Aitoubella/Freezer_FW/Firmware/Cold Storage/TouchGFX/assets/images/bat.png

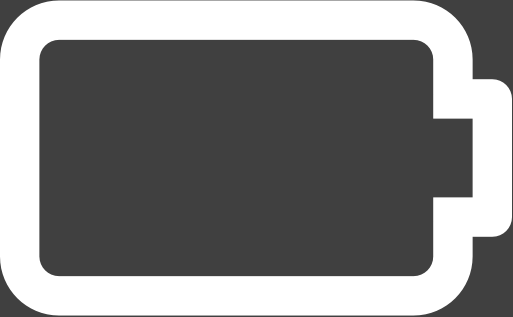
Firmware/Cold Storage/TouchGFX/assets/images/bat.png
