Aitoubella/Freezer_FW/Firmware/Cold Storage/TouchGFX/assets/images/charging.png

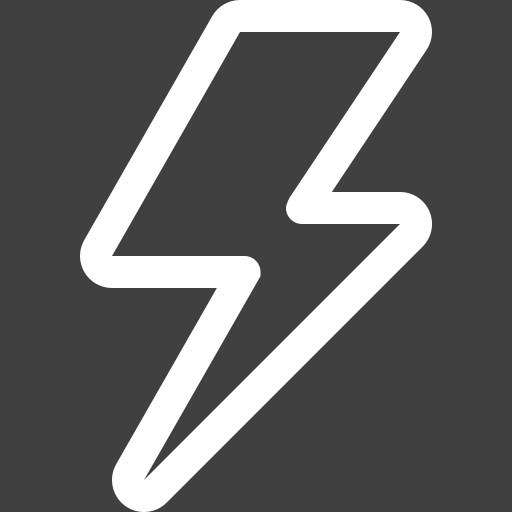
Firmware/Cold Storage/TouchGFX/assets/images/charging.png
