Aitoubella/Freezer_FW/Firmware/Cold Storage/TouchGFX/assets/images/main_speaker_on.png

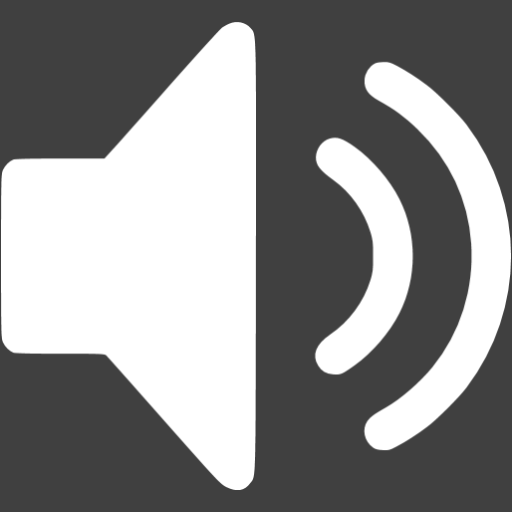
Firmware/Cold Storage/TouchGFX/assets/images/main_speaker_on.png
