Aitoubella/Freezer_FW/Hardware/Freezer_Controller/Fabrication files/Freezer_Controller_BOM.xlsx

LibRef | Designator | Quantity | Supplier 1 | Supplier Part Number 1
NS00832 | C1, C2, C11, C14, C15, C16, C26, C27, C35_1, C35_2, C35_3, C35_4, C35_5, C35_6, C38, C39, C40, C41, C43, C44, C45, C46, C47, C48, C54, C59, C60, C61, C62, C63, C64, C65, C76, C77, C80, C86 | 36 | Digi-Key | 1276-6767-1-ND
NS00871 | C3, C13, C52, C53 | 4 | Digi-Key | 1276-6470-1-ND
NS00848 | C4, C5, C6, C34_1, C34_2, C34_3, C34_4, C34_5, C34_6, C55, C56, C57, C58, C78, C79, C81, C82, C83, C84, C85, C88, C94 | 22 | Digi-Key | 445-172665-1-ND
NS00840 | C7, C8, C9, C10 | 4 | Digi-Key | 478-1175-1-ND
NS00353 | C12, C17, C22, C23, C24, C25, C36_1, C36_2, C36_3, C36_4, C36_5, C36_6, C37_1, C37_2, C37_3, C37_4, C37_5, C37_6, C71, C87 | 20 | Digi-Key | 478-1395-1-ND
NS00847 | C18, C19, C20, C21 | 4 | Digi-Key | 732-12187-1-ND
CMP-0001-00074-2 | C28, C30, C32, C70, C73, C74, C75 | 7 | Digi-Key | 399-C0402C104K4RAC7867TR-ND
Cap Semi | C29, C31, C33 | 3 | Digi-Key | 399-C1206C105K4RAC7800TR-ND
NS00911 | C42, C49 | 2 | Digi-Key | PCE5051CT-ND
NS00779 | C50, C51, C72 | 3 | Digi-Key | 1276-CL32Y106KCVZNWECT-ND
NS00824 | C66, C67, C68, C69 | 4 | Digi-Key | 1276-3137-1-ND
NS00857 | D1, D2, D5, D6, D7, D10 | 6 | Digi-Key | 112-V3PM10-M3/HCT-ND
NS00945 | D3, D8, D9 | 3 | Digi-Key | 3147-B1911USD-20D000114U1930CT-ND
NS00890 | D4 | 1 | Digi-Key | SMBJ28CAQ-13-FDICT-ND
NS00949 | F1 | 1 | Digi-Key | 283-3153-1-ND
NS00881 | FB1, FB2, FB3, FB4, FB5, FB6, FB7, FB11, FB12 | 9 | Digi-Key | 732-782853162CT-ND
NS00883 | FB10, FB16 | 2 | Digi-Key | 490-16523-1-ND
DS1307Z+ | IC1 | 1 | Digi-Key | DS1307Z+-ND
PCA9306DQER | IC2 | 1 | Digi-Key | 296-27957-2-ND
NS00813 | J1 | 1 | Digi-Key | FH34SRJ-50S-0.5SH(50)
Header 4X2 | J2 | 1 | Digi-Key | 900-2068320823-ND
NS00894 | J3 | 1 | Digi-Key | WM11767-ND
NS00337 | J4 | 1 | Digi-Key | WM2702-ND
NS00892 | J5 | 1 | Digi-Key | SAM8941-ND
NS00898 | J6 | 1 | Digi-Key | SAM10577-ND
NS00896 | J7 | 1 | Digi-Key | SAM8824-ND
CMP-11597-000004-1 | J8 | 1 | Digi-Key | HR1942TR-ND
NS00831 | L1, L4, L5 | 3 | Digi-Key | 553-3631-ND
NS00257 | L2, L3 | 2 | Digi-Key | 445-8644-1-ND
NS00042 | L6, L7, L8 | 3 | Digi-Key | SRF2012-900YATR-ND
NS00953 | L9 | 1 | Digi-Key | 553-PE-1210CCMC601STSCT-ND
Inductor | L10 | 1 | Digi-Key | 490-5622-2-ND
150060GS73220 | LED1 | 1 | Digi-Key | 732-11995-2-ND
CMP-231724-000001-1 | LS1 | 1 | Digi-Key | 668-1019-ND
Header 4 | P1 | 1 | Digi-Key | SAM1112-04-ND
NS00873 | Q1, Q3, Q4, Q6, Q7, Q8, Q9, Q11 | 8 | Digi-Key | DMN67D8L-7DICT-ND
NS00910 | Q2, Q5 | 2 | Digi-Key | DMP3056L-7DICT-ND
CMP-1048-01467-1 | Q10 | 1 | Digi-Key | BC547BFS-ND
NS00258 | R1, R6, R64, R65, R66, R113, R114 | 7 | Digi-Key | 36-5106CT-ND
NS00835 | R2, R5, R25, R50, R53, R62, R93, R96, R98, R99, R102, R118, R120, R122, R124 | 15 | Digi-Key | RMCF0603FT100KCT-ND
NS00882 | R3, R4, R70 | 3 | Digi-Key | RMCF0603FT1K00CT-ND
NS00820 | R7, R8, R21, R32_1, R32_2, R32_3, R32_4, R32_5, R32_6, R37, R38, R42, R45, R46, R48, R52, R55, R58, R60, R63, R71, R72, R73, R83, R84, R85, R86, R87, R88, R94, R100, R117 | 32 | Digi-Key | RMCF0603FT10K0CT-ND
NS00814 | R9, R10, R11, R13 | 4 | Digi-Key | 1292-WR06X68R0FTLCT-ND
NS00876 | R12, R14, R15, R16, R17, R18, R19, R20, R24, R44, R74, R75, R76, R77, R78, R79, R82, R89, R90, R91, R105, R108, R110, R126, R127 | 25 | Digi-Key | RMCF0603ZT0R00CT-ND
 | R29, R128, R129 | 3 | Digi-Key | TNPW040210K0BEED
Res3 | R22, R23, R26, R130, R131 | 9 | Digi-Key | 311-10KDTR-ND
RES | R132 | 1 | Digi-Key | A119933TR-ND
CMP-02407-007689-1 | R27 | 1 | Digi-Key | MCT0603-150-MBTR-ND
CMP-2000-04568-2 | R28 | 1 | Digi-Key | 311-20KDTR-ND
NS00884 | R30_1, R30_2, R30_3, R30_4, R30_5, R30_6 | 6 | Digi-Key | YAG2308CT-ND
NS00796 | R31_1, R31_2, R31_3, R31_4, R31_5, R31_6, R41, R54, R92 | 9 | Digi-Key | 1292-WR06X10R0FTLCT-ND
NS00885 | R33_1, R33_2, R33_3, R33_4, R33_5, R33_6, R35_1, R35_2, R35_3, R35_4, R35_5, R35_6 | 12 | Digi-Key | YAG1236CT-ND
NS00886 | R34_1, R34_2, R34_3, R34_4, R34_5, R34_6, R36_1, R36_2, R36_3, R36_4, R36_5, R36_6 | 12 | Digi-Key | YAG1555CT-ND
NS00834 | R39, R40, R51, R57, R95, R119, R121, R123 | 8 | Digi-Key | 1292-WR06X1502FTLCT-ND
NS00837 | R43, R56, R97, R101 | 4 | Digi-Key | RMCF0603FT300KCT-ND
NS00875 | R47, R49, R59, R61 | 4 | Digi-Key | 311-2.00MHRCT-ND
NS00870 | R67, R68, R80, R81, R103, R104, R115, R116 | 8 | Digi-Key | RMCF0603FT100RCT-ND
NS00946 | R69, R106, R107 | 3 | Digi-Key | 738-RMCF1206FT2R00CT-ND
NS00821 | R109 | 1 | Digi-Key | RMCF0603FT191KCT-ND
NS00822 | R111 | 1 | Digi-Key | RMCF0603FT42K2
NS00823 | R112, R125 | 2 | Digi-Key | RMCF0603FT26K7
CMP-17879-000003-1 | S1 | 1 | Digi-Key | EG4344TR-ND
NS00879 | U1 | 1 | Digi-Key | PAM8304AYRDICT-ND
NS00922 | U2 | 1 | Digi-Key | MT25QL512ABB8E12-0AUT-ND
CMP-1655-00015-2 | U3 | 1 | Digi-Key | 497-15873-ND
3034 | U4 | 1 | Digi-Key | 36-3034-ND
NS00864 | U6_1, U6_2, U6_3, U6_4, U6_5, U6_6, U7, U8, U16 | 9 | Digi-Key | LM2904QS-13DICT-ND
NS00913 | U9, U12, U13, U14, U15, U19 | 6 | Digi-Key | 283-STSP84050U800CT-ND
NS00912 | U10 | 1 | Digi-Key | 296-35520-1-ND
NS00919 | U11 | 1 | Digi-Key | MCP1501T-10E/CHYCT-ND
NS00880 | U18 | 1 | Digi-Key | 497-1222-1-ND
CMP-05722-000278-1 | U20 | 1 | Digi-Key | MAXM17503ALJ+-ND
ABS07W-32.768KHZ-J-1-T | Y1 | 1 | Digi-Key | XC2745TR-ND
ABS07-32.768KHZ-T | Y2 | 1 | Digi-Key | 535-9542-2-ND
