Aitoubella/Freezer_FW/X-cool connection guide/20231208_X-COOL CONNECTION GUIDE .pdf

# X-COOL CONNECTION GUIDE

## (Controller and Power Board)

1.Power board and Controller board Connection

- 12 Pin Connector

The power board and controller board are connected to each other with a cable through a 12 pin header.

The newly designed Version 2 ensures consistency of all nets of the 12 pin header.

The connection method is as follows.

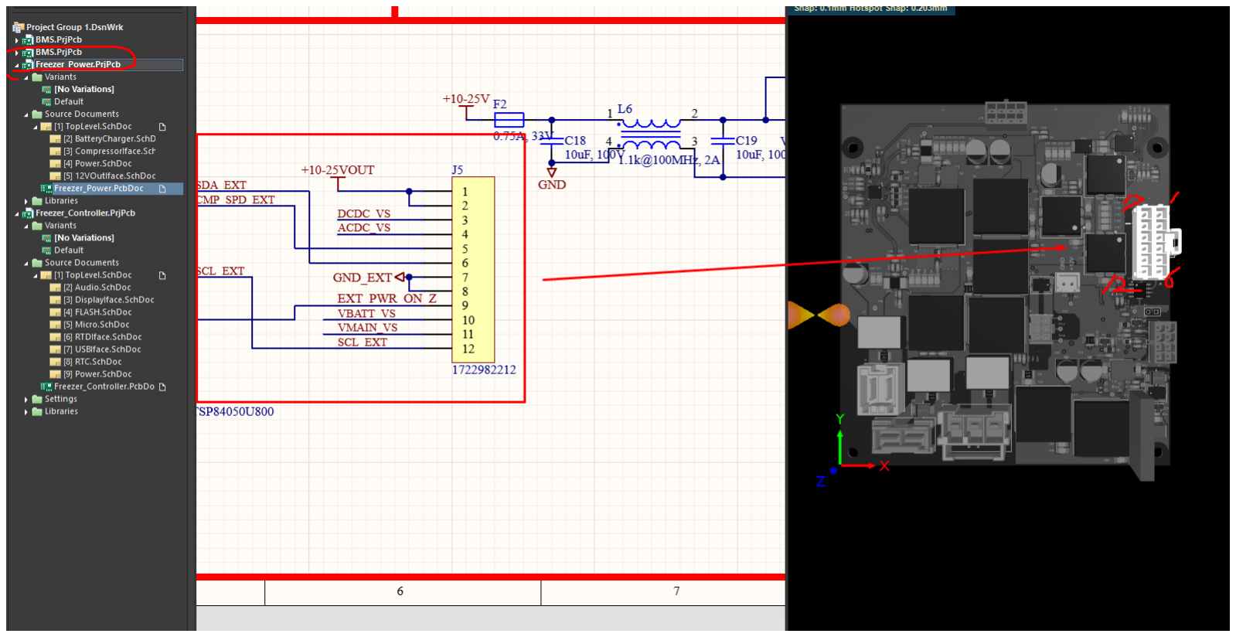
[picture p9: figure]

Figure 1. Power Board J5 Connector

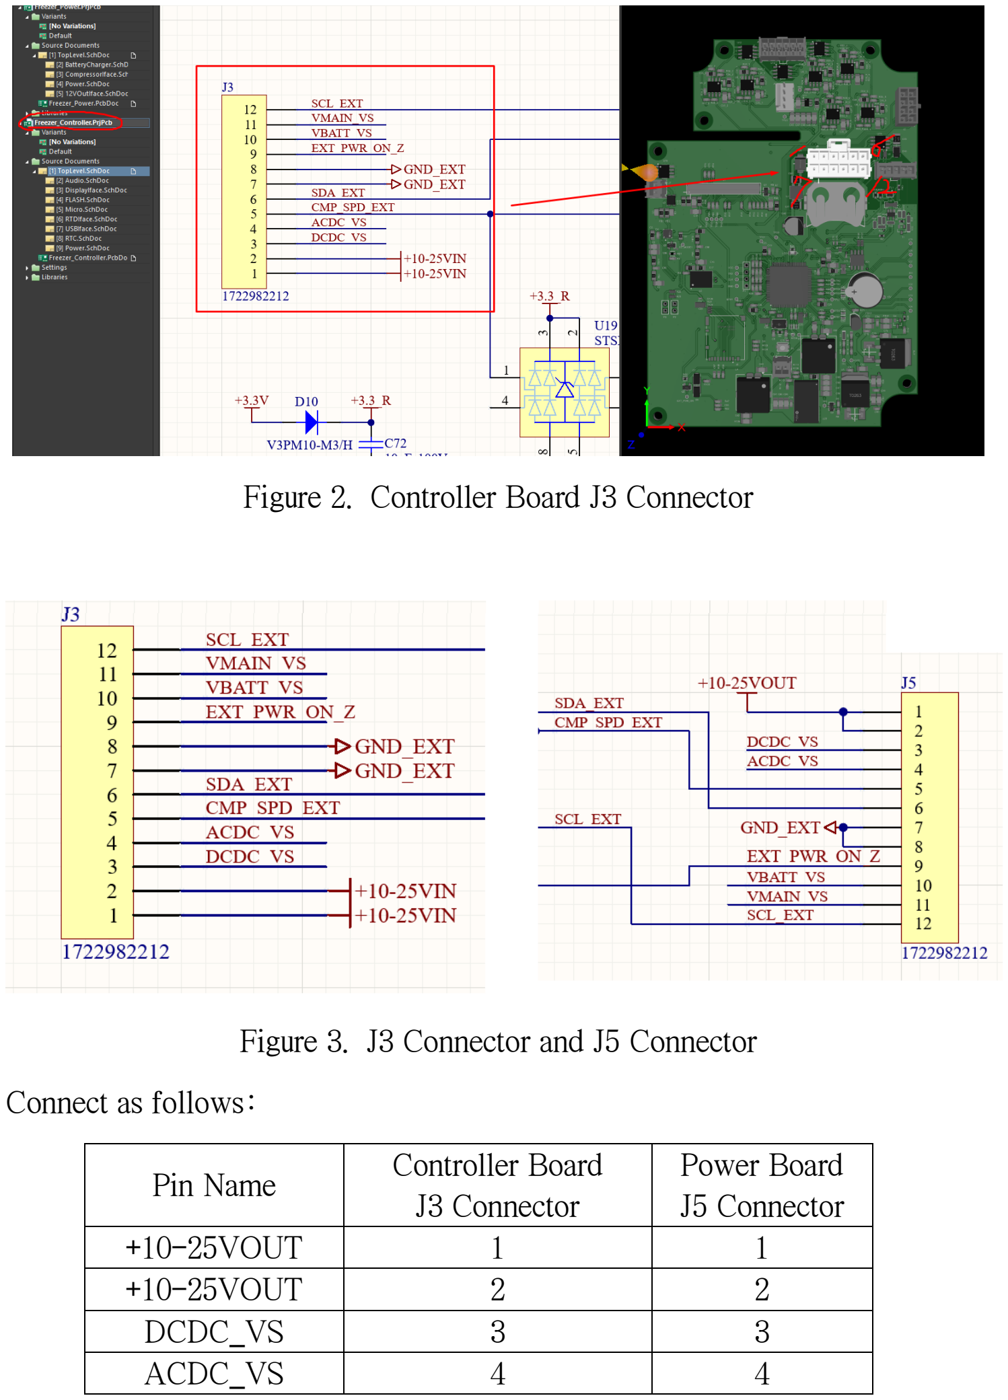
[picture p10: page 3]

Figure 2. Controller Board J3 Connector

Figure 3. J3 Connector and J5 Connector

Connect as follows:

Pin Name | Controller Board J3 Connector | Power Board J5 Connector
+10-25VOUT | 1 | 1
+10-25VOUT | 2 | 2
DCDC_VS | 3 | 3
ACDC_VS | 4 | 4

CMP_SPD_EXT | 5 | 5
SDA_EXT | 6 | 6
GND_EXT | 7 | 7
GND_EXT | 8 | 8
EXT_PWR_ON_Z | 9 | 9
VBATT_VS | 10 | 10
VMAIN_VS | 11 | 11
SCL_EXT | 12 | 12
Table 1. 12 Pin connector
- 8 Pin Connector

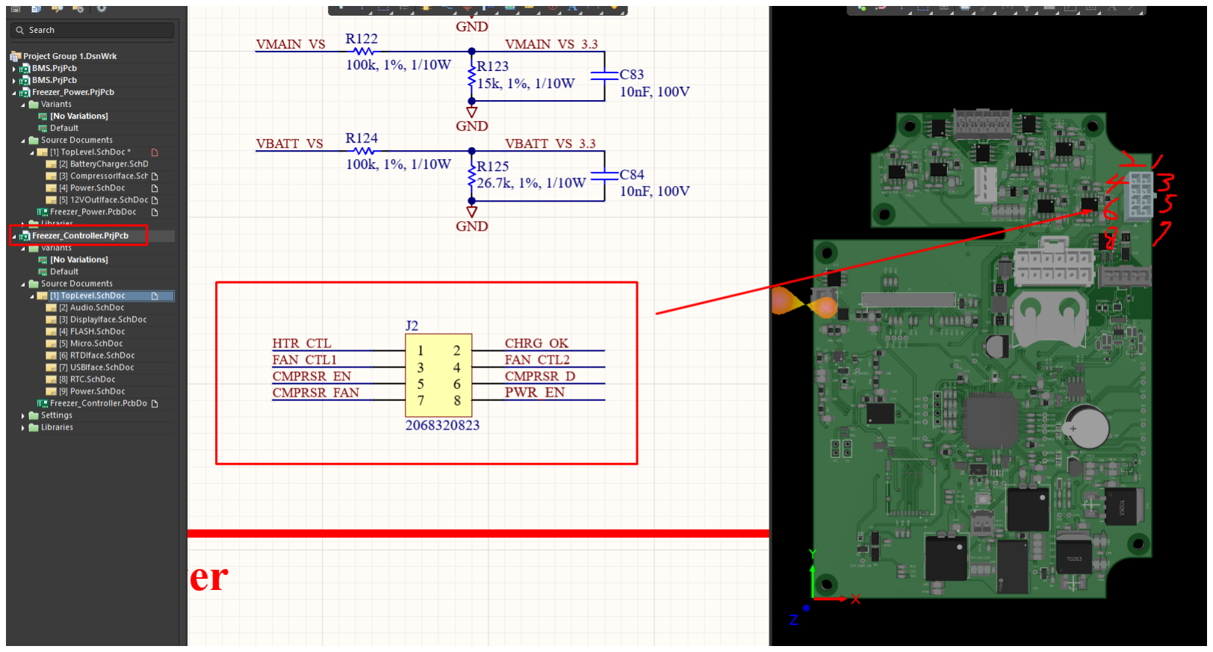
[picture p11: figure]

Figure 4. Controller Board J2 Connector

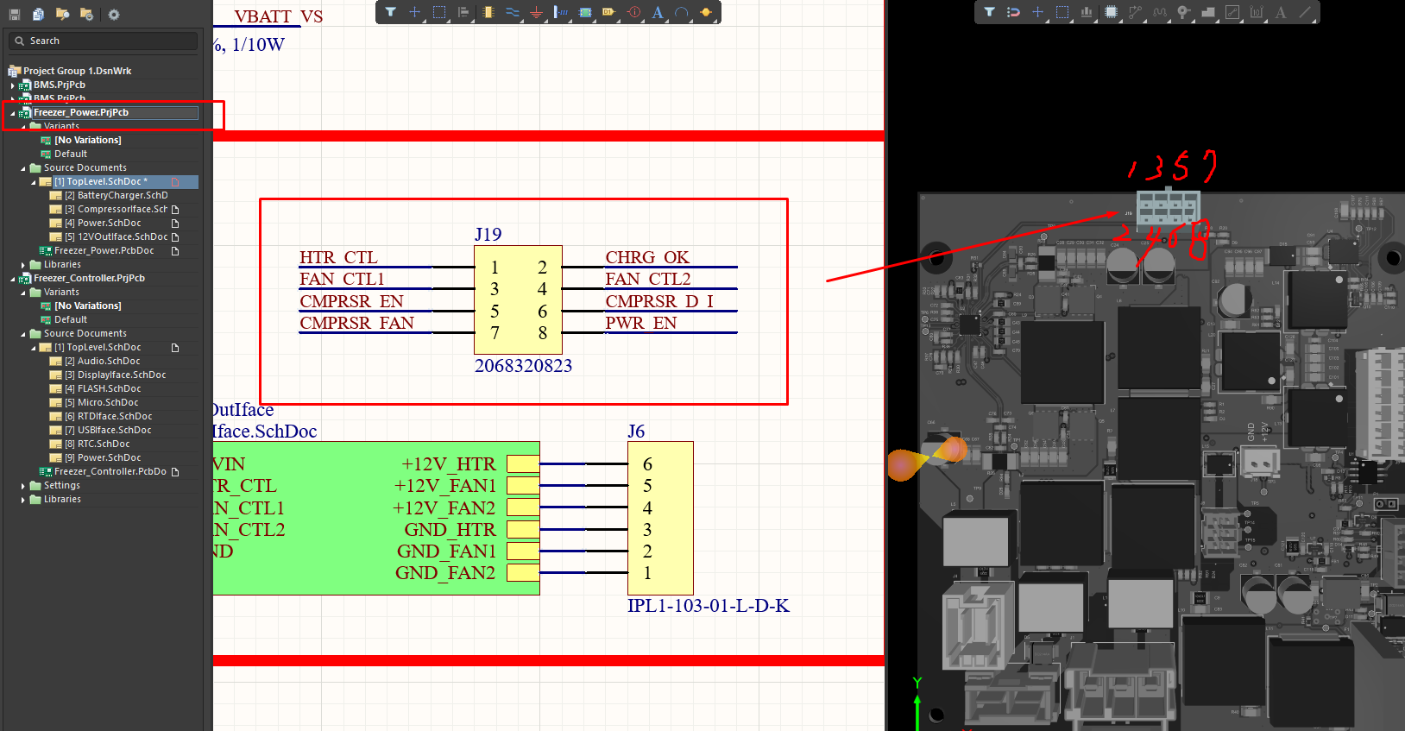
[picture p12: figure]

Figure 5. Power Board J19 Connector

Connect as follows:

Pin Name | Controller Board J2 Connector | Power Board J19 Connector
HTR_CTL | 1 | 1
CHRG_OK | 2 | 2
FAN_CTL1 | 3 | 3
FAN_CTL2 | 4 | 4
CMPRSR_EN | 5 | 5
CMPRSR_D | 6 | 6
CMPRSR_FAN | 7 | 7
PWR_EN | 8 | 8
Table 2. 8 Pin Connector

### 2.Controller Board

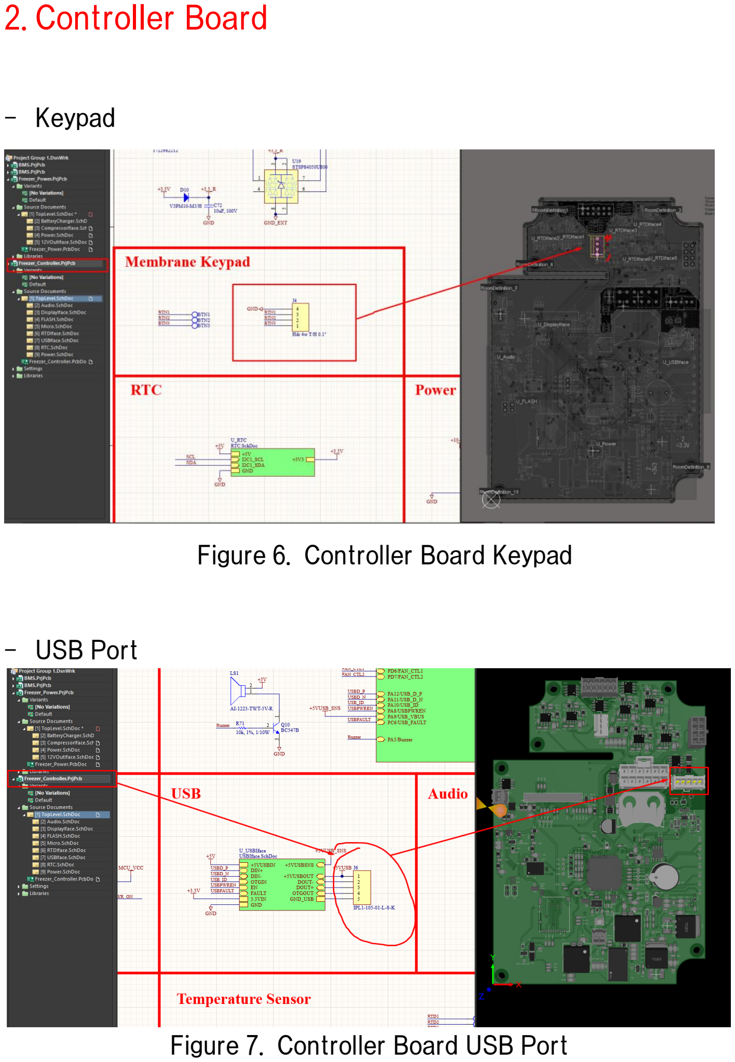
[picture p13: page 6]

- Keypad

Figure 6. Controller Board Keypad

- USB Port

Figure 7. Controller Board USB Port

- RTD Connector

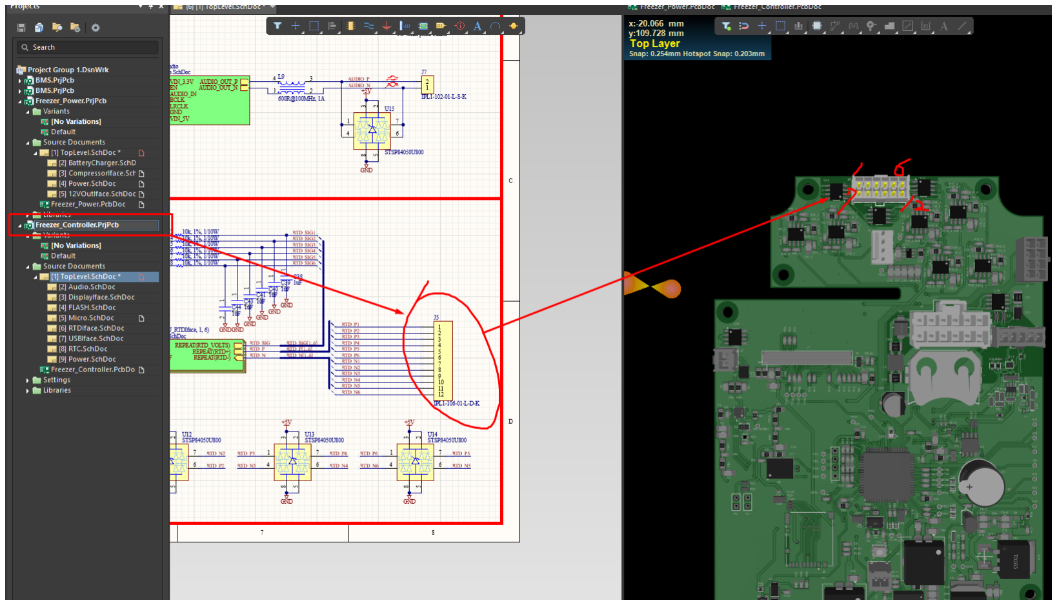
[picture p14: figure]

Figure 8. Controller Board RTD Connector

Currently, RTD6 is used for the temperature sensor and RTD4 is used for the Lid Switch.

Which channel to use can be modified in Firmware.

For example, if you want to use the temperature sensor RTD6 as RTD2, change line 41 of the main_app.c file to RTD2.

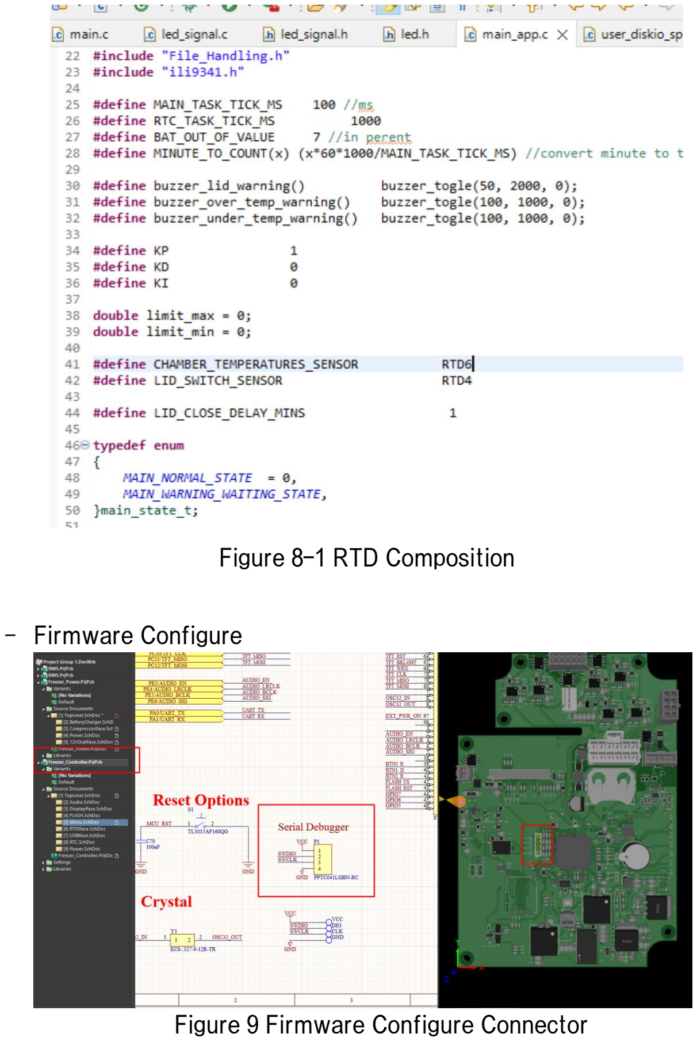
[picture p15: page 8]

Figure 8-1 RTD Composition

- Firmware Configure

Figure 9 Firmware Configure Connector

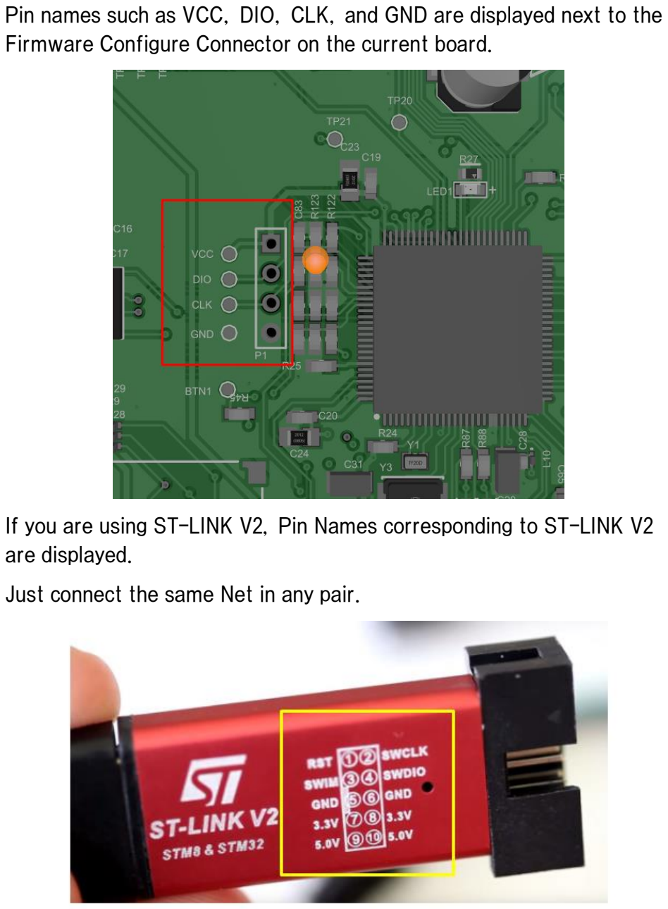
[picture p16: page 9]

Pin names such as VCC, DIO, CLK, and GND are displayed next to the Firmware Configure Connector on the current board.

If you are using ST-LINK V2, Pin Names corresponding to ST-LINK V2 are displayed.

Just connect the same Net in any pair.

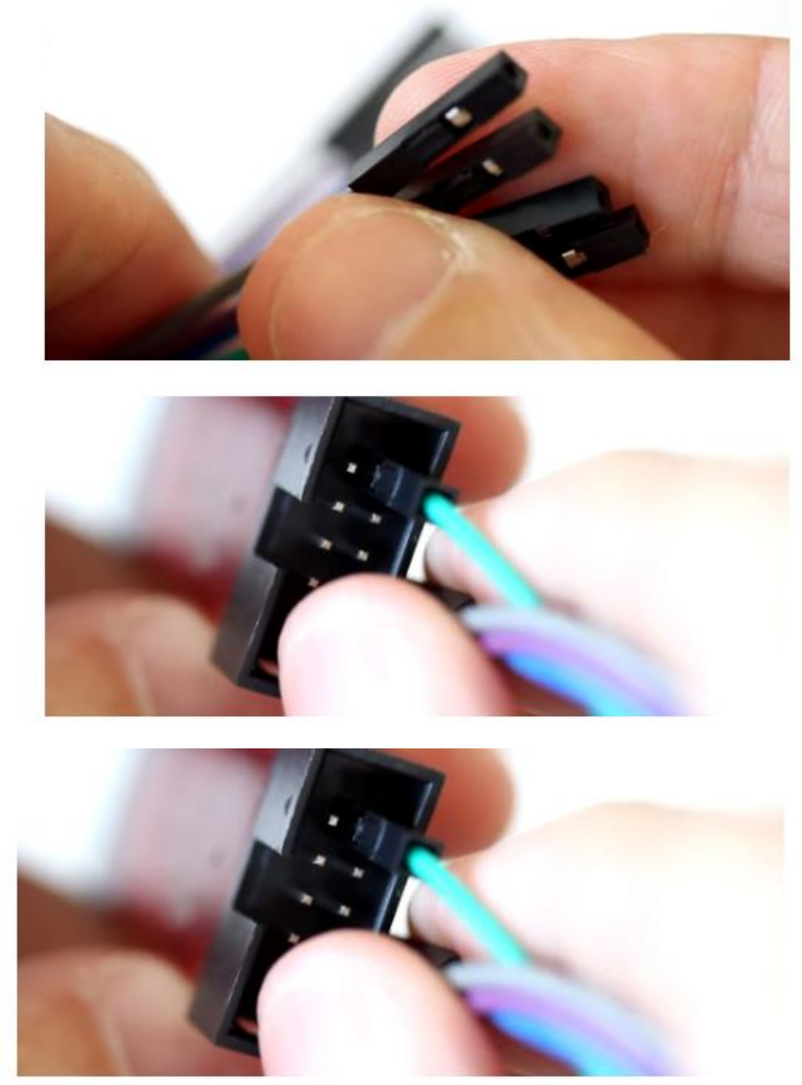
[picture p17: page 10]
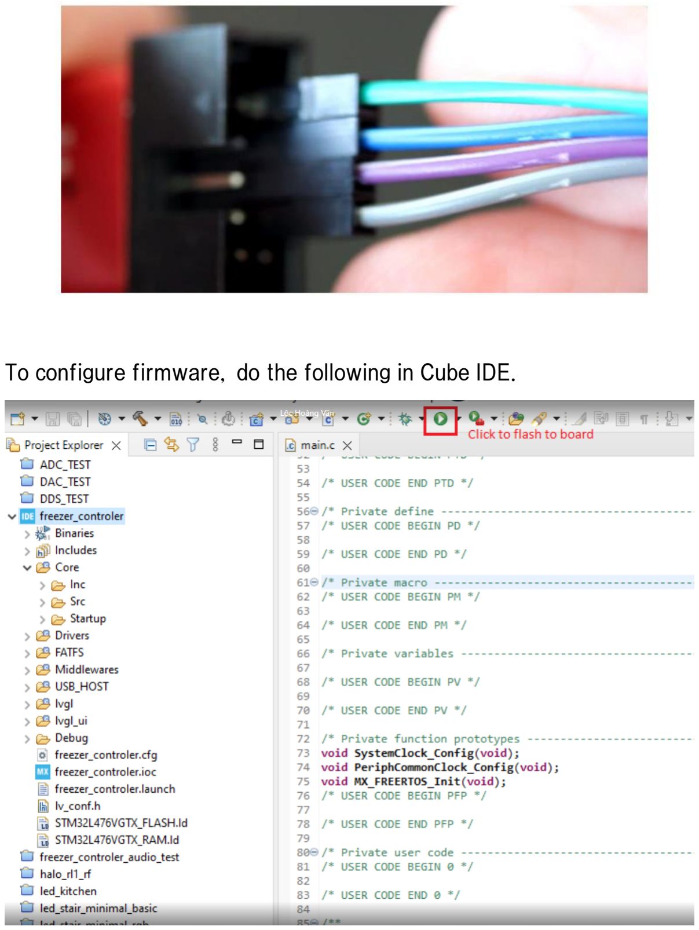
[picture p18: page 11]

To configure firmware, do the following in Cube IDE.

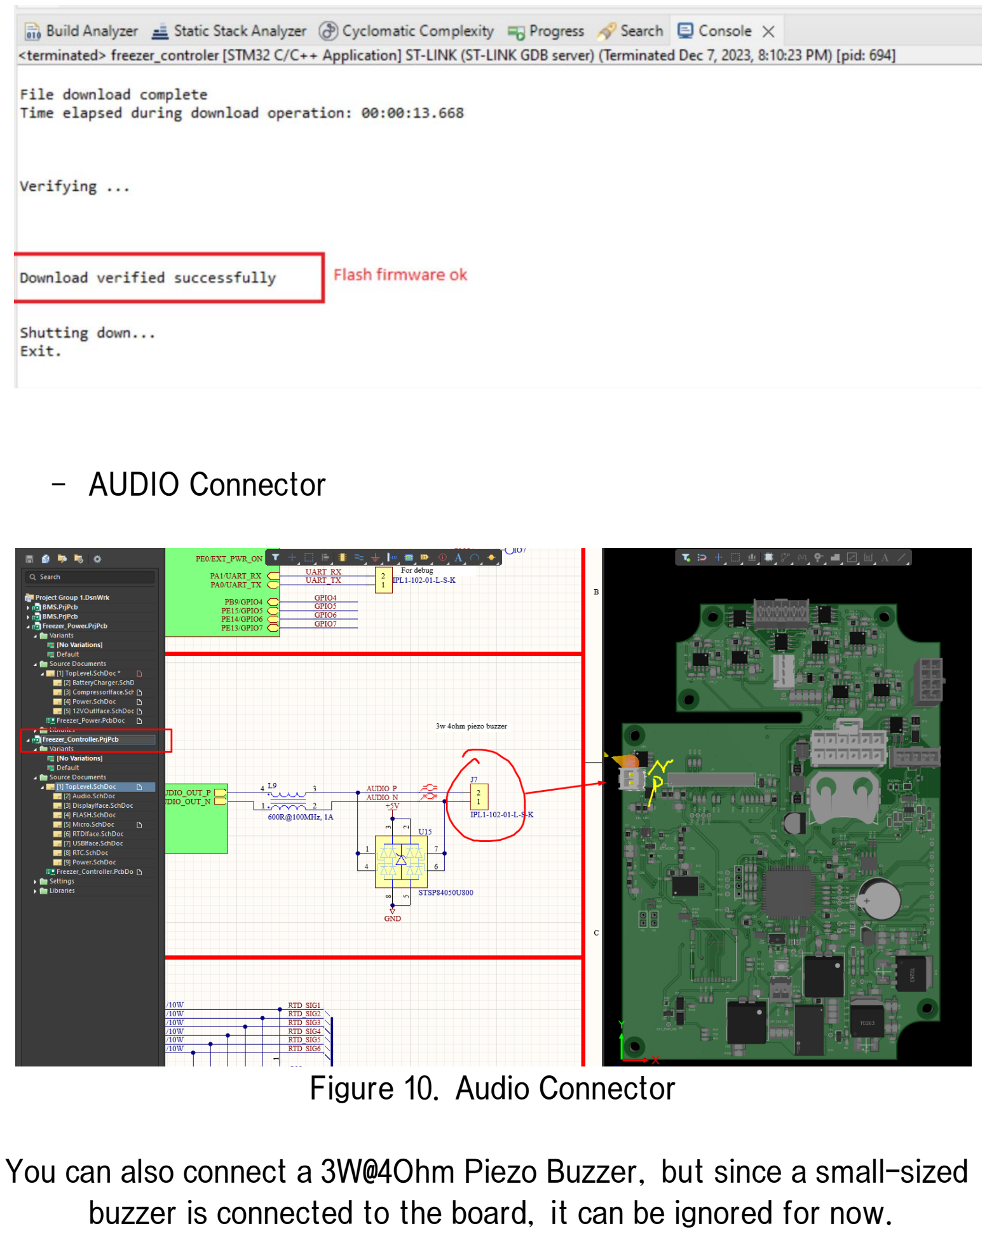
[picture p19: page 12]

- AUDIO Connector

Figure 10. Audio Connector

You can also connect a 3W@4Ohm Piezo Buzzer, but since a small-sized buzzer is connected to the board, it can be ignored for now.

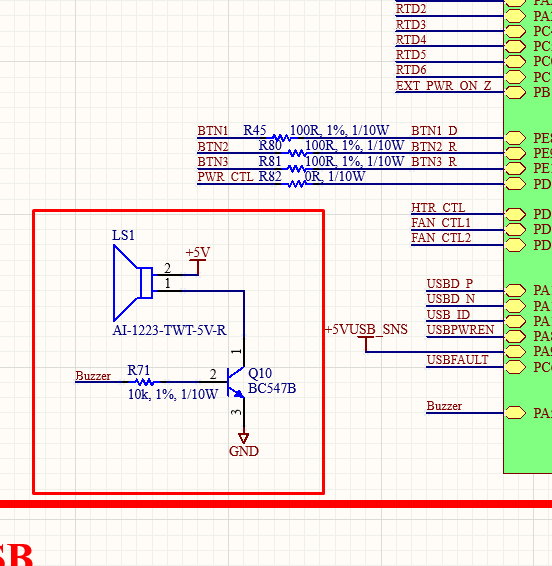
[picture p20: figure]

### 3.Power Board

- Compressor Connector

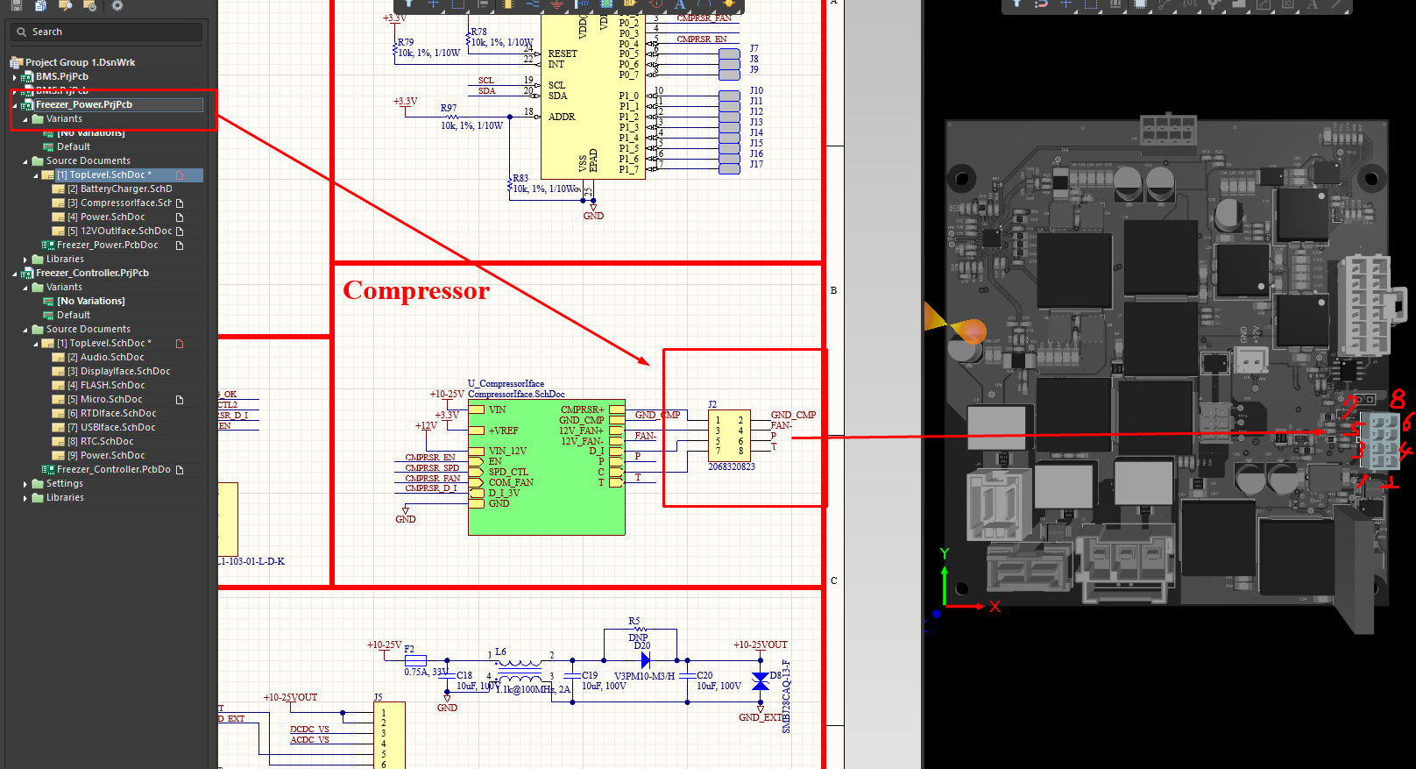
[picture p21: figure]

Figure 11. Compressor Connector

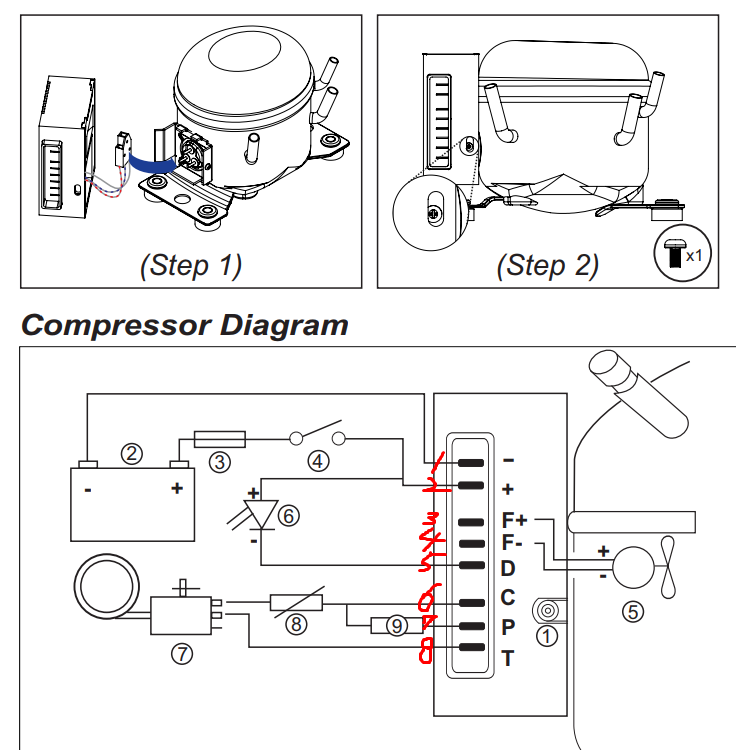
[picture p22: figure]

Figure 11-1 NL25-C3 Compressor Driver Number

Connect as follows:

Pin Name | Power Board J2 Connector | NL25-C3 Compressor Driver
CMPRSR+ | 1 | 2
GND_CMP | 2 | 1
12V_FAN+ | 3 | 3
FAN- | 4 | 4
D_I | 5 | 4
P | 6 | 7
C | 7 | 6

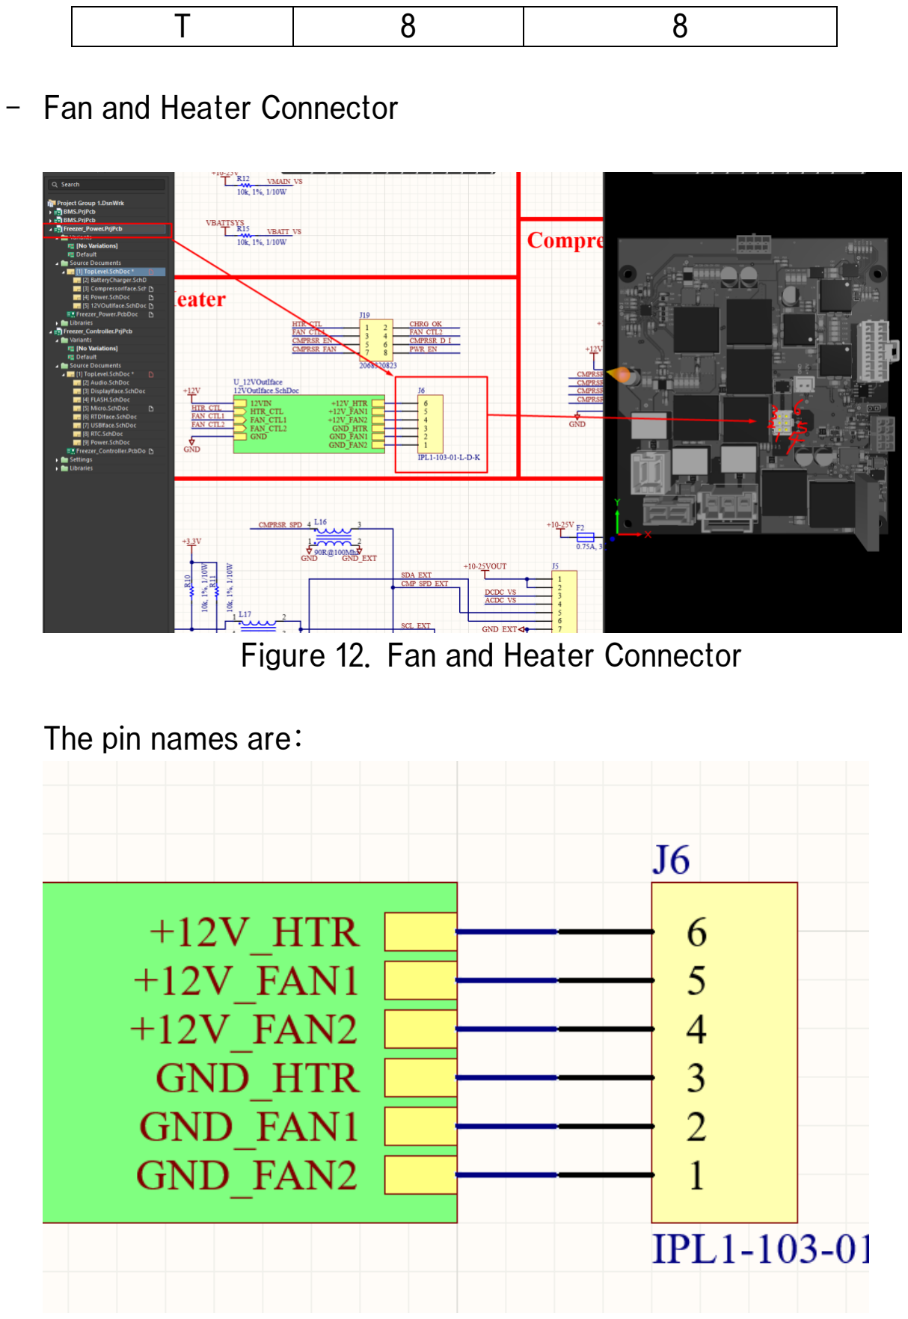
[picture p23: page 16]

T | 8 | 8
- Fan and Heater Connector

Figure 12. Fan and Heater Connector

The pin names are:

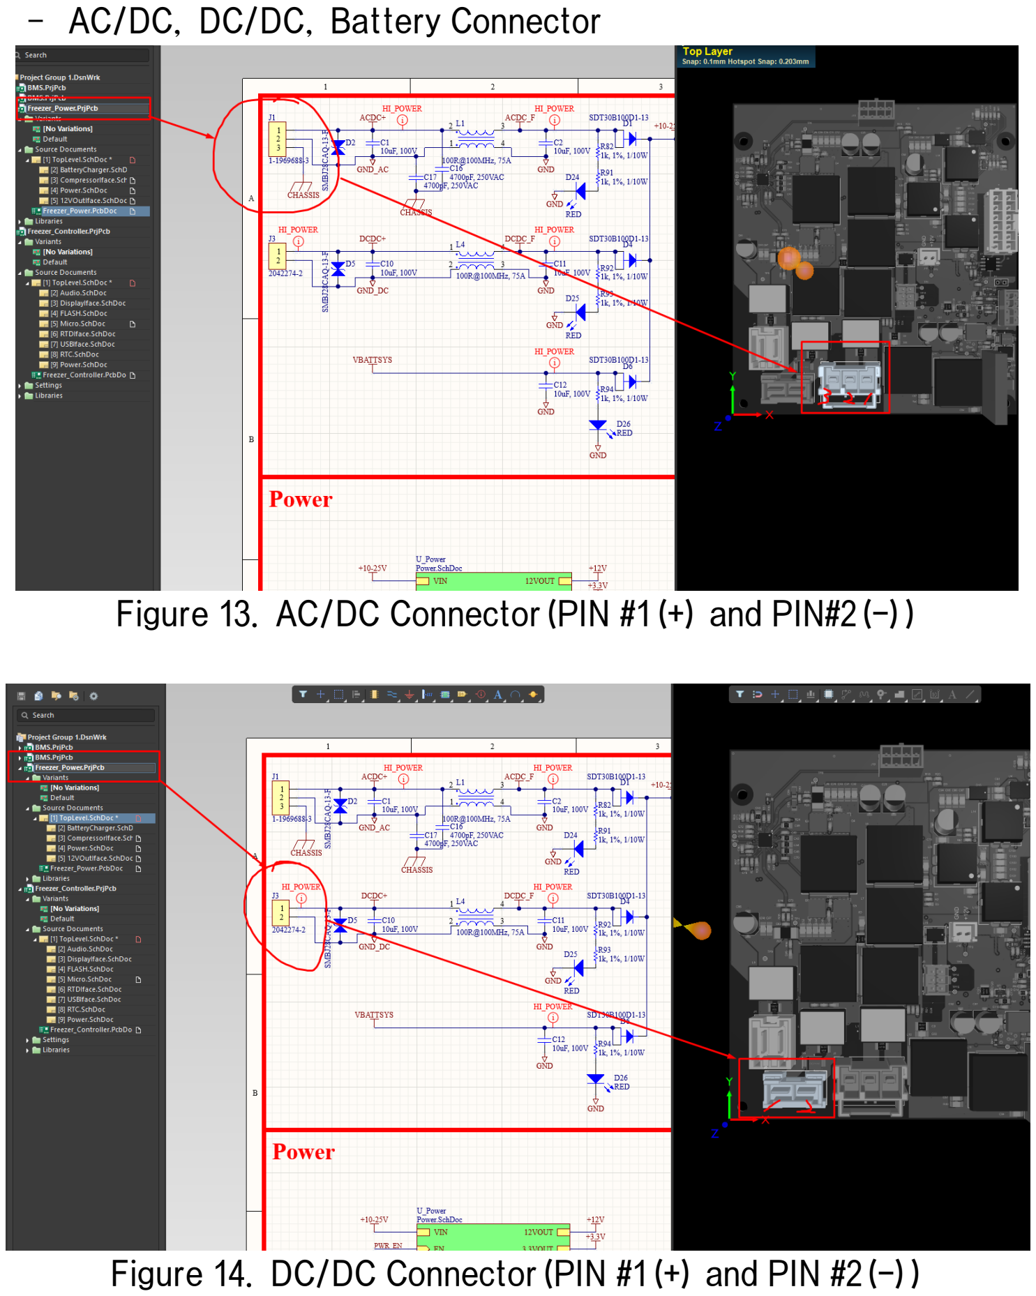
[picture p24: page 17]

- AC/DC, DC/DC, Battery Connector

Figure 13. AC/DC Connector(PIN #1(+) and PIN#2(-))

Figure 14. DC/DC Connector(PIN #1(+) and PIN #2(-))

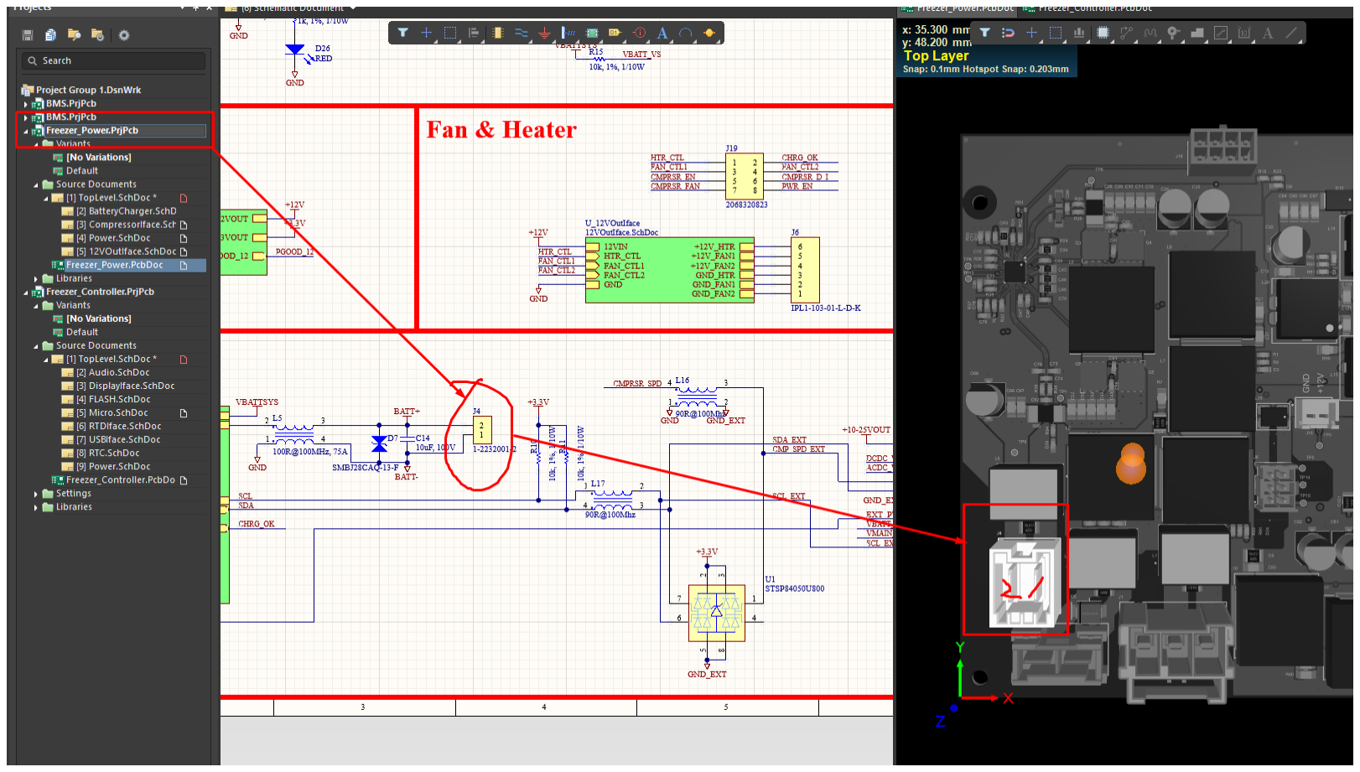
[picture p25: figure]

Figure 15. Battery Connector(PIN #2(+) and PIN#1(-))
