Aitoubella/Freezer_FW/Firmware/LCD test-F103/lvgl/tests/ref_imgs/dropdown_1.png

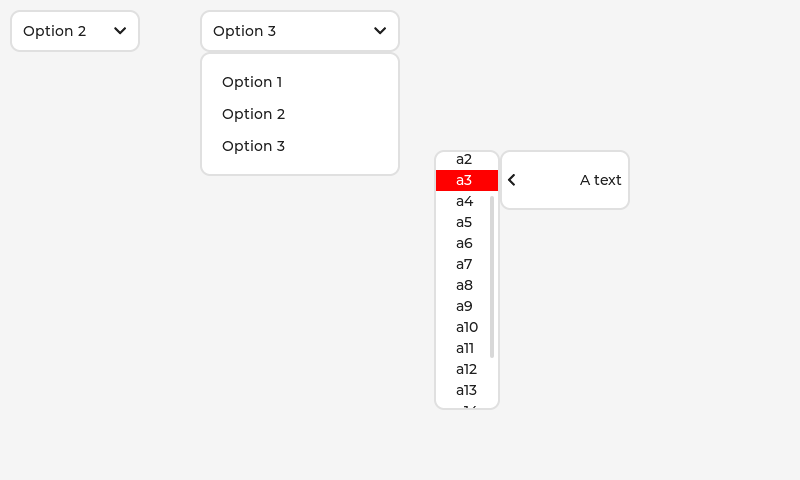
Firmware/LCD test-F103/lvgl/tests/ref_imgs/dropdown_1.png
