Aitoubella/Freezer_FW/Hardware/Harness cable drawing/BATTERY TO POWER BOARD(BLG-365_R04).pdf

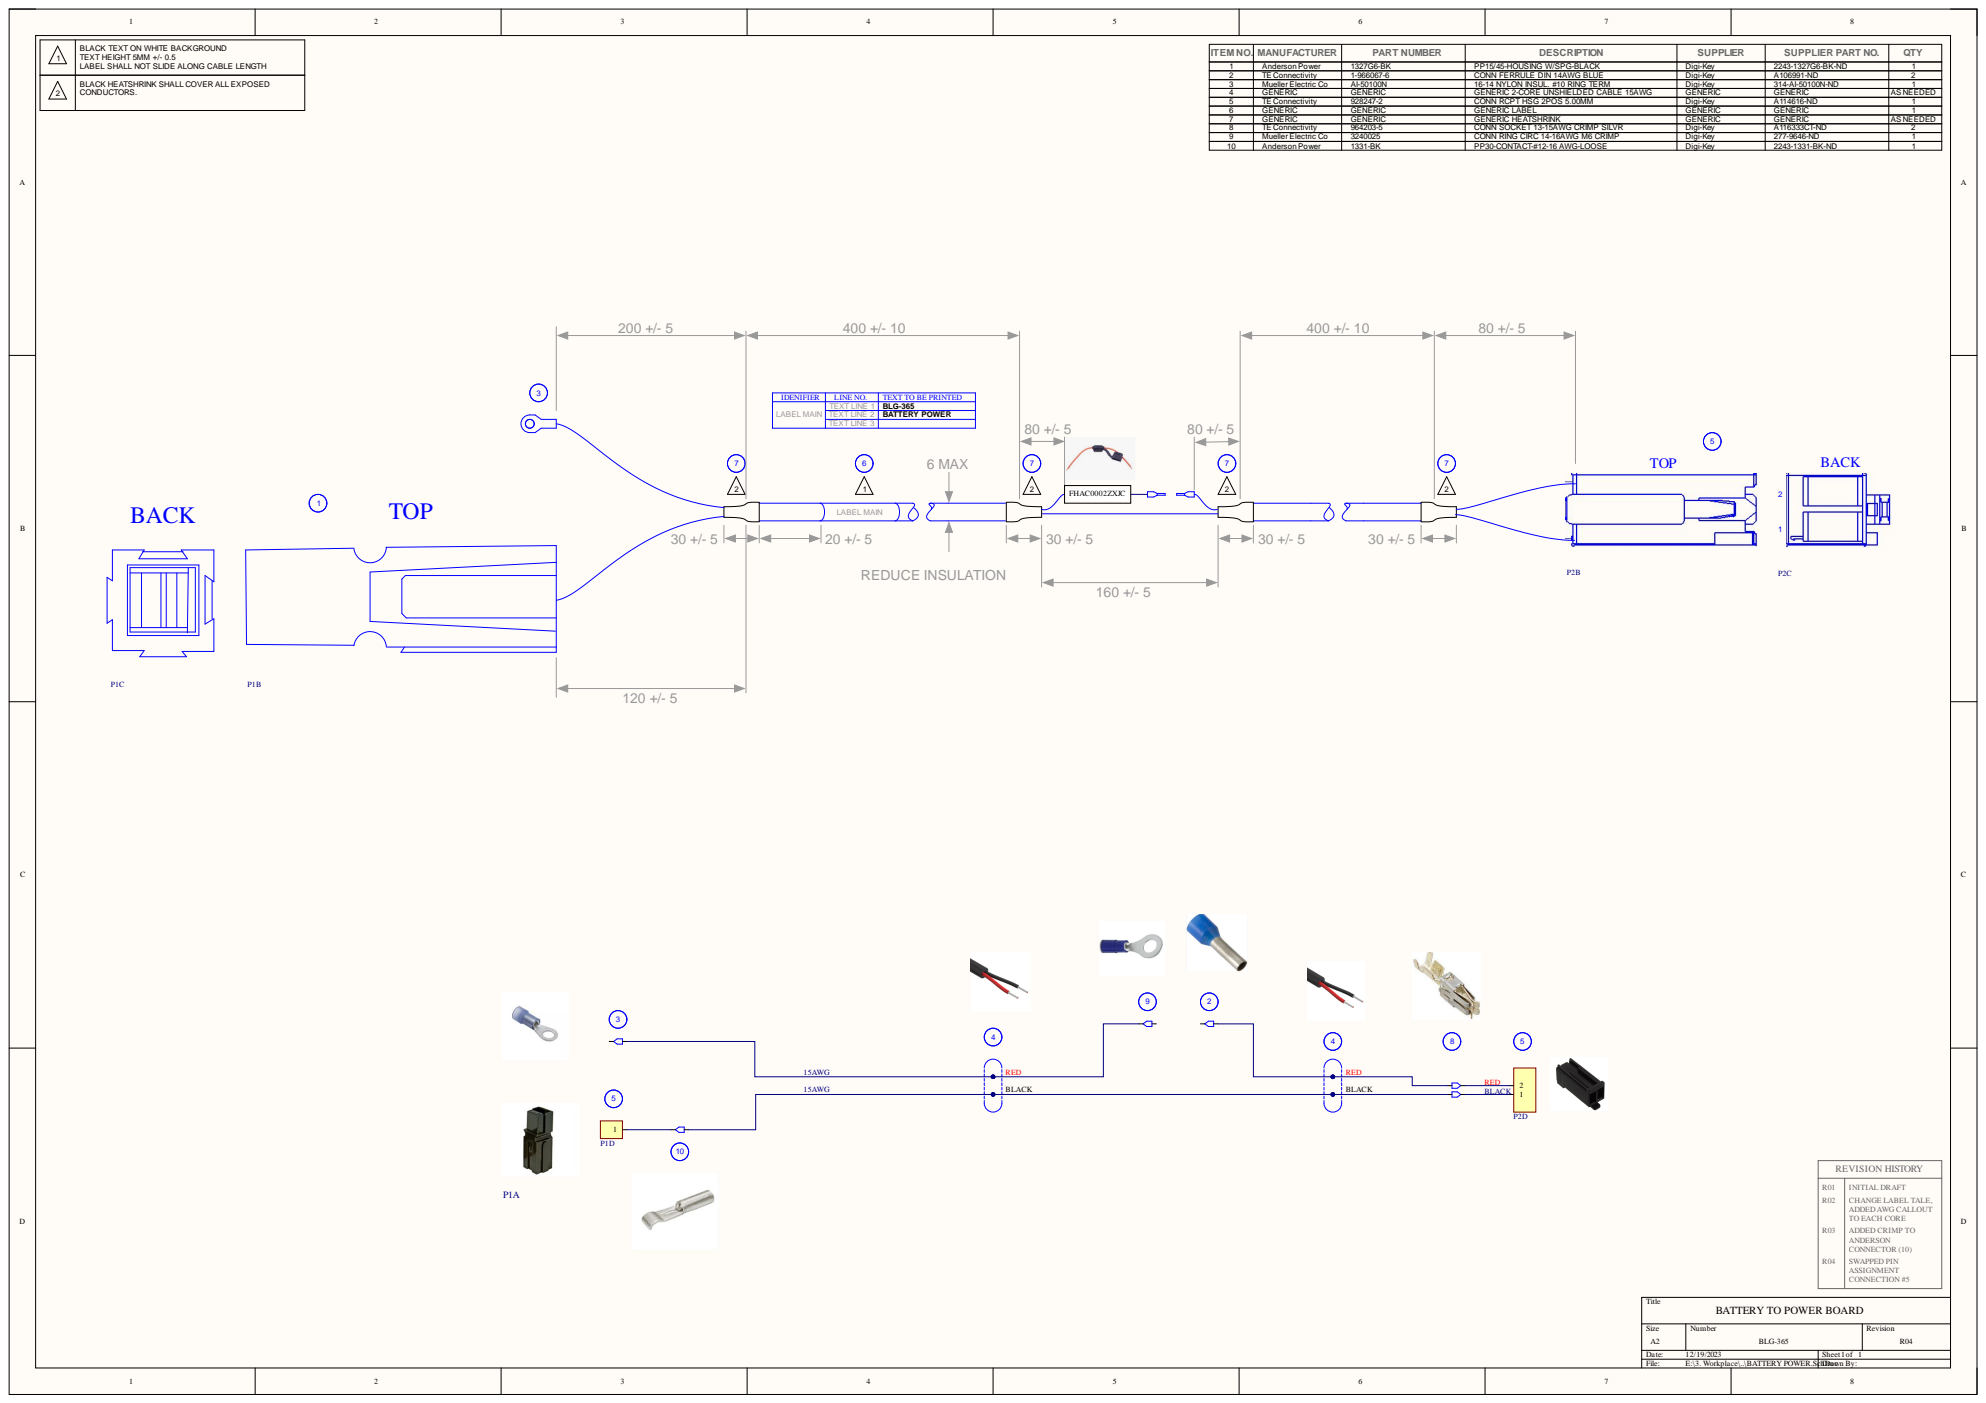
[picture p54: page 1]

BLACK TEXT ON WHITE BACKGROUND
TEXT HEIGHT 5MM +/- 0.5
LABEL SHALL NOT SLIDE ALONG CABLE LENGTH

BLACK HEATSHRINK SHALL COVER ALL EXPOSED
CONDUCTORS.

LABEL MAIN | TEXT LINE 1 | BLG-365

TEXT LINE 2 | BATTERY POWER
TEXT LINE 3

BATTERY TO POWER BOARD
