Aitoubella/Freezer_FW/Hardware/Harness cable drawing/DC-DC TO POWER BOARD (BLG-364_R03).pdf

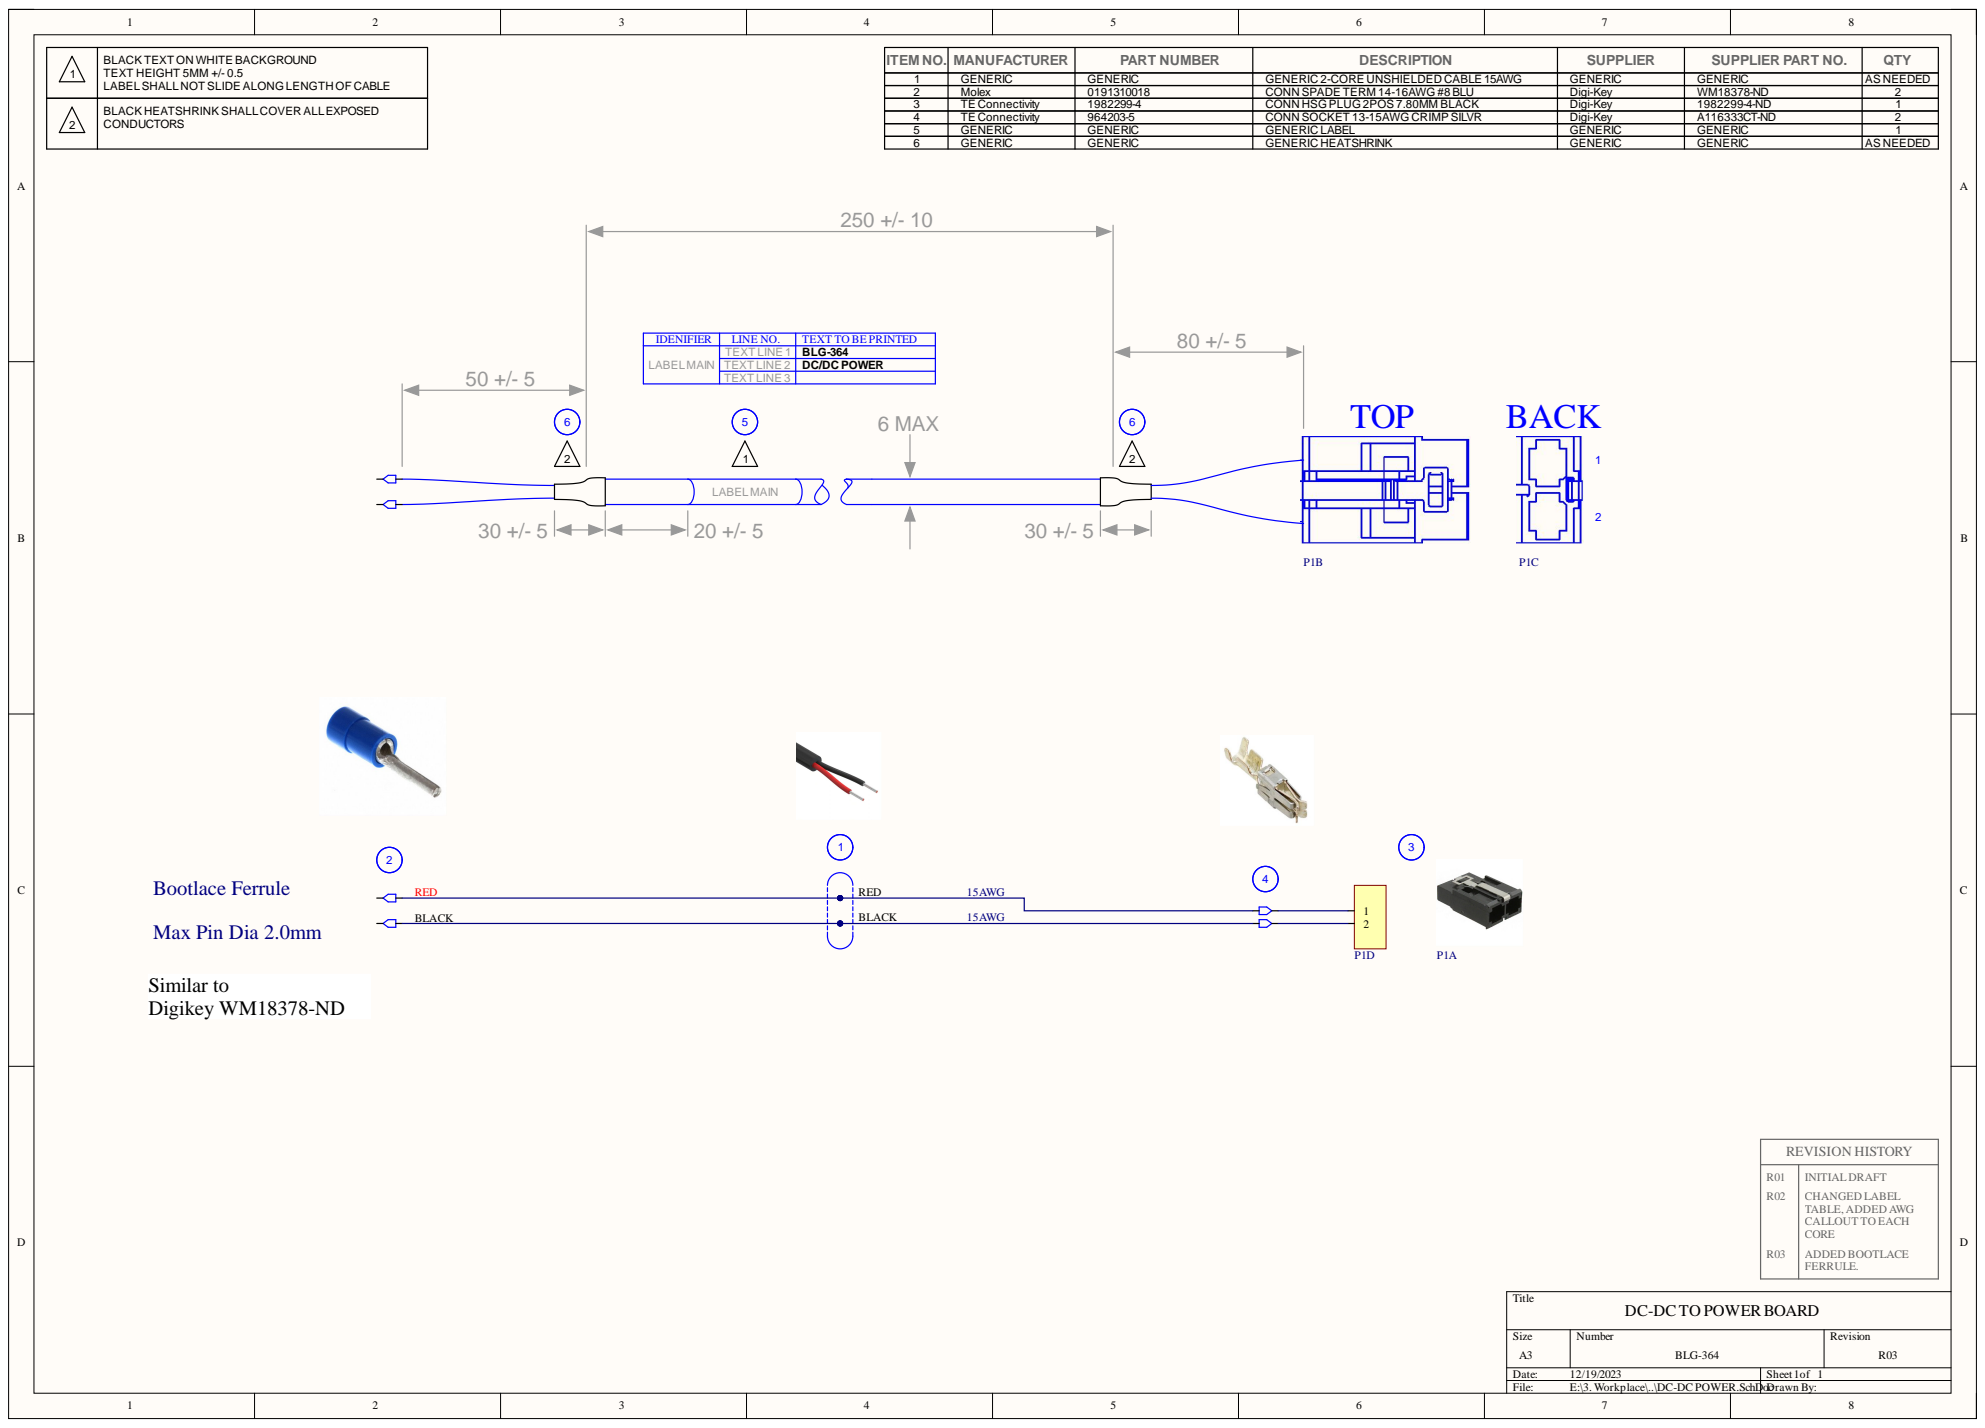
[picture p55: page 1]

BLACK TEXT ON WHITE BACKGROUND
TEXT HEIGHT 5MM +/- 0.5
LABELSHALLNOT SLIDE ALONG LENGTH OF CABLE

1 | GENERIC | GENERIC | GENERIC 2-CORE UNSHIELDED CABLE 15AWG | GENERIC | GENERIC | AS NEEDED
2 | Molex | 0191310018 | CONN SPADE TERM 14-16AWG #8 BLU | Digi-Key | WM18378-ND | 2

BLACK HEATSHRINK SHALLCOVER ALLEXPOSED
CONDUCTORS

4 | TE Connectivity | 964203-5 | CONN SOCKET 13-15AWG CRIMP SILVR | Digi-Key | A116333CT-ND | 2
5 | GENERIC | GENERIC | GENERIC LABEL | GENERIC | GENERIC | 1
6 | GENERIC | GENERIC | GENERIC HEATSHRINK | GENERIC | GENERIC | AS NEEDED

IDENIFIER | LINE NO. | TEXT TO BE PRINTED
LABELMAIN | TEXT LINE 1 | BLG-364

TEXT LINE 2 | DC/DC POWER
TEXT LINE 3

DC-DC TO POWER BOARD
