Aitoubella/Freezer_FW/Hardware/Harness cable drawing/PANEL TO DC-DC (BLG-363_R04).pdf

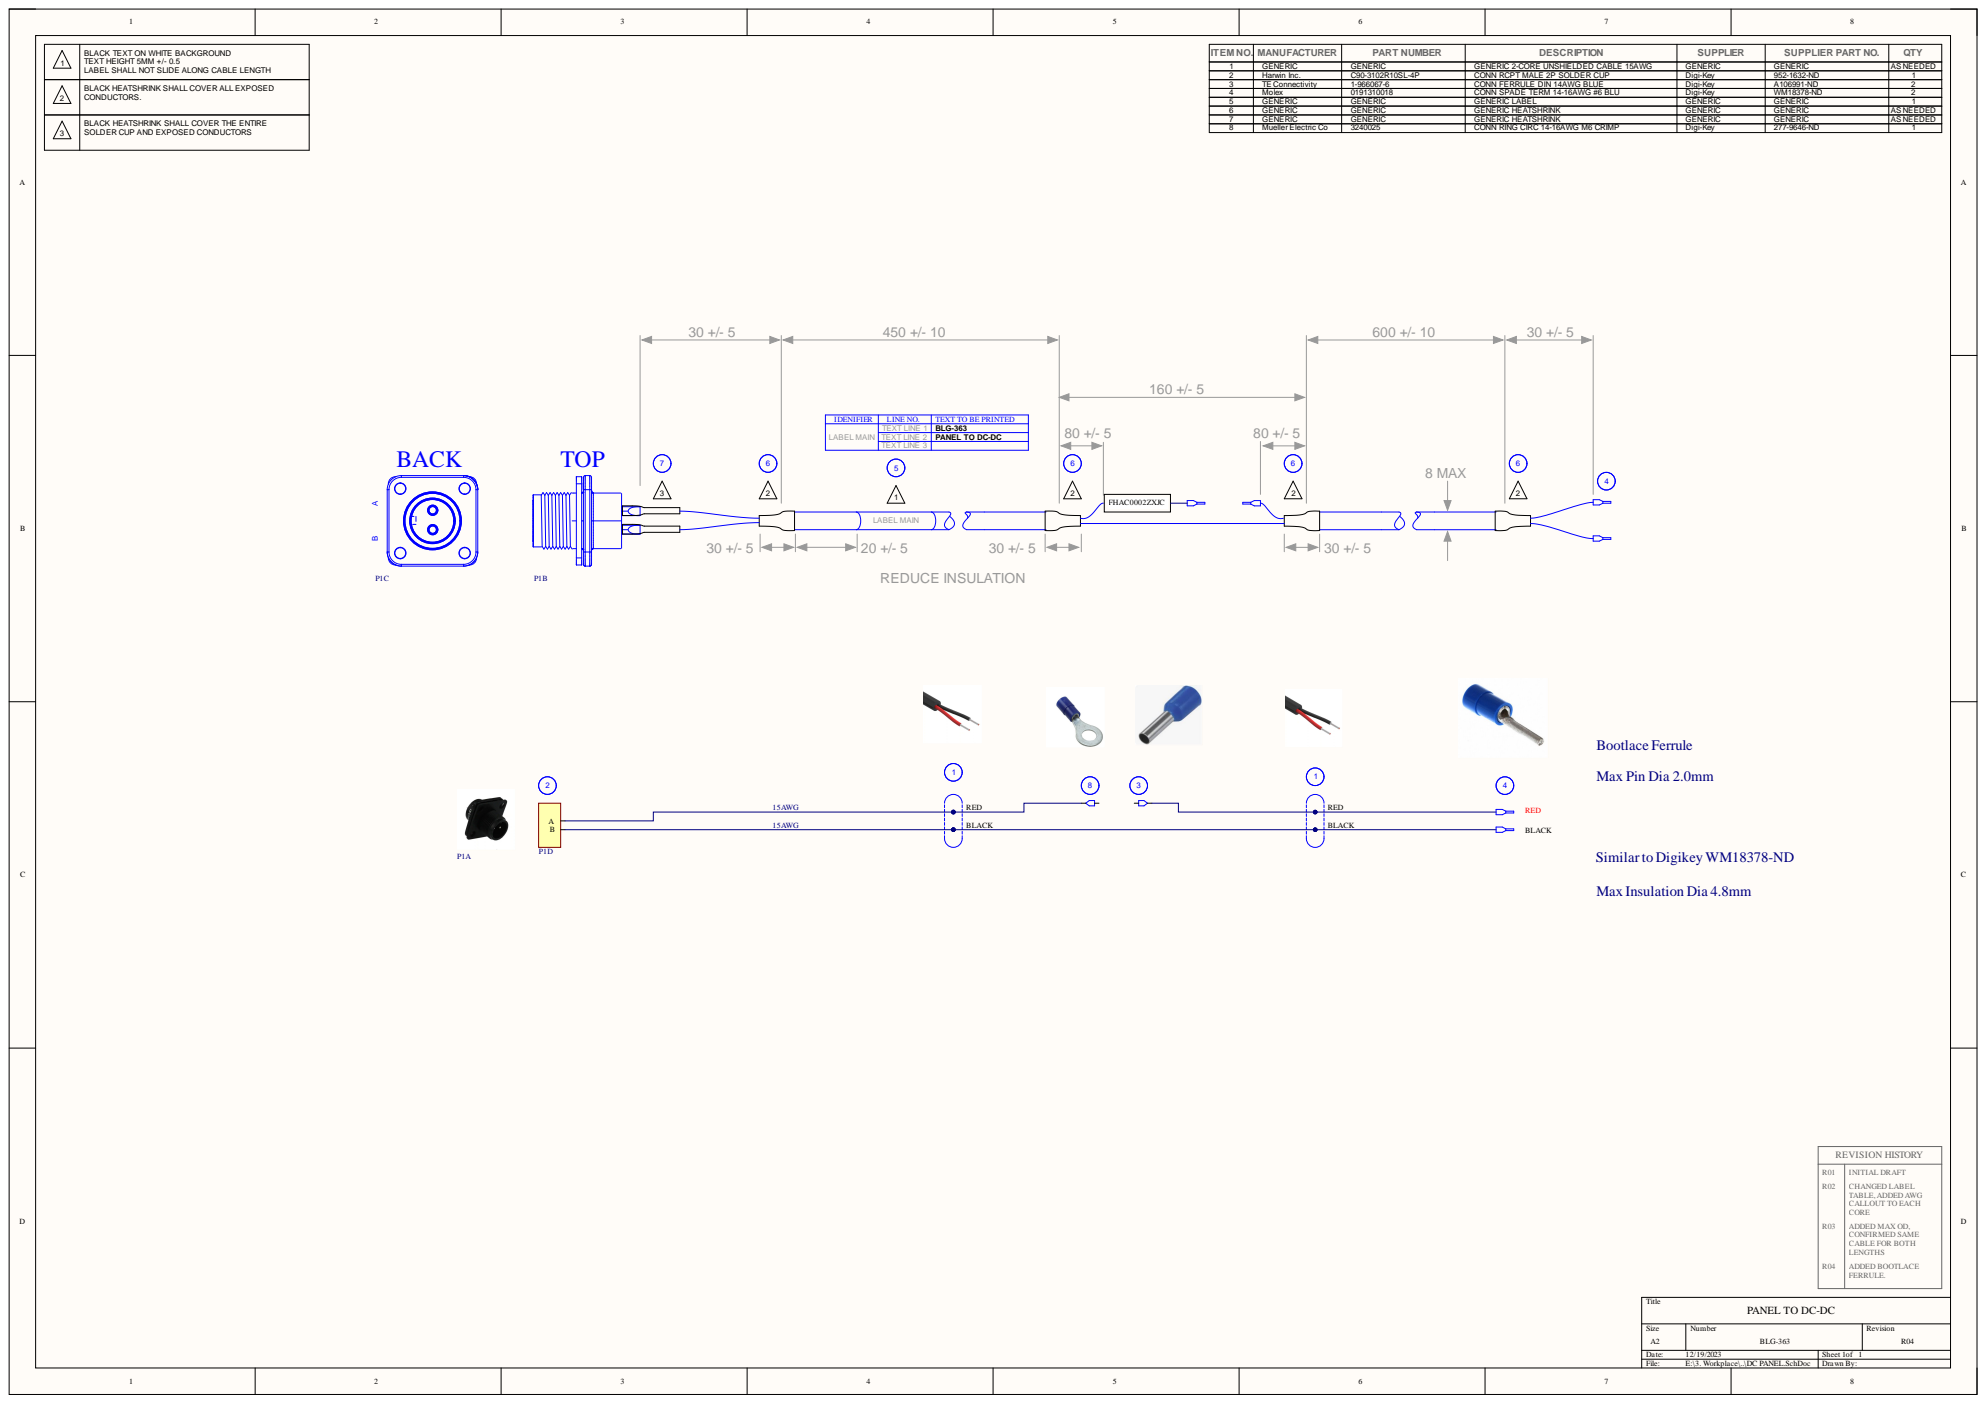
[picture p56: page 1]
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

2 | BLACK HEATSHRINK SHALL COVER ALL EXPOSED CONDUCTORS.

3 | BLACK HEATSHRINK SHALL COVER THE ENTIRE SOLDER CUP AND EXPOSED CONDUCTORS

LABEL MAIN | TEXT LINE 1 | BLG-363

TEXT LINE 2 | PANEL TO DC-DC

Similar to Digikey WM18378-ND

PANEL TO DC-DC
