Aitoubella/Freezer_FW/Hardware/Harness cable drawing/COMPRESSOR (BLG-324).pdf

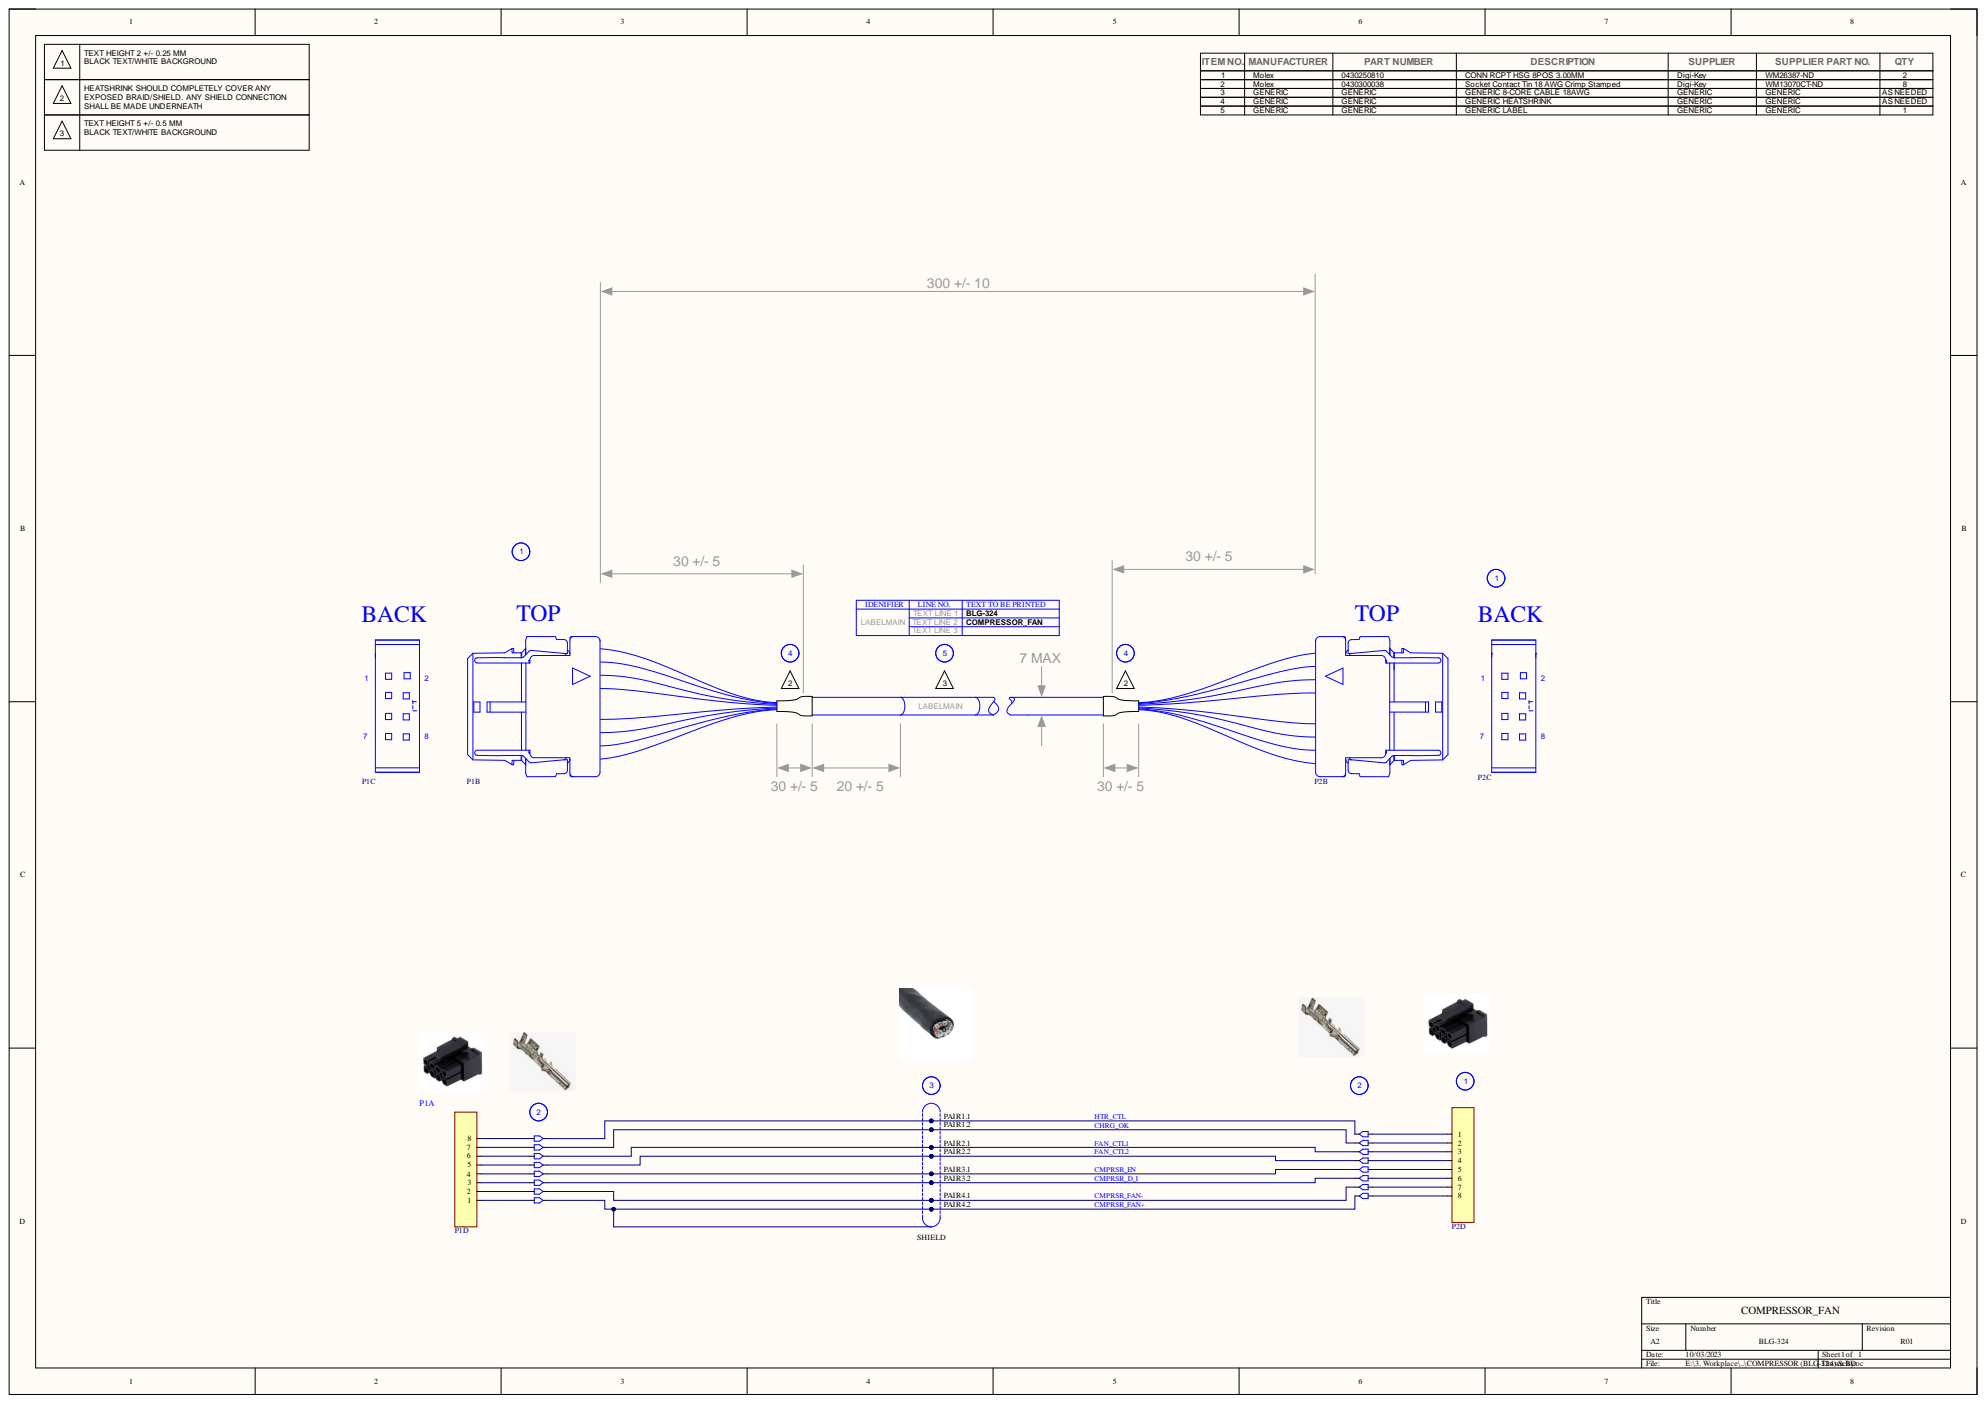
[picture p57: page 1]

1 | TEXT HEIGHT 2 +/- 0.25 MM BLACK TEXT/WHITE BACKGROUND

ITEM NO. | MANUFACTURER | PART NUMBER | DESCRIPTION | SUPPLIER | SUPPLIER PART NO. | QTY

2 | HEATSHRINK SHOULD COMPLETELY COVER ANY EXPOSED BRAID/SHIELD. ANY SHIELD CONNECTION SHALL BE MADE UNDERNEATH

3 | TEXT HEIGHT 5 +/- 0.5 MM BLACK TEXT/WHITE BACKGROUND

LABELMAIN | TEXT LINE 1 | BLG-324

TEXT LINE 2 | COMPRESSOR_FAN
TEXT LINE 3
