Aitoubella/Freezer_FW/Hardware/EMC test/Conducted A.pdf

## Current Graph

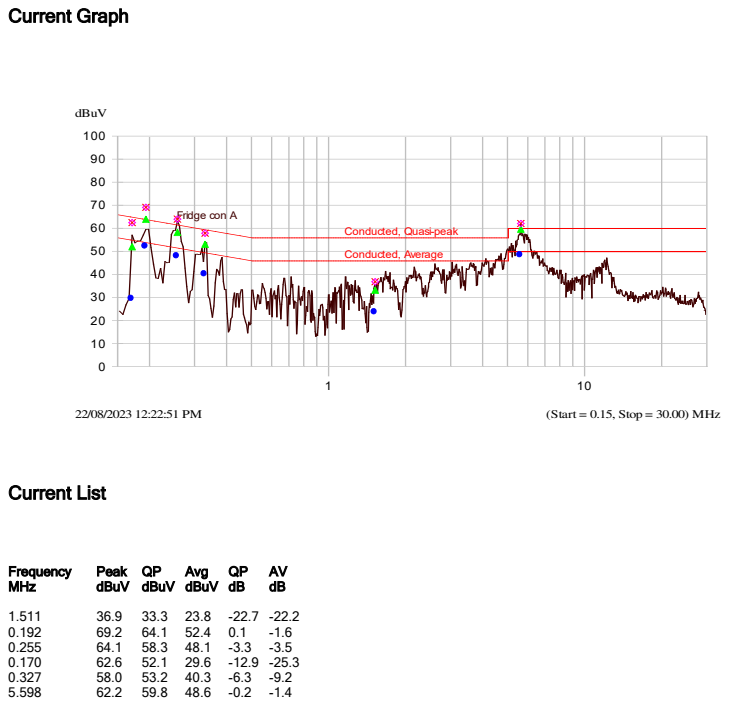
[picture p58: page 1]
Conducted, Average; Fridge con; dBuV; (Start = 0.15, Stop = 30.00) MHz; Current List; Frequency; Peak QP; Avg; MHz; dBuV dBuV dBuV dB

Conducted, Quasi-peak
