Aitoubella/Freezer_FW/Hardware/EMC test/Fridge rad H, batt power, no metal cover.pdf

# Radiated (3m)

# Current Graph

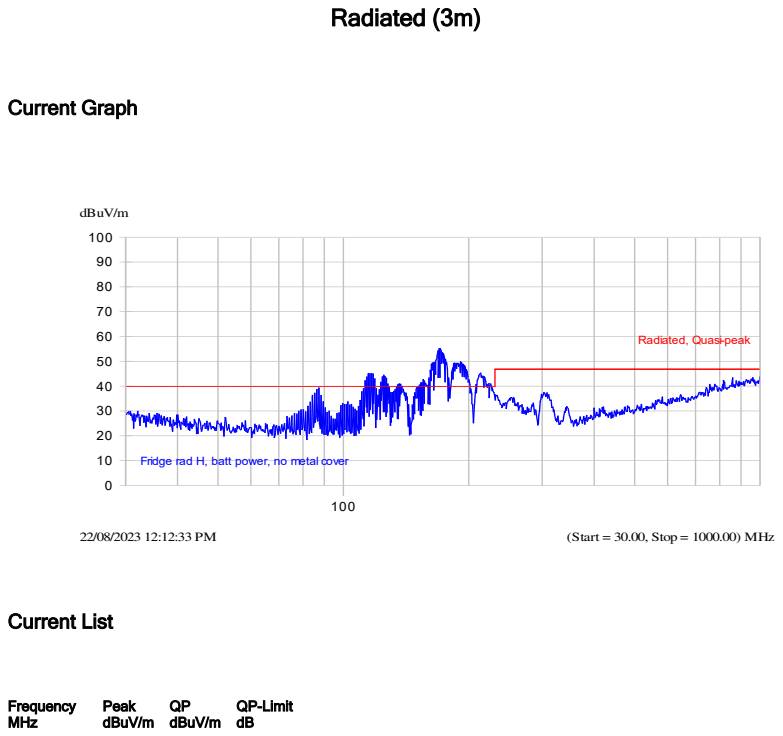
[picture p59: page 1]
Fridge; rad H, batt power, no metal cover; dBuV/m; (Start = 30.00, Stop = 1000.00) MHz; Current List; Frequency; Peak; QP-Limit; MHz; dBuV/m dBuV/m dB

Radiated, Quasi-peak
