Aitoubella/Freezer_FW/Hardware/EMC test/Fridge rad H, batt power.pdf

## Radiated (3m)

## Current Graph

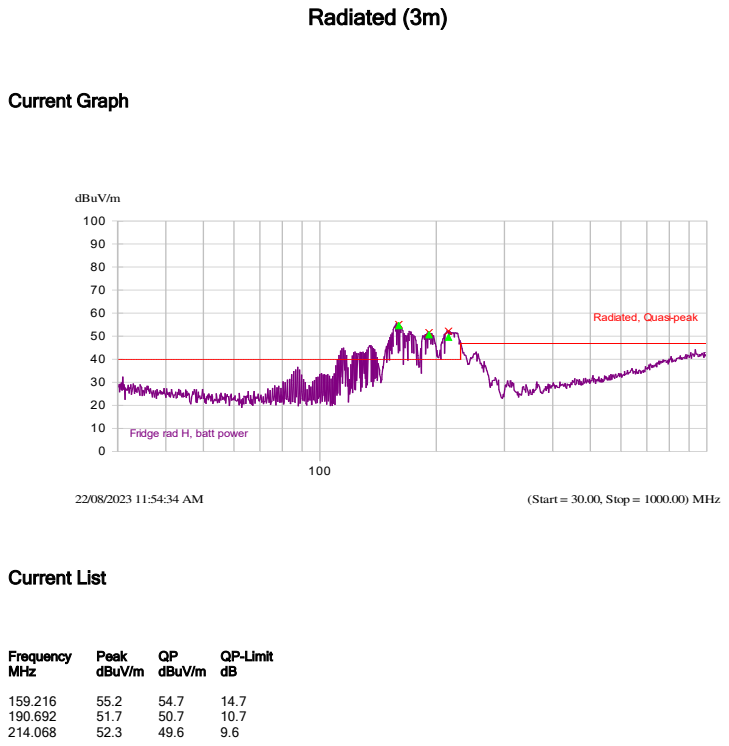
[picture p60: page 1]
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

Radiated, Quasi-peak

Fridge rad H, batt power
