Aitoubella/Freezer_FW/Hardware/EMC test/Fridge rad V, batt power.pdf

## Radiated (3m)

## Current Graph

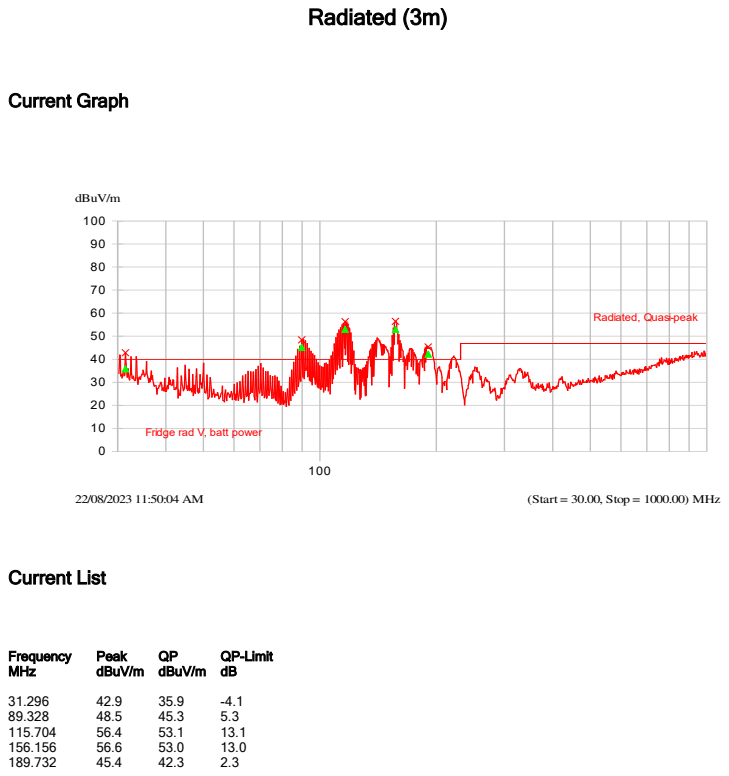
[picture p61: page 1]
Fridge rad V, batt; power; dBuV/m; (Start = 30.00, Stop = 1000.00) MHz; Current List; Frequency; Peak; QP-Limit; MHz; dBuV/m dBuV/m dB

Radiated, Quasi-peak
