Aitoubella/Freezer_FW/Hardware/Harness cable drawing/AC IN (BLG-321_R04).PDF

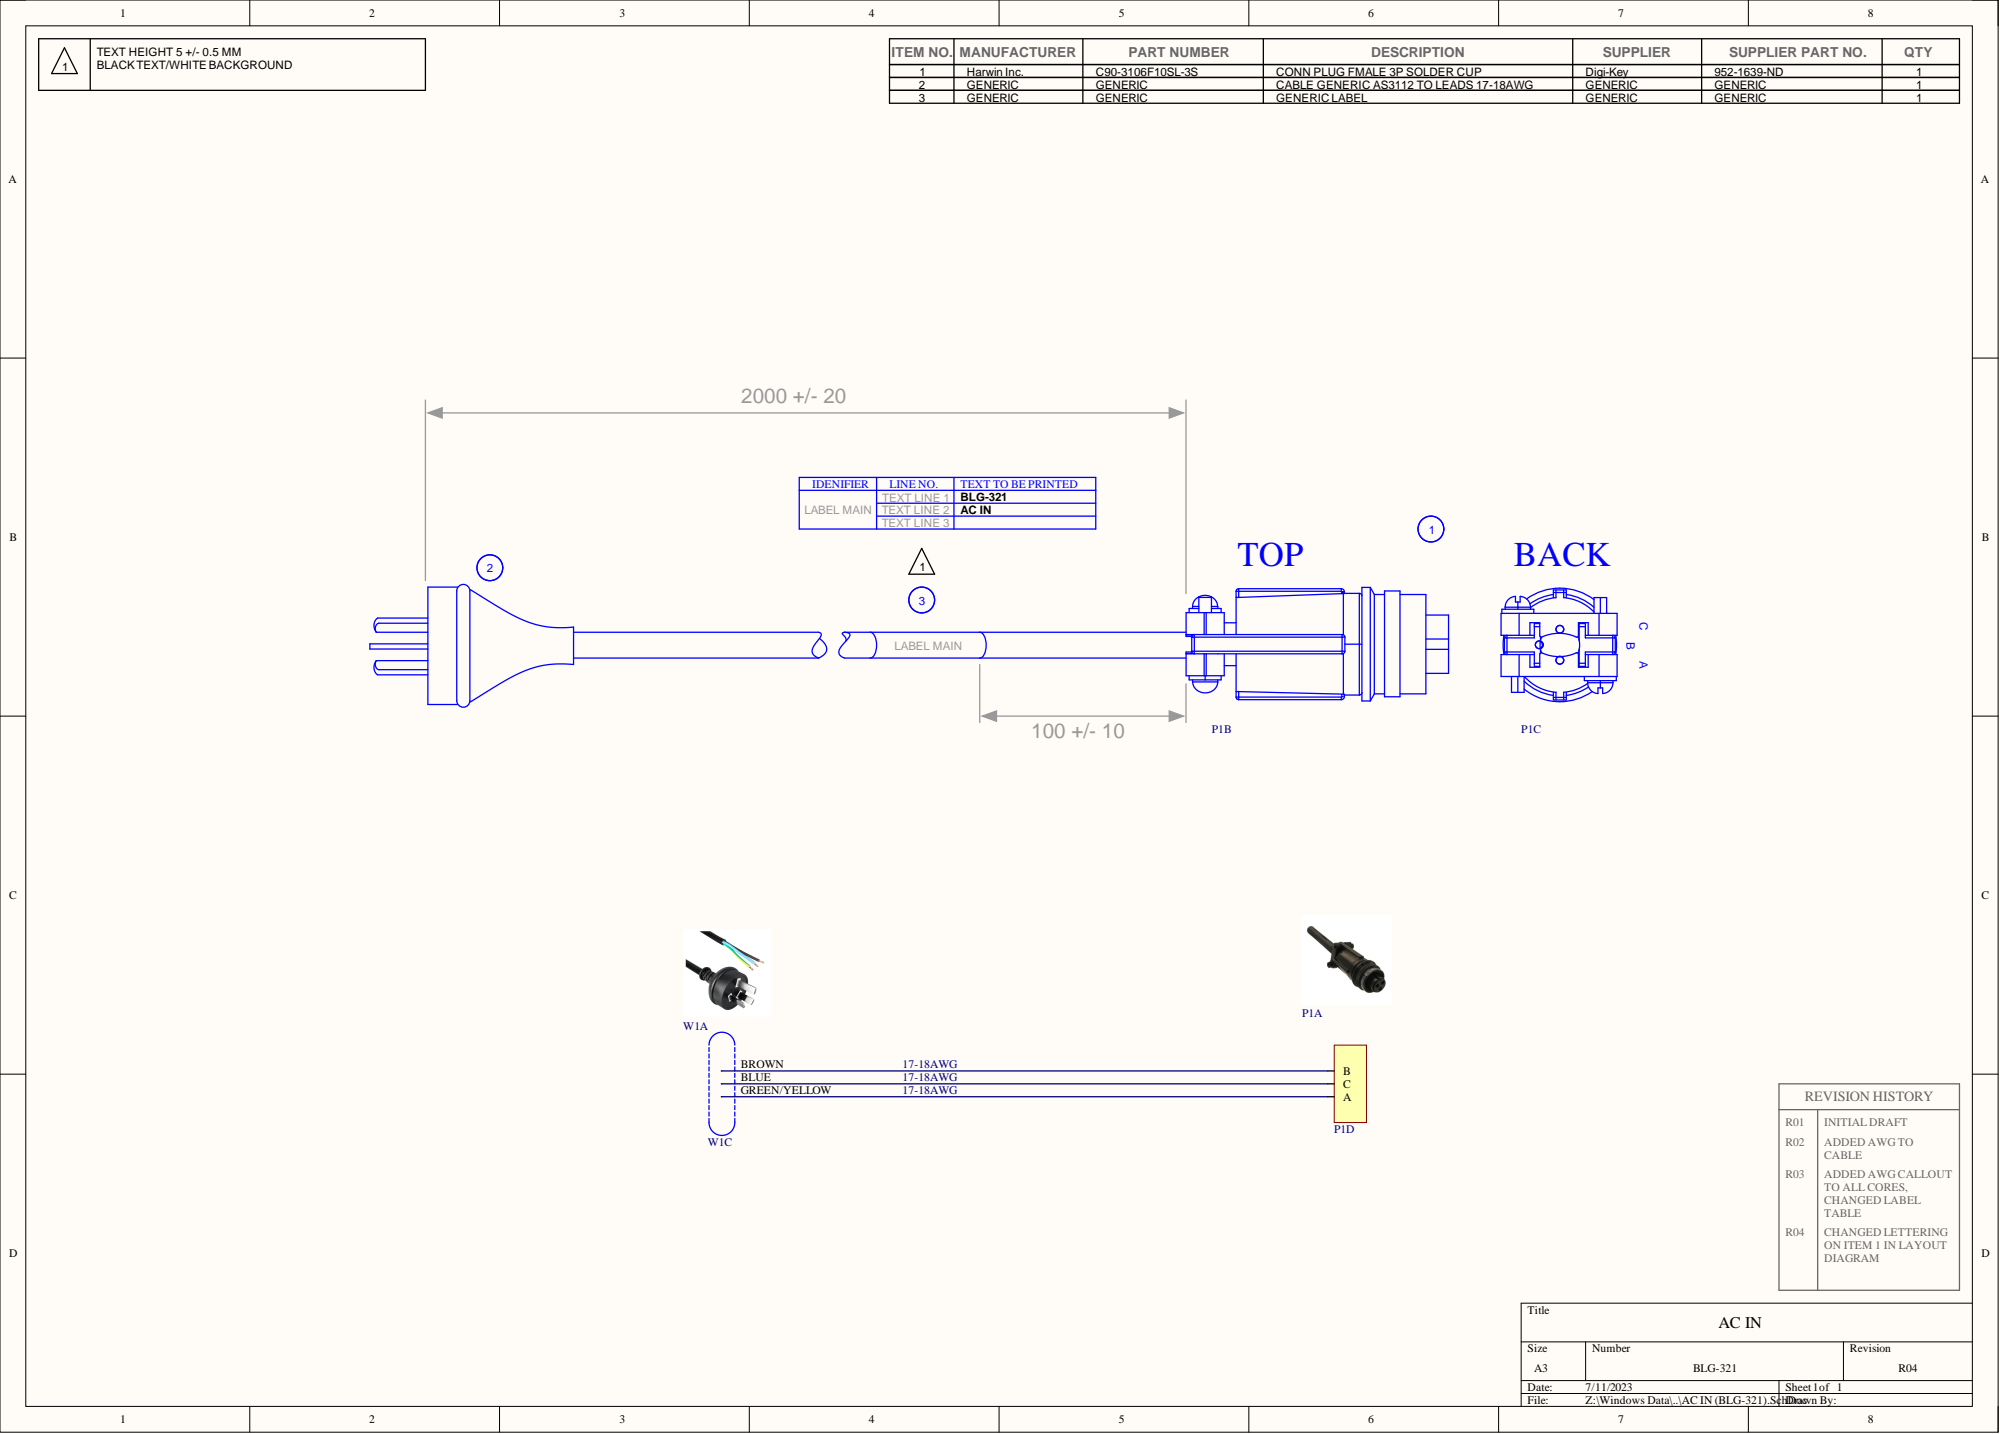
[picture p62: page 1]

TEXT HEIGHT 5 +/- 0.5 MM
BLACK TEXT/WHITE BACKGROUND

1 | Harwin Inc. | C90-3106F10SL-3S | CONN PLUG FMALE 3P SOLDER CUP | Digi-Key | 952-1639-ND | 1
2 | GENERIC | GENERIC | CABLE GENERIC AS3112 TO LEADS 17-18AWG | GENERIC | GENERIC | 1
3 | GENERIC | GENERIC | GENERIC LABEL | GENERIC | GENERIC | 1

IDENIFIER | LINE NO. | TEXT TO BE PRINTED
LABEL MAIN | TEXT LINE 1 | BLG-321

TEXT LINE 2 | AC IN
TEXT LINE 3

INITIAL DRAFT
ADDED AWG TO
CABLE
ADDED AWG CALLOUT
TO ALL CORES,
CHANGED LABEL
TABLE
CHANGED LETTERING
ON ITEM 1 IN LAYOUT
DIAGRAM
