Aitoubella/Freezer_FW/Hardware/Harness cable drawing/AC-DC TO POWER BOARD (BLG-362_R03).pdf

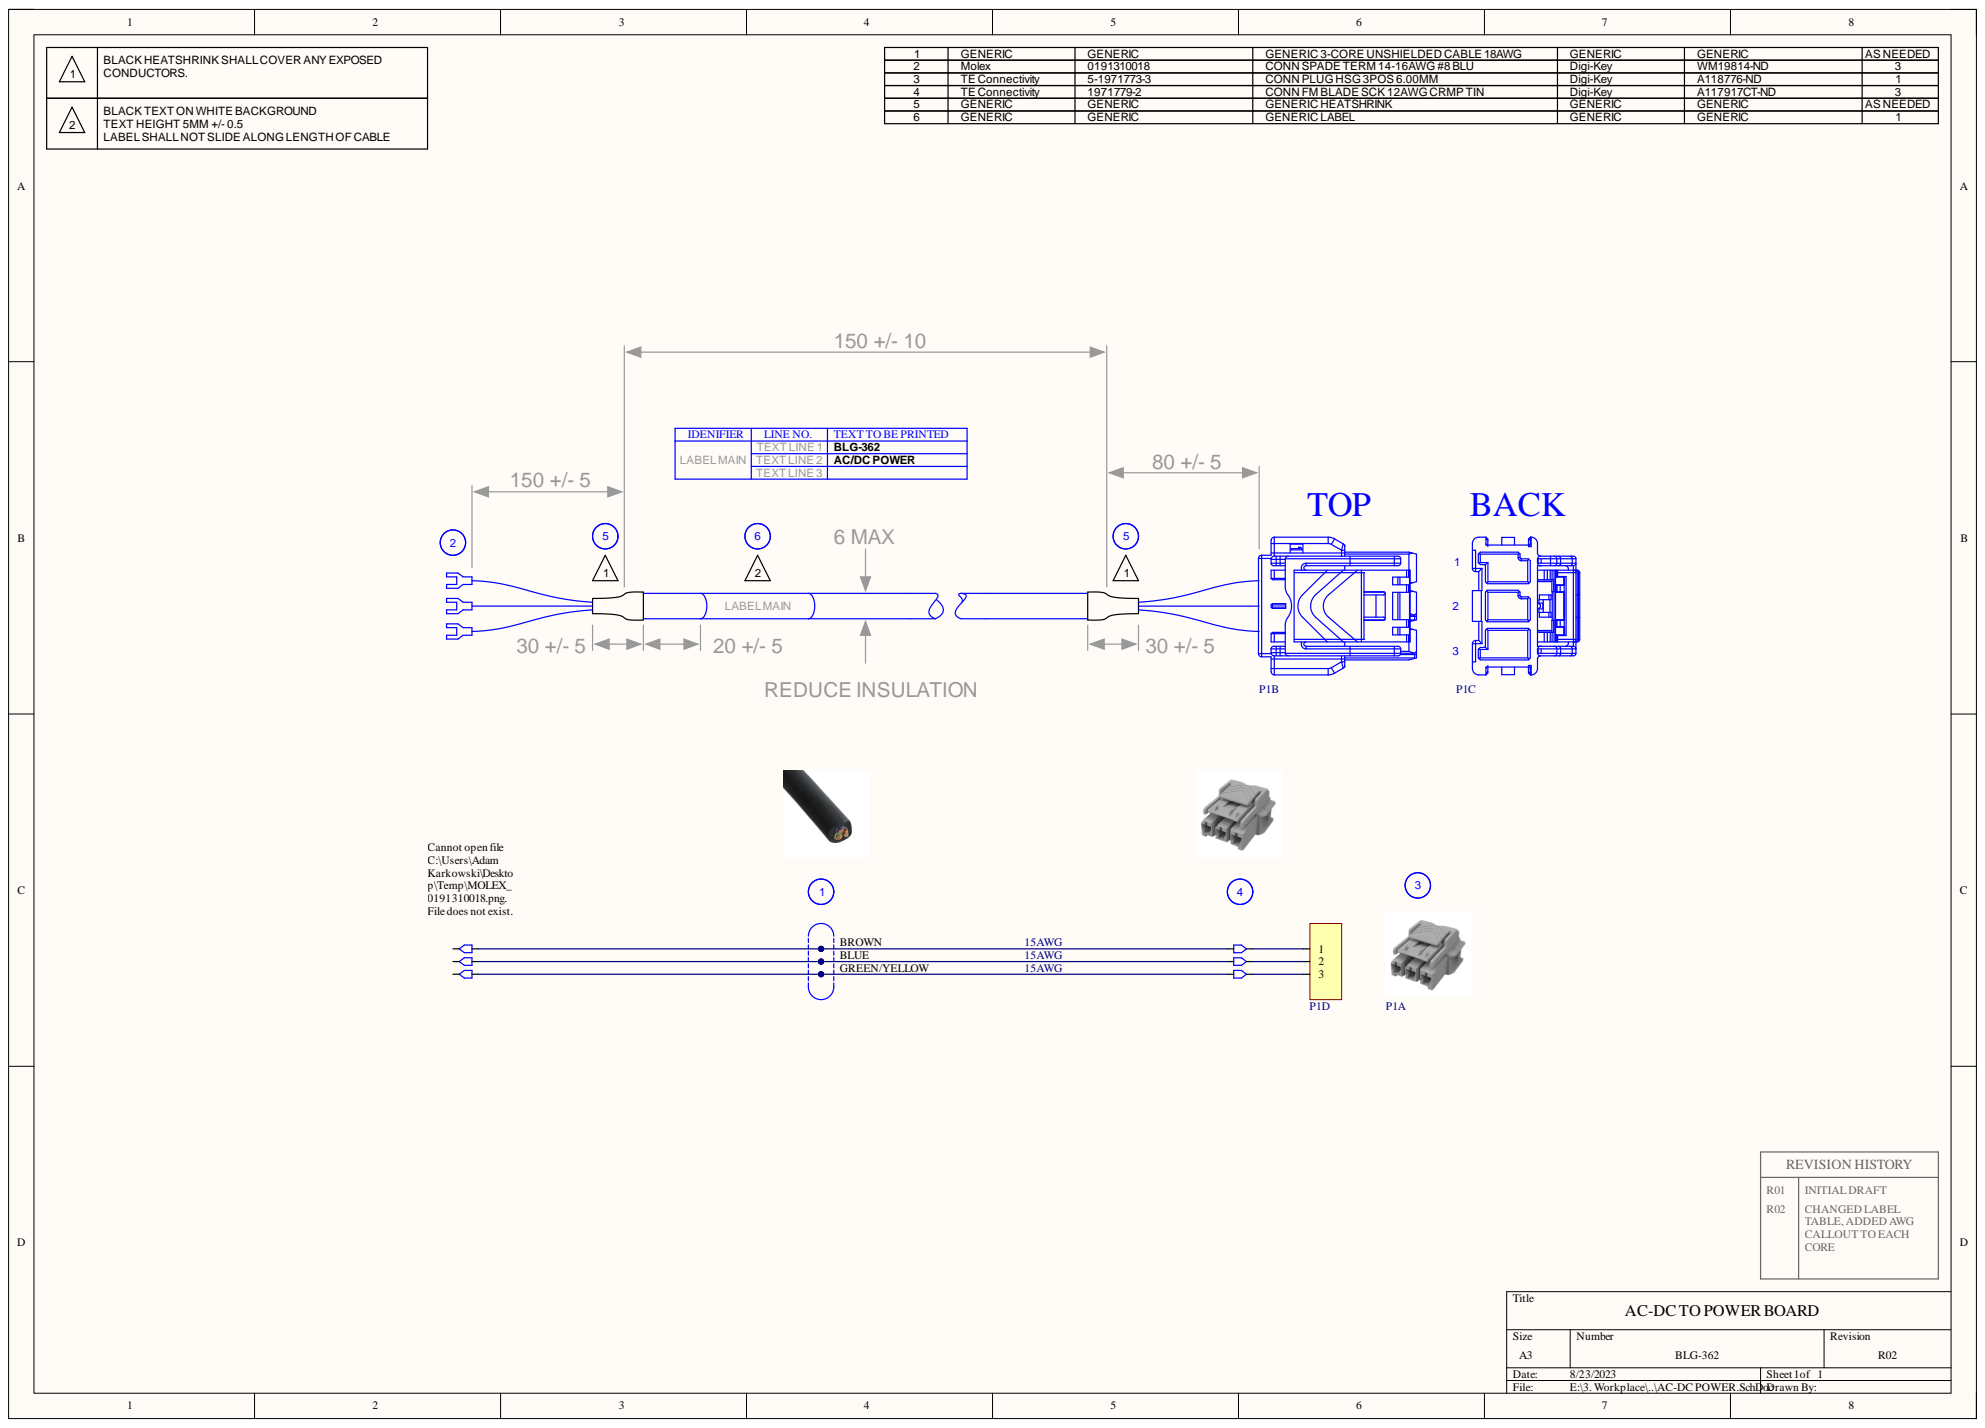
[picture p63: page 1]

BLACK HEATSHRINK SHALLCOVER ANY EXPOSED
CONDUCTORS.

2 | Molex | 0191310018 | CONN SPADE TERM 14-16AWG #8 BLU | Digi-Key | WM19814-ND | 3
3 | TE Connectivity | 5-1971773-3 | CONN PLUG HSG 3POS 6.00MM | Digi-Key | A118776-ND | 1
4 | TE Connectivity | 1971779-2 | CONN FM BLADE SCK 12AWG CRMP TIN | Digi-Key | A117917CT-ND | 3

BLACK TEXT ON WHITE BACKGROUND
TEXT HEIGHT 5MM +/- 0.5
LABELSHALLNOT SLIDE ALONG LENGTH OF CABLE

IDENIFIER | LINE NO. | TEXT TO BE PRINTED
LABELMAIN | TEXT LINE 1 | BLG-362

TEXT LINE 2 | AC/DC POWER
TEXT LINE 3

Cannot open file
C:\Users\Adam
Karkowski\Deskto
p\Temp\MOLEX_
0191310018.png.
File does not exist.

AC-DC TO POWER BOARD
