Aitoubella/Freezer_FW/Hardware/Harness cable drawing/CONTROLLER POWER (BLG-366_R01).PDF

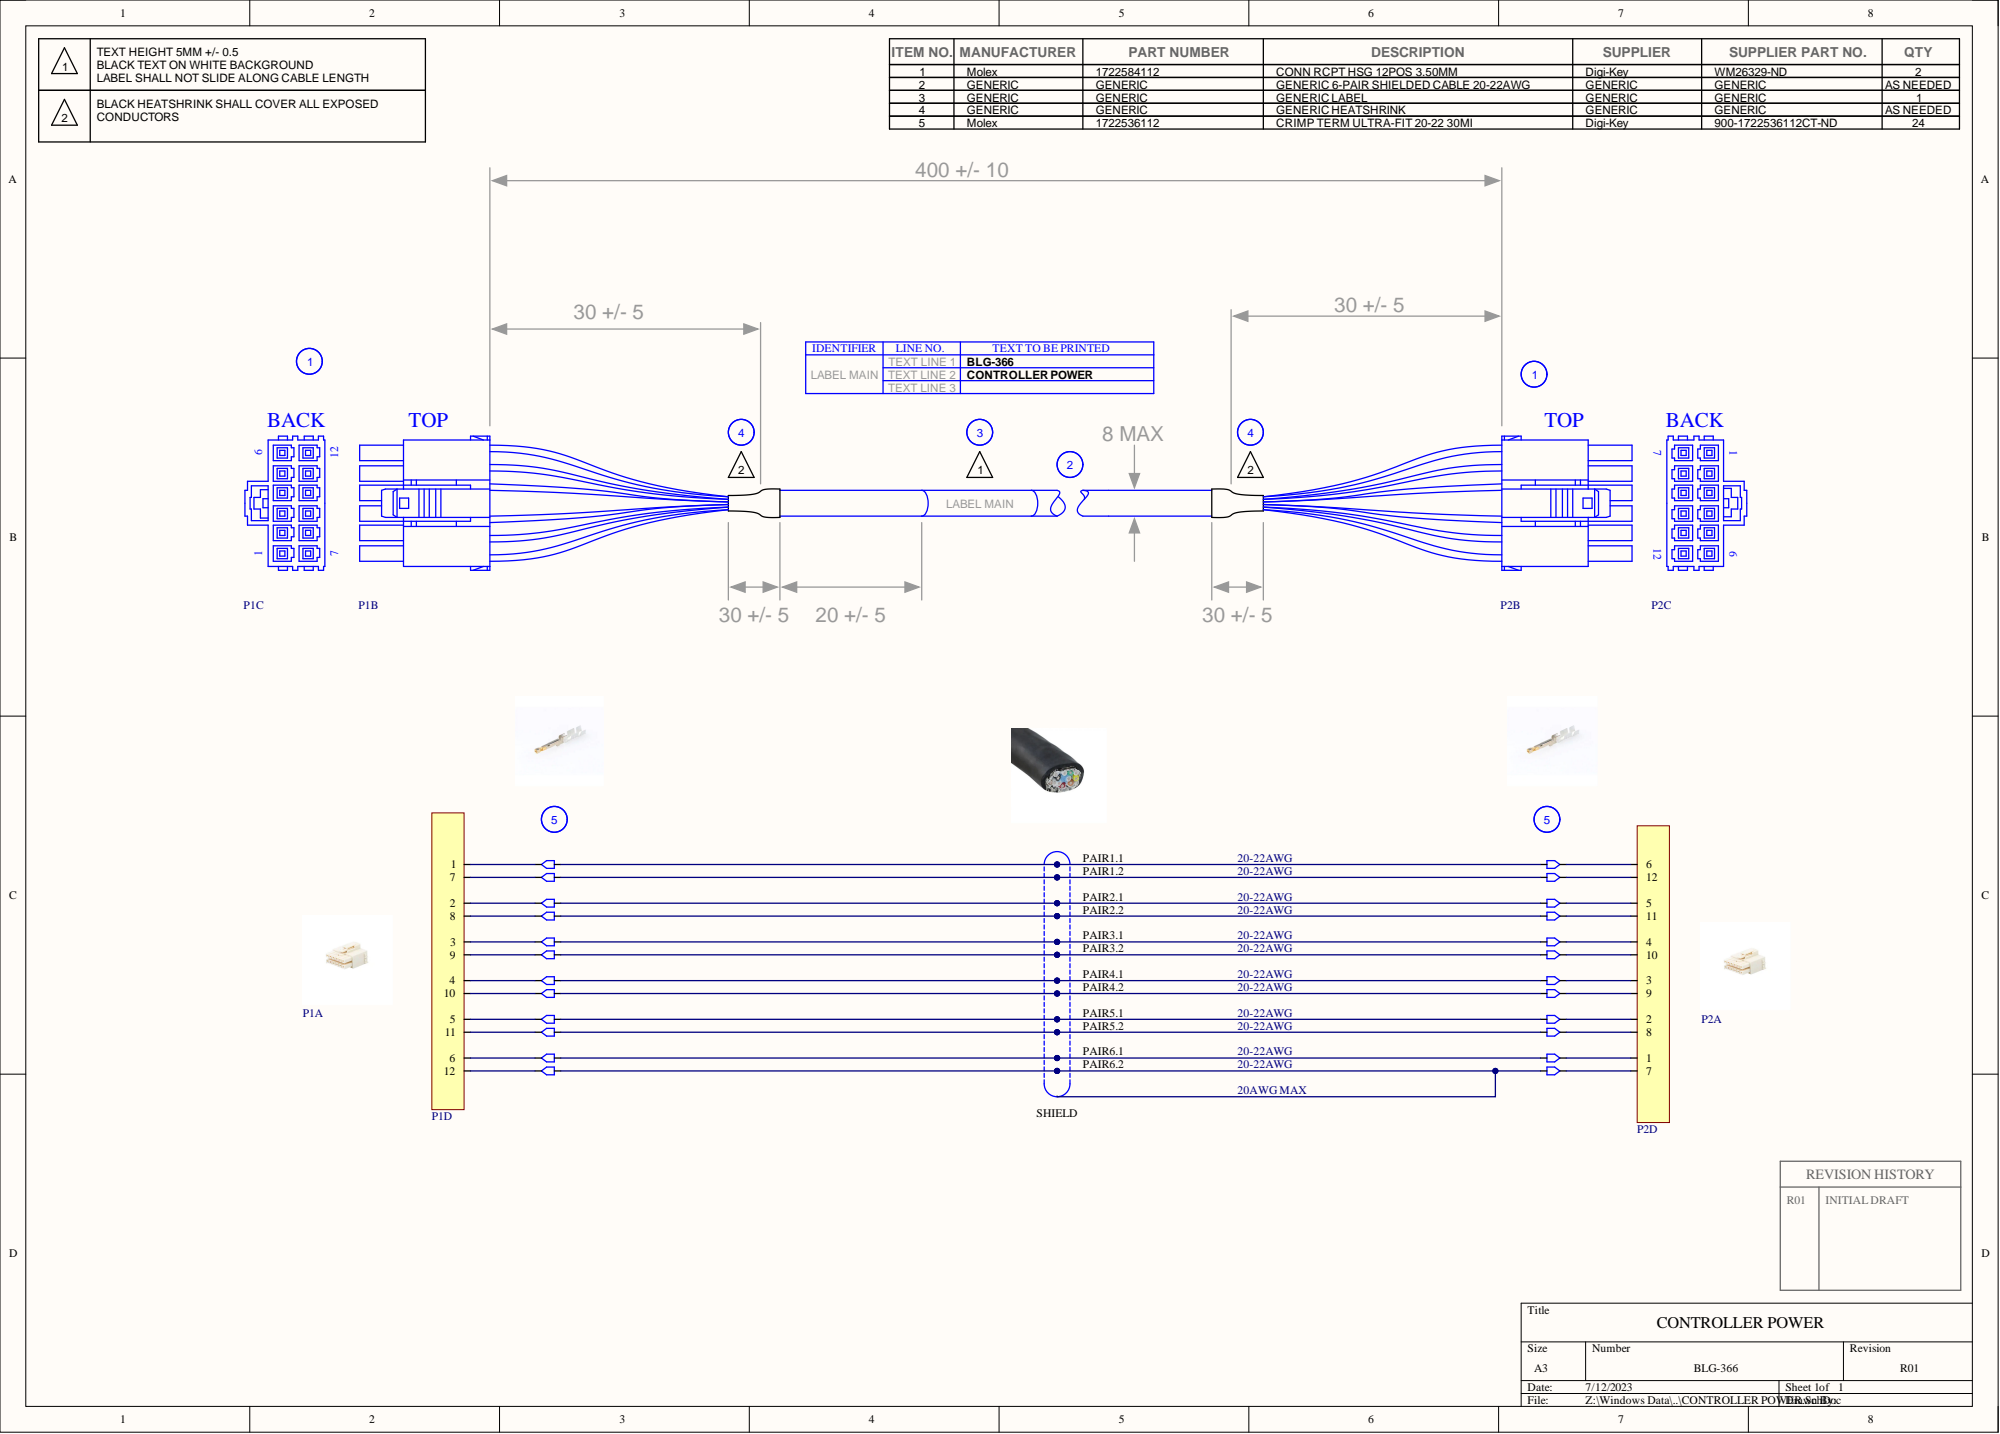
[picture p64: page 1]

1 | Mole x | 172258411 2 | CON N R CPT HSG 12POS 3.50M M | Digi-K e y | W M26329 -N D | 2
2 | GEN E R I C | GEN E R I C | GENER I C 6-PAI R SH IELDED CABLE 20-22AW G | GEN E R I C | GEN E R I C | AS NEEDED

4 | GEN E R I C | GEN E R I C | GENER I C HEATSH R I N K | GEN E R I C | GEN E R I C | AS NEEDED
5 | Mole x | 172253611 2 | C R I MP TER M ULT RA-F I T 20-22 30M I | Digi-K e y | 900-1722536112C T -N D | 24

ID E N TIFI E R | LIN E N O . | T E X T T O BE PRIN T E D
LABEL MAI N | TEXT LI NE 1 | B LG-3 6 6

TEXT LI NE 2 | CON T ROL LER PO W E R
TEXT LI NE 3
