Aitoubella/Freezer_FW/Hardware/Harness cable drawing/DC IN (BLG-322_R03).PDF

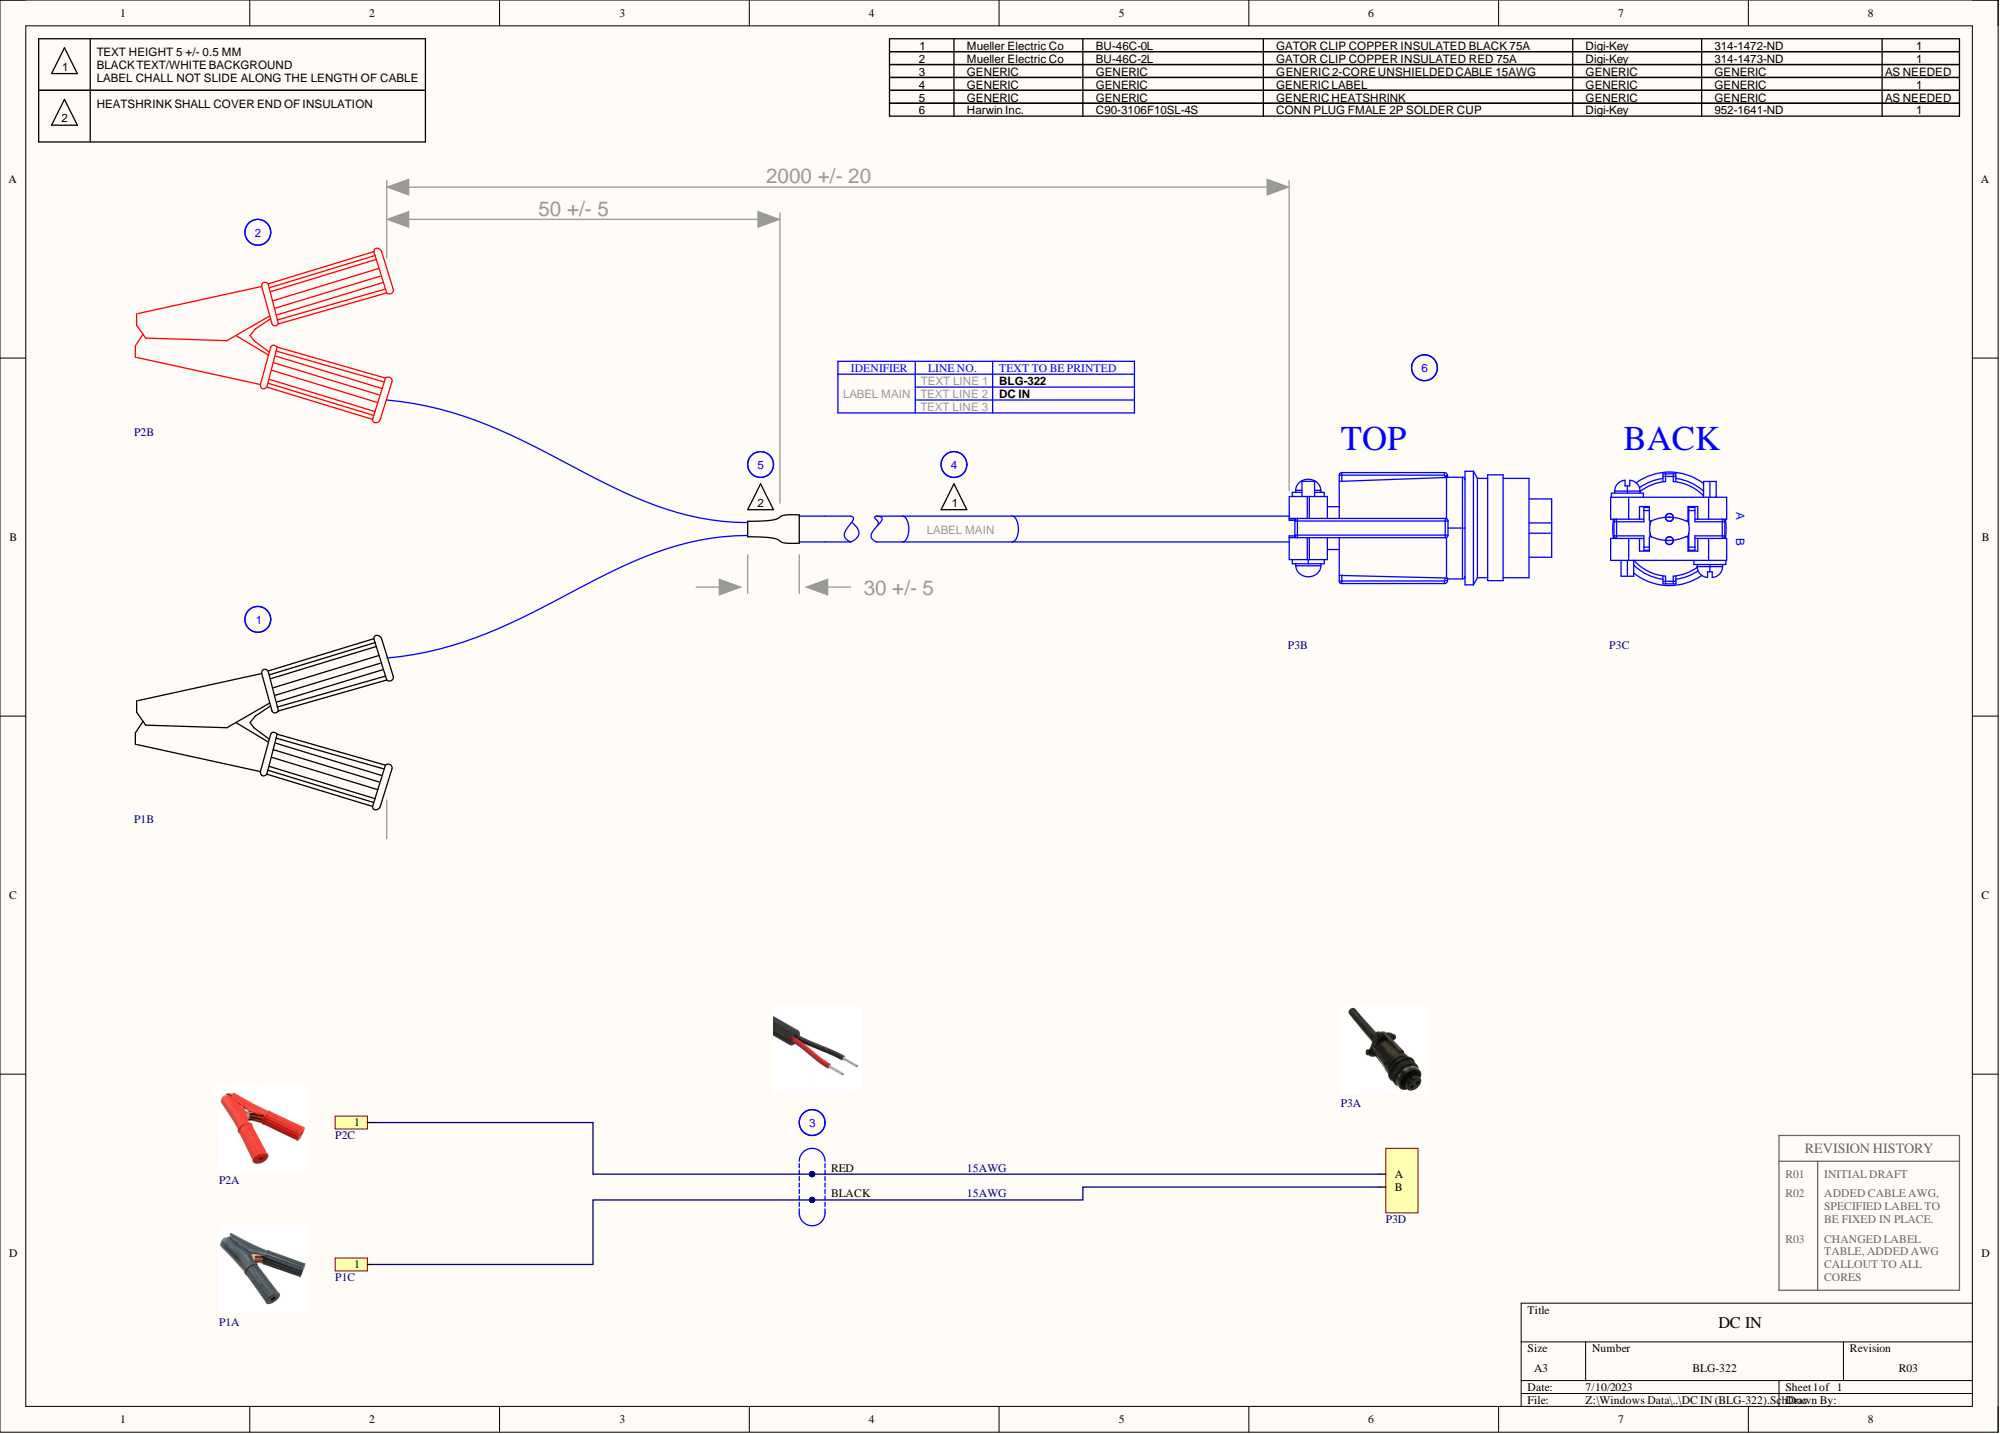
[picture p65: page 1]

TEXT HEIGHT 5 +/- 0.5 MM
BLACK TEXT/WHITE BACKGROUND
LABEL CHALL NOT SLIDE ALONG THE LENGTH OF CABLE

2 | Mueller Electric Co | BU-46C-2L | GATOR CLIP COPPER INSULATED RED 75A | Digi-Key | 314-1473-ND | 1
3 | GENERIC | GENERIC | GENERIC 2-CORE UNSHIELDED CABLE 15AWG | GENERIC | GENERIC | AS NEEDED
4 | GENERIC | GENERIC | GENERIC LABEL | GENERIC | GENERIC | 1

HEATSHRINK SHALL COVER END OF INSULATION

IDENIFIER | LINE NO. | TEXT TO BE PRINTED
LABEL MAIN | TEXT LINE 1 | BLG-322

TEXT LINE 2 | DC IN
TEXT LINE 3

INITIAL DRAFT
ADDED CABLE AWG,
SPECIFIED LABEL TO
BE FIXED IN PLACE.
CHANGED LABEL
TABLE, ADDED AWG
CALLOUT TO ALL
CORES
