Aitoubella/Freezer_FW/Hardware/Harness cable drawing/FAN-HEATER (BLG-323_R04).pdf

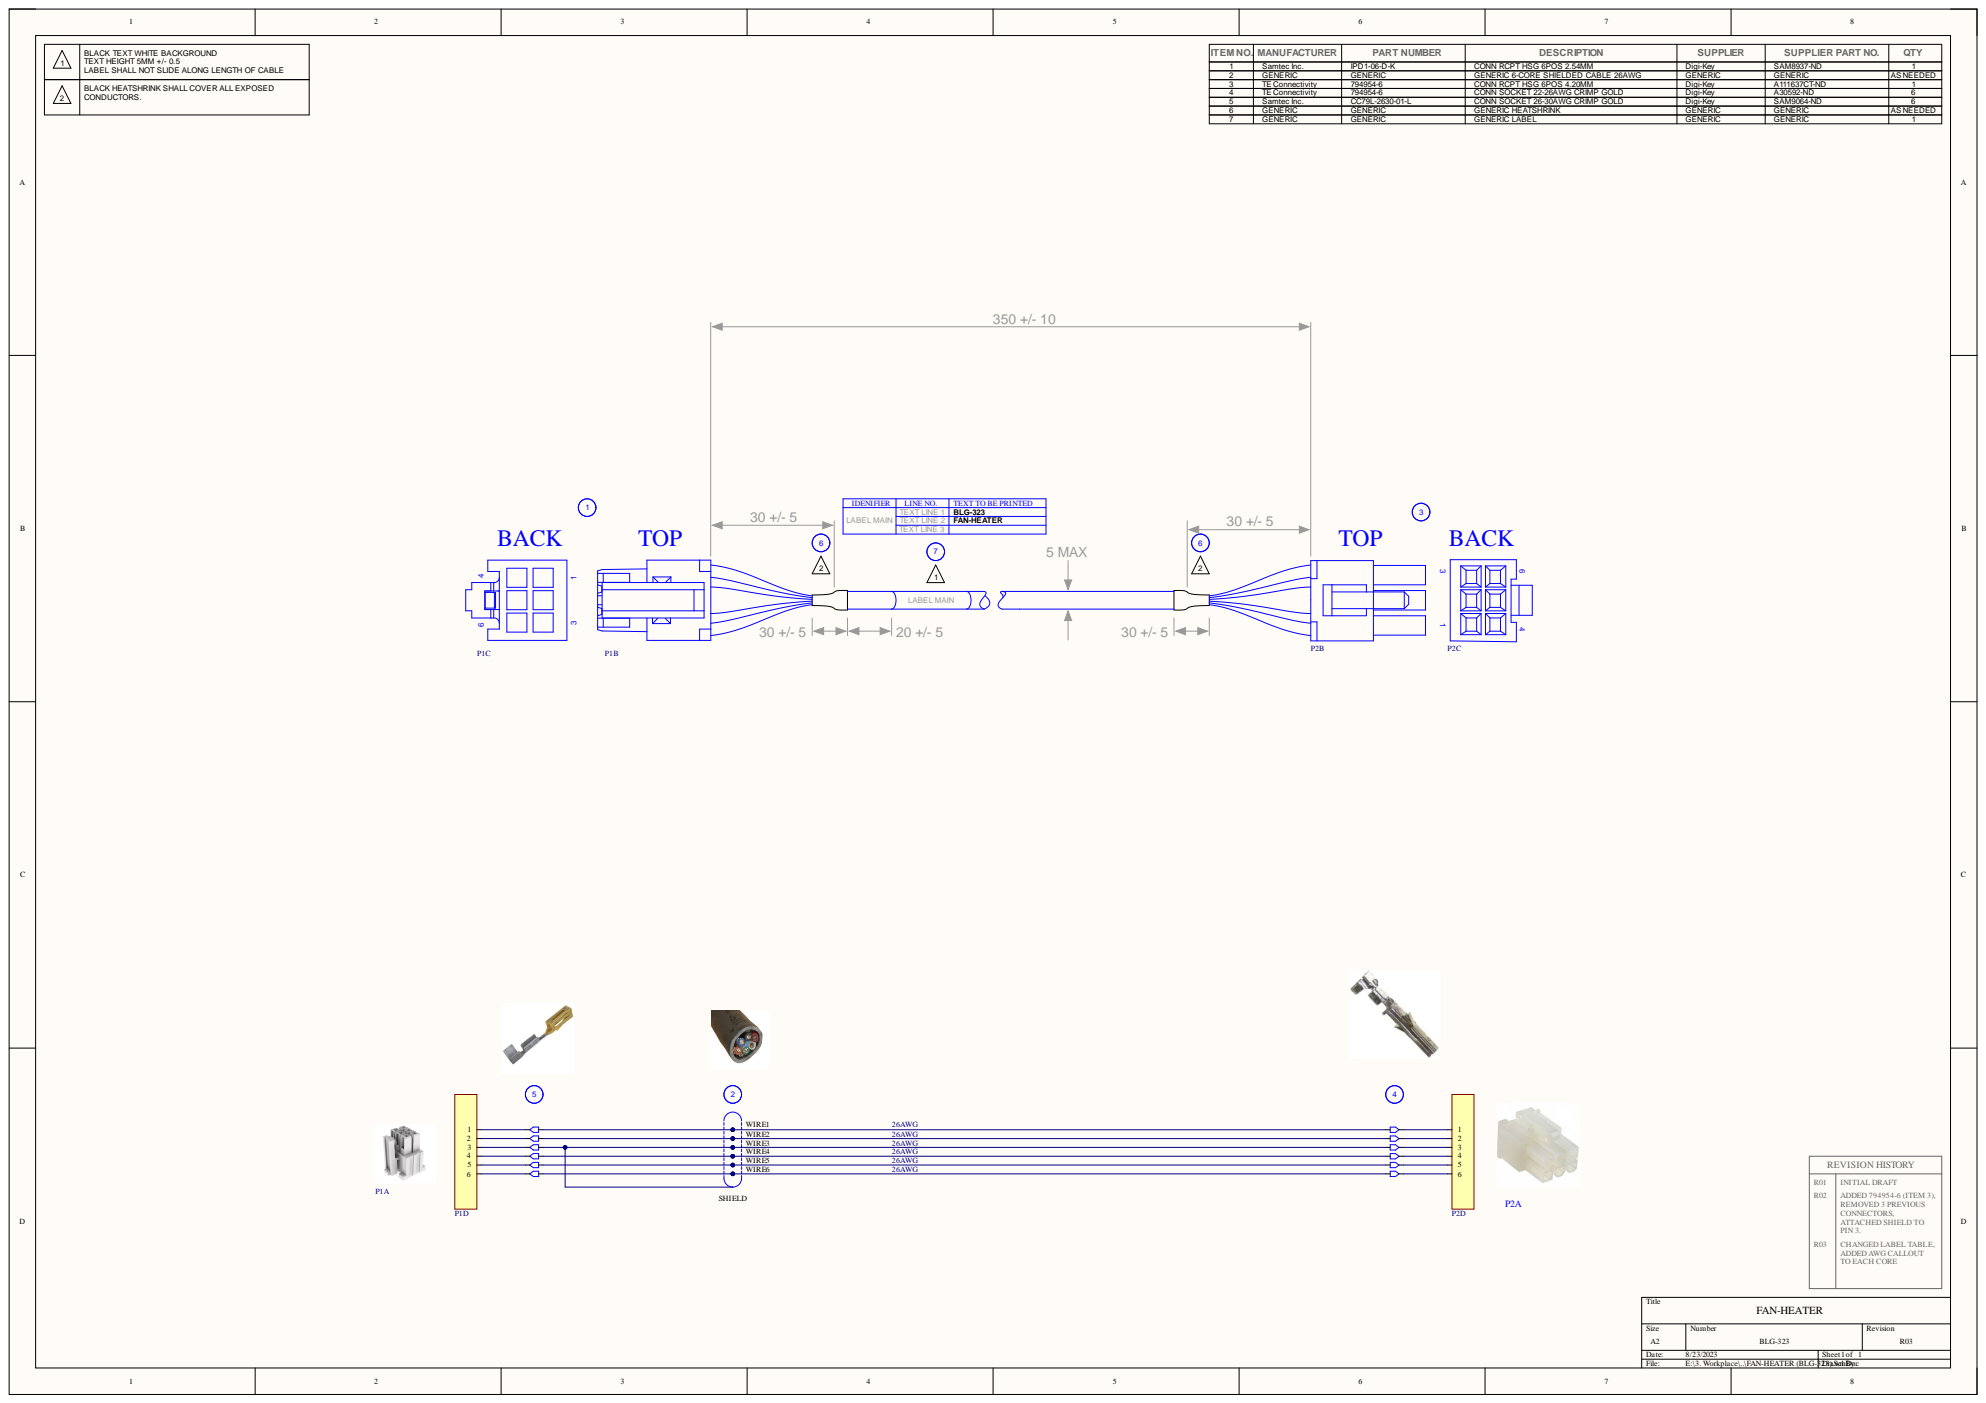
[picture p66: page 1]

BLACK TEXT WHITE BACKGROUND
TEXT HEIGHT 5MM +/- 0.5
LABEL SHALL NOT SLIDE ALONG LENGTH OF CABLE

BLACK HEATSHRINK SHALL COVER ALL EXPOSED
CONDUCTORS.

LABEL MAIN | TEXT LINE 1 | BLG-323

TEXT LINE 2 | FAN-HEATER
