Aitoubella/Freezer_FW/Hardware/Harness cable drawing/PANEL TO AC-DC (BLG-361_R05).pdf

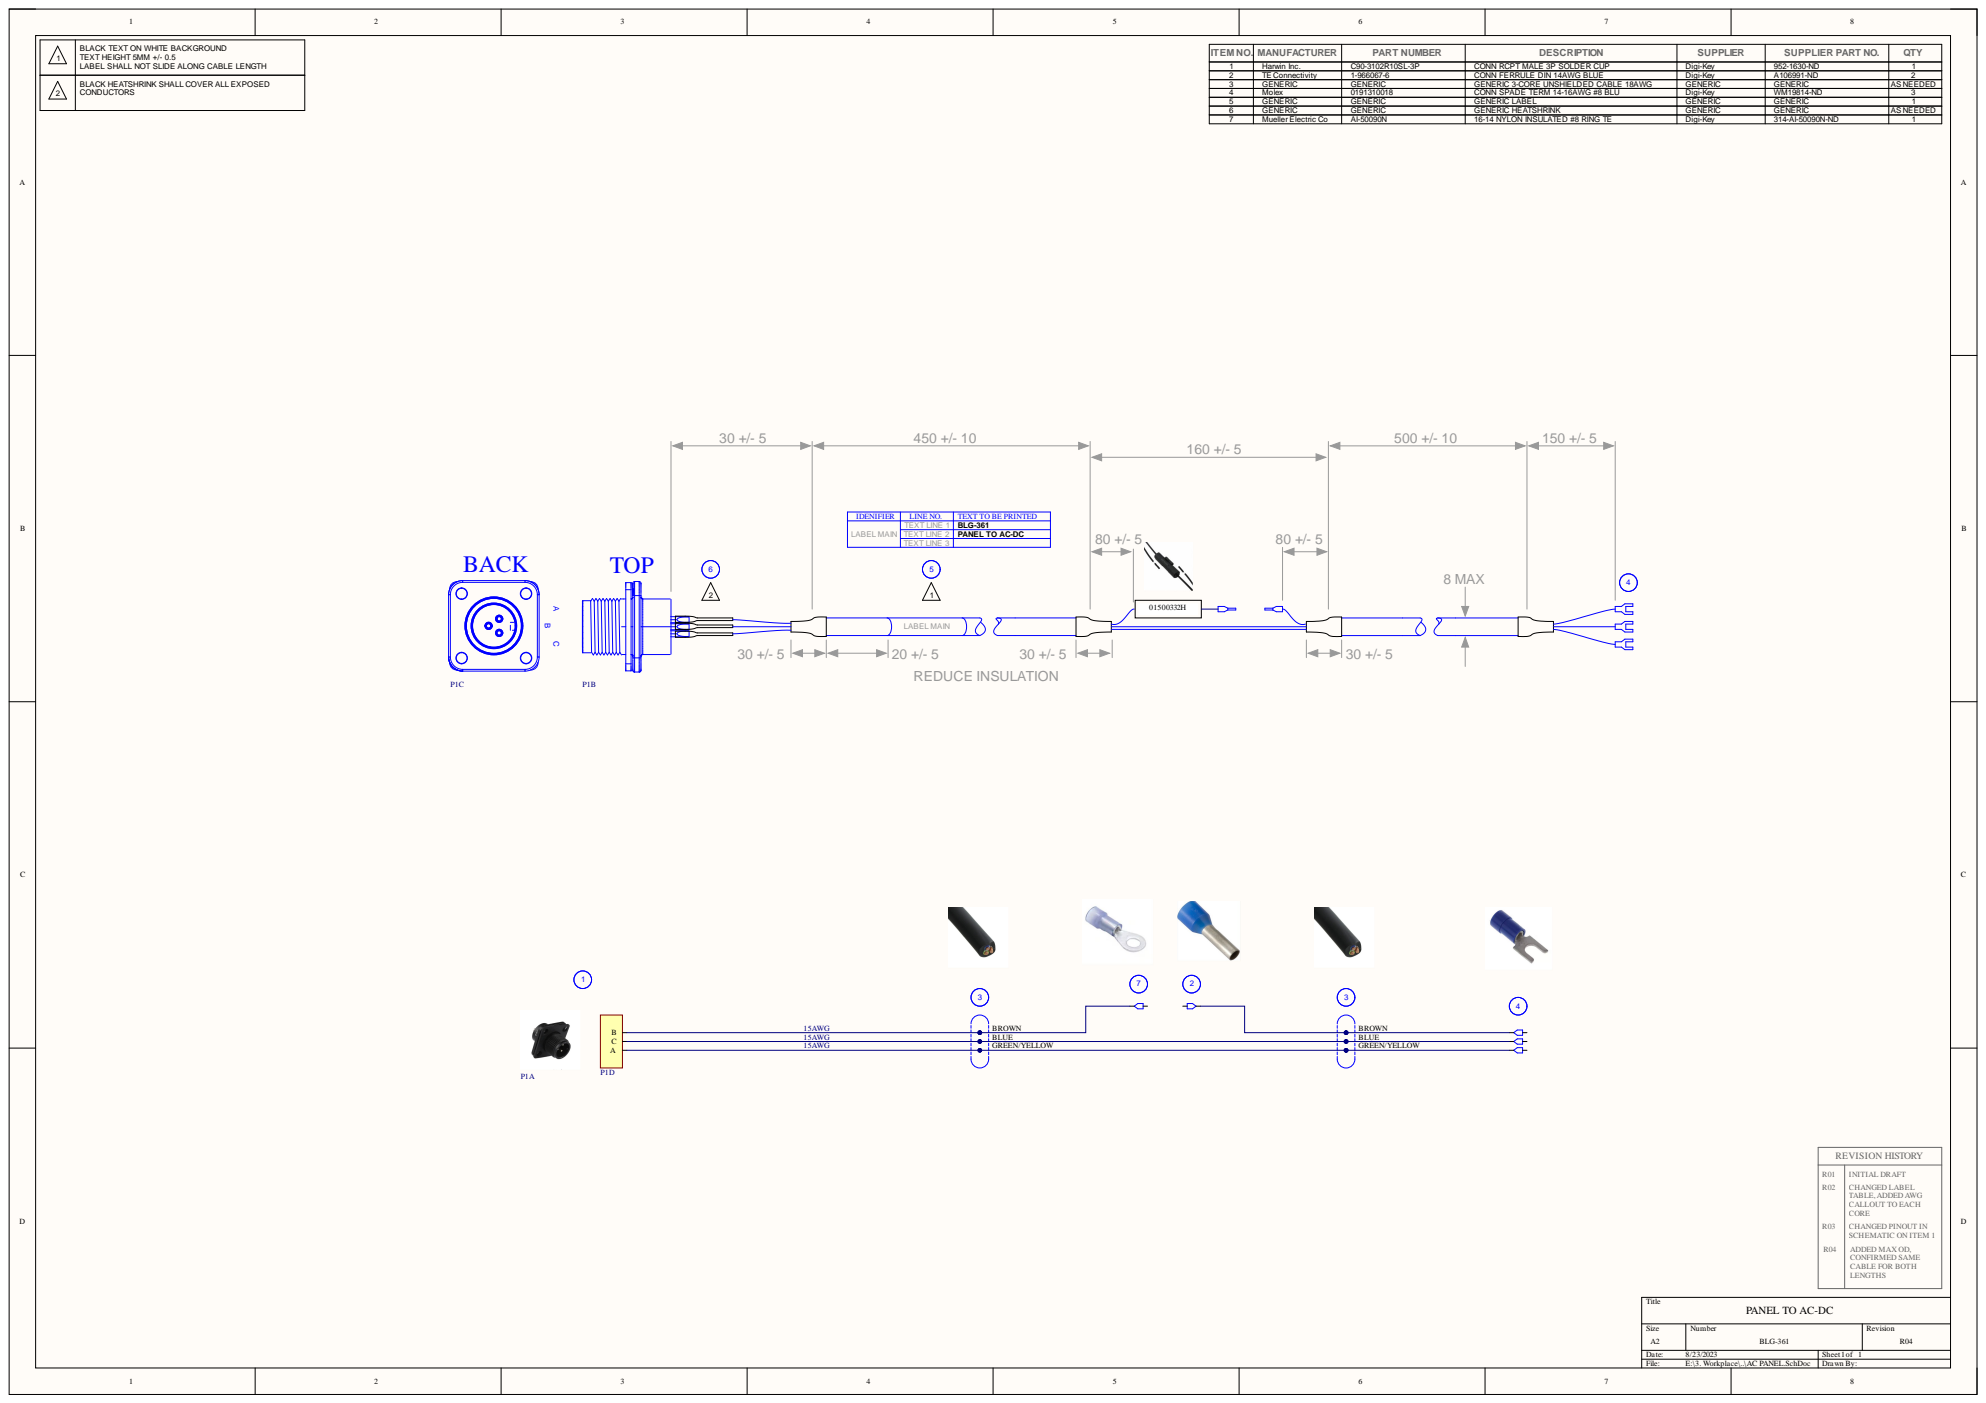
[picture p67: page 1]
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

BLACK HEATSHRINK SHALL COVER ALL EXPOSED
CONDUCTORS

LABEL MAIN | TEXT LINE 1 | BLG-361

TEXT LINE 2 | PANEL TO AC-DC
TEXT LINE 3

PANEL TO AC-DC
