Aitoubella/Freezer_FW/Hardware/Harness cable drawing/USB (BLG-320_R04).PDF

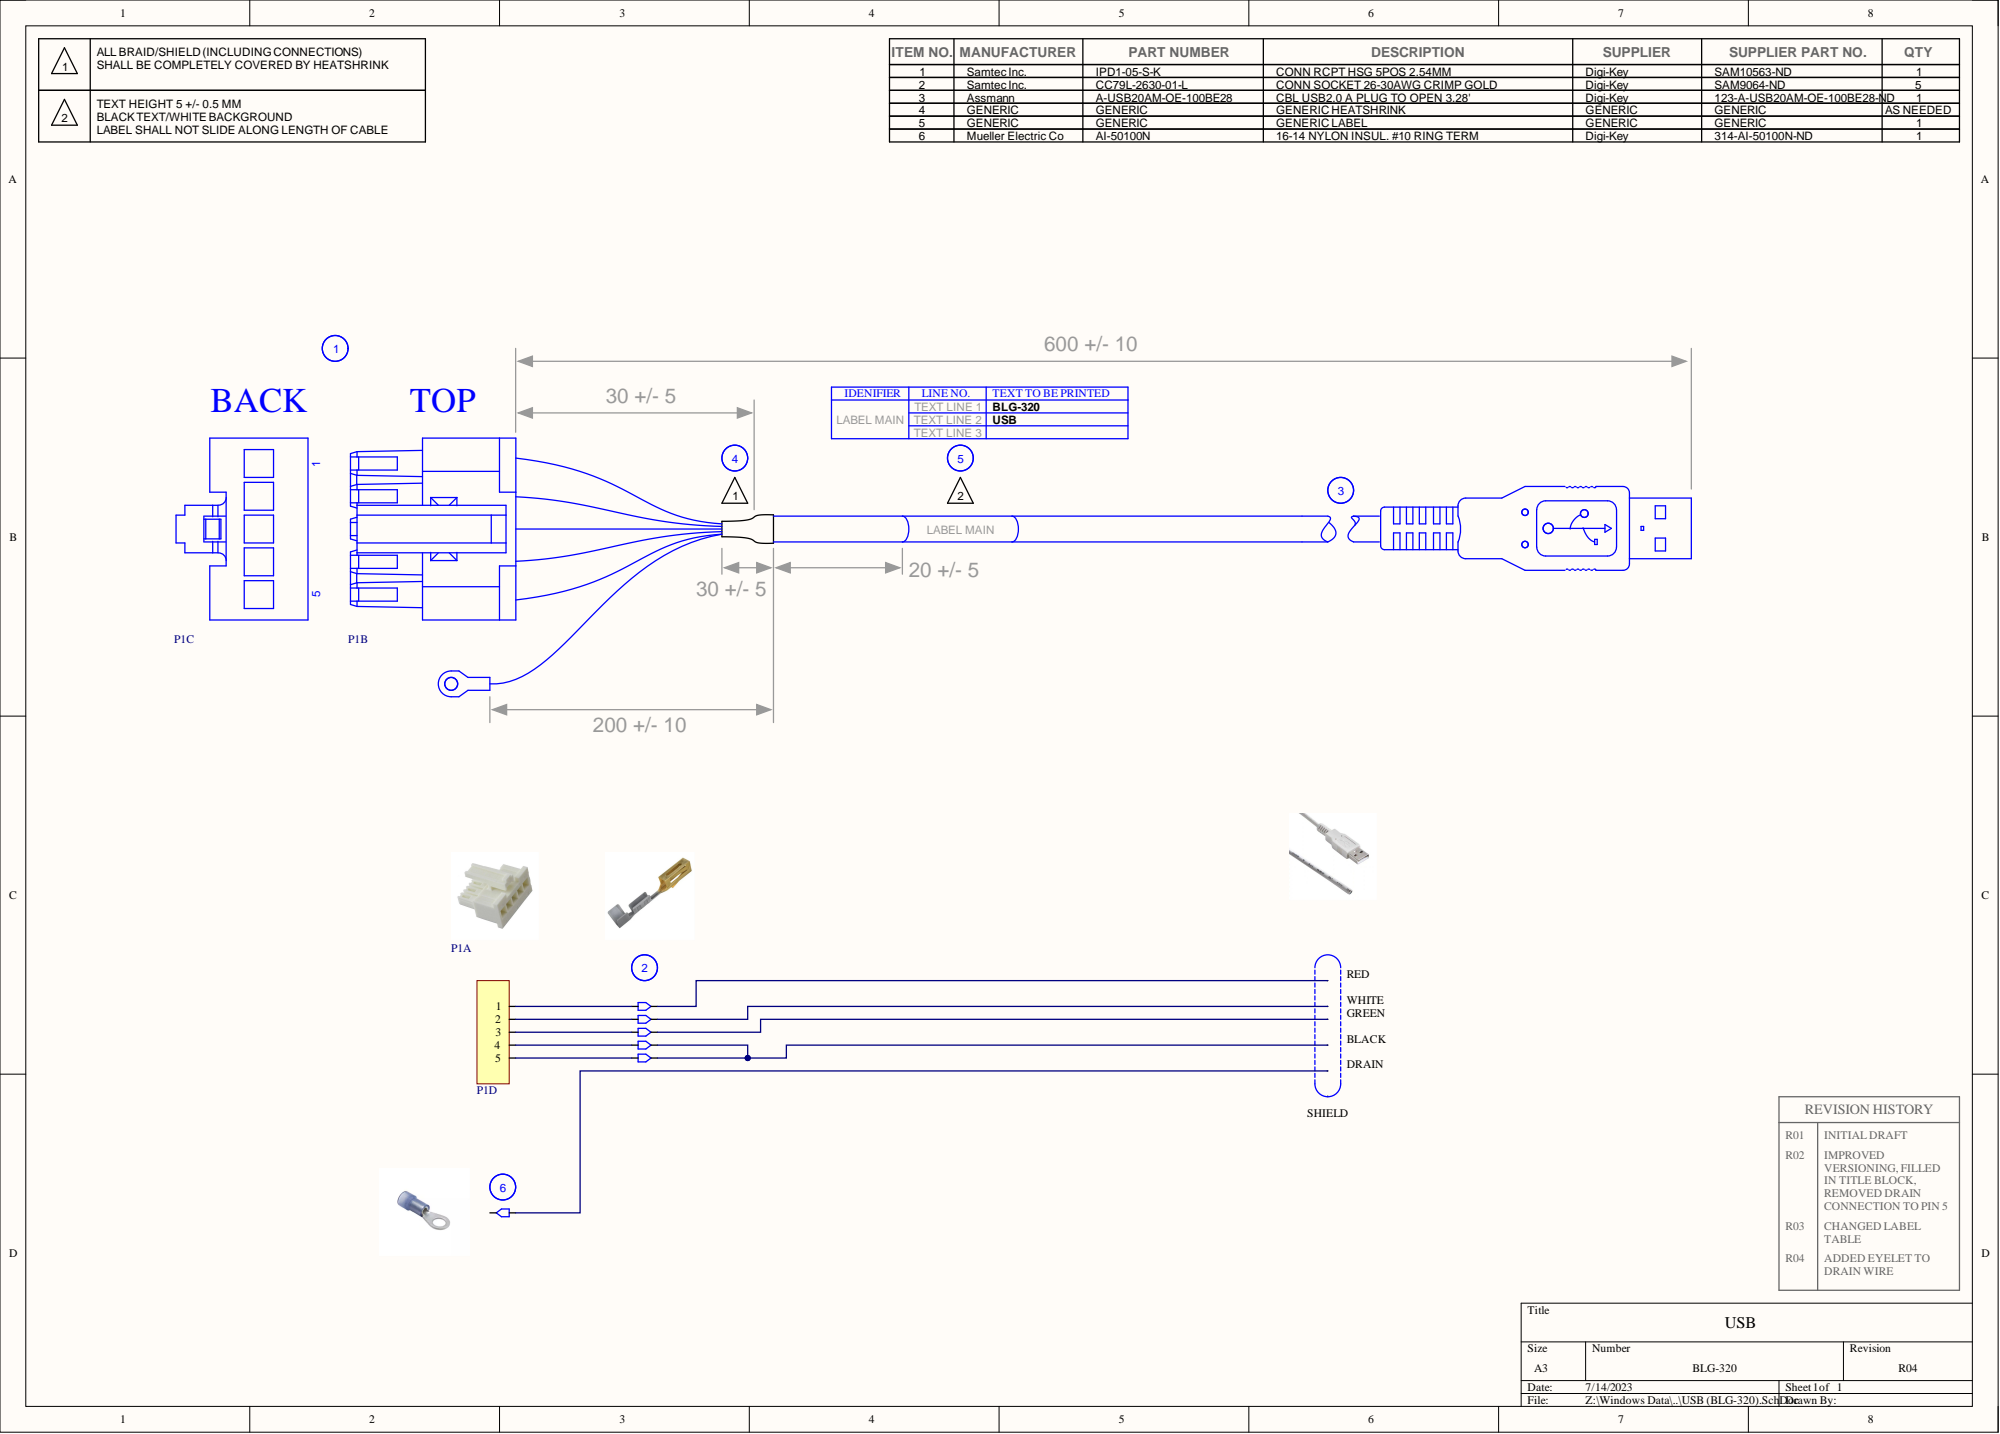
[picture p68: page 1]

ALL BRAID/SHIELD (INCLUDING CONNECTIONS)
SHALL BE COMPLETELY COVERED BY HEATSHRINK

1 | Samtec Inc. | IPD1-05-S-K | CONN RCPT HSG 5POS 2.54MM | Digi-Key | SAM10563-ND | 1
2 | Samtec Inc. | CC79L-2630-01-L | CONN SOCKET 26-30AWG CRIMP GOLD | Digi-Key | SAM9064-ND | 5

TEXT HEIGHT 5 +/- 0.5 MM
BLACK TEXT/WHITE BACKGROUND
LABEL SHALL NOT SLIDE ALONG LENGTH OF CABLE

4 | GENERIC | GENERIC | GENERIC HEATSHRINK | GENERIC | GENERIC | AS NEEDED
5 | GENERIC | GENERIC | GENERIC LABEL | GENERIC | GENERIC | 1
6 | Mueller Electric Co | AI-50100N | 16-14 NYLON INSUL. #10 RING TERM | Digi-Key | 314-AI-50100N-ND | 1

IDENIFIER | LINE NO. | TEXT TO BE PRINTED
LABEL MAIN | TEXT LINE 1 | BLG-320

TEXT LINE 2 | USB
TEXT LINE 3
