Aitoubella/Freezer_FW/Hardware/Harness cable drawing/COMPRESSOR (BLG-319_R04).pdf

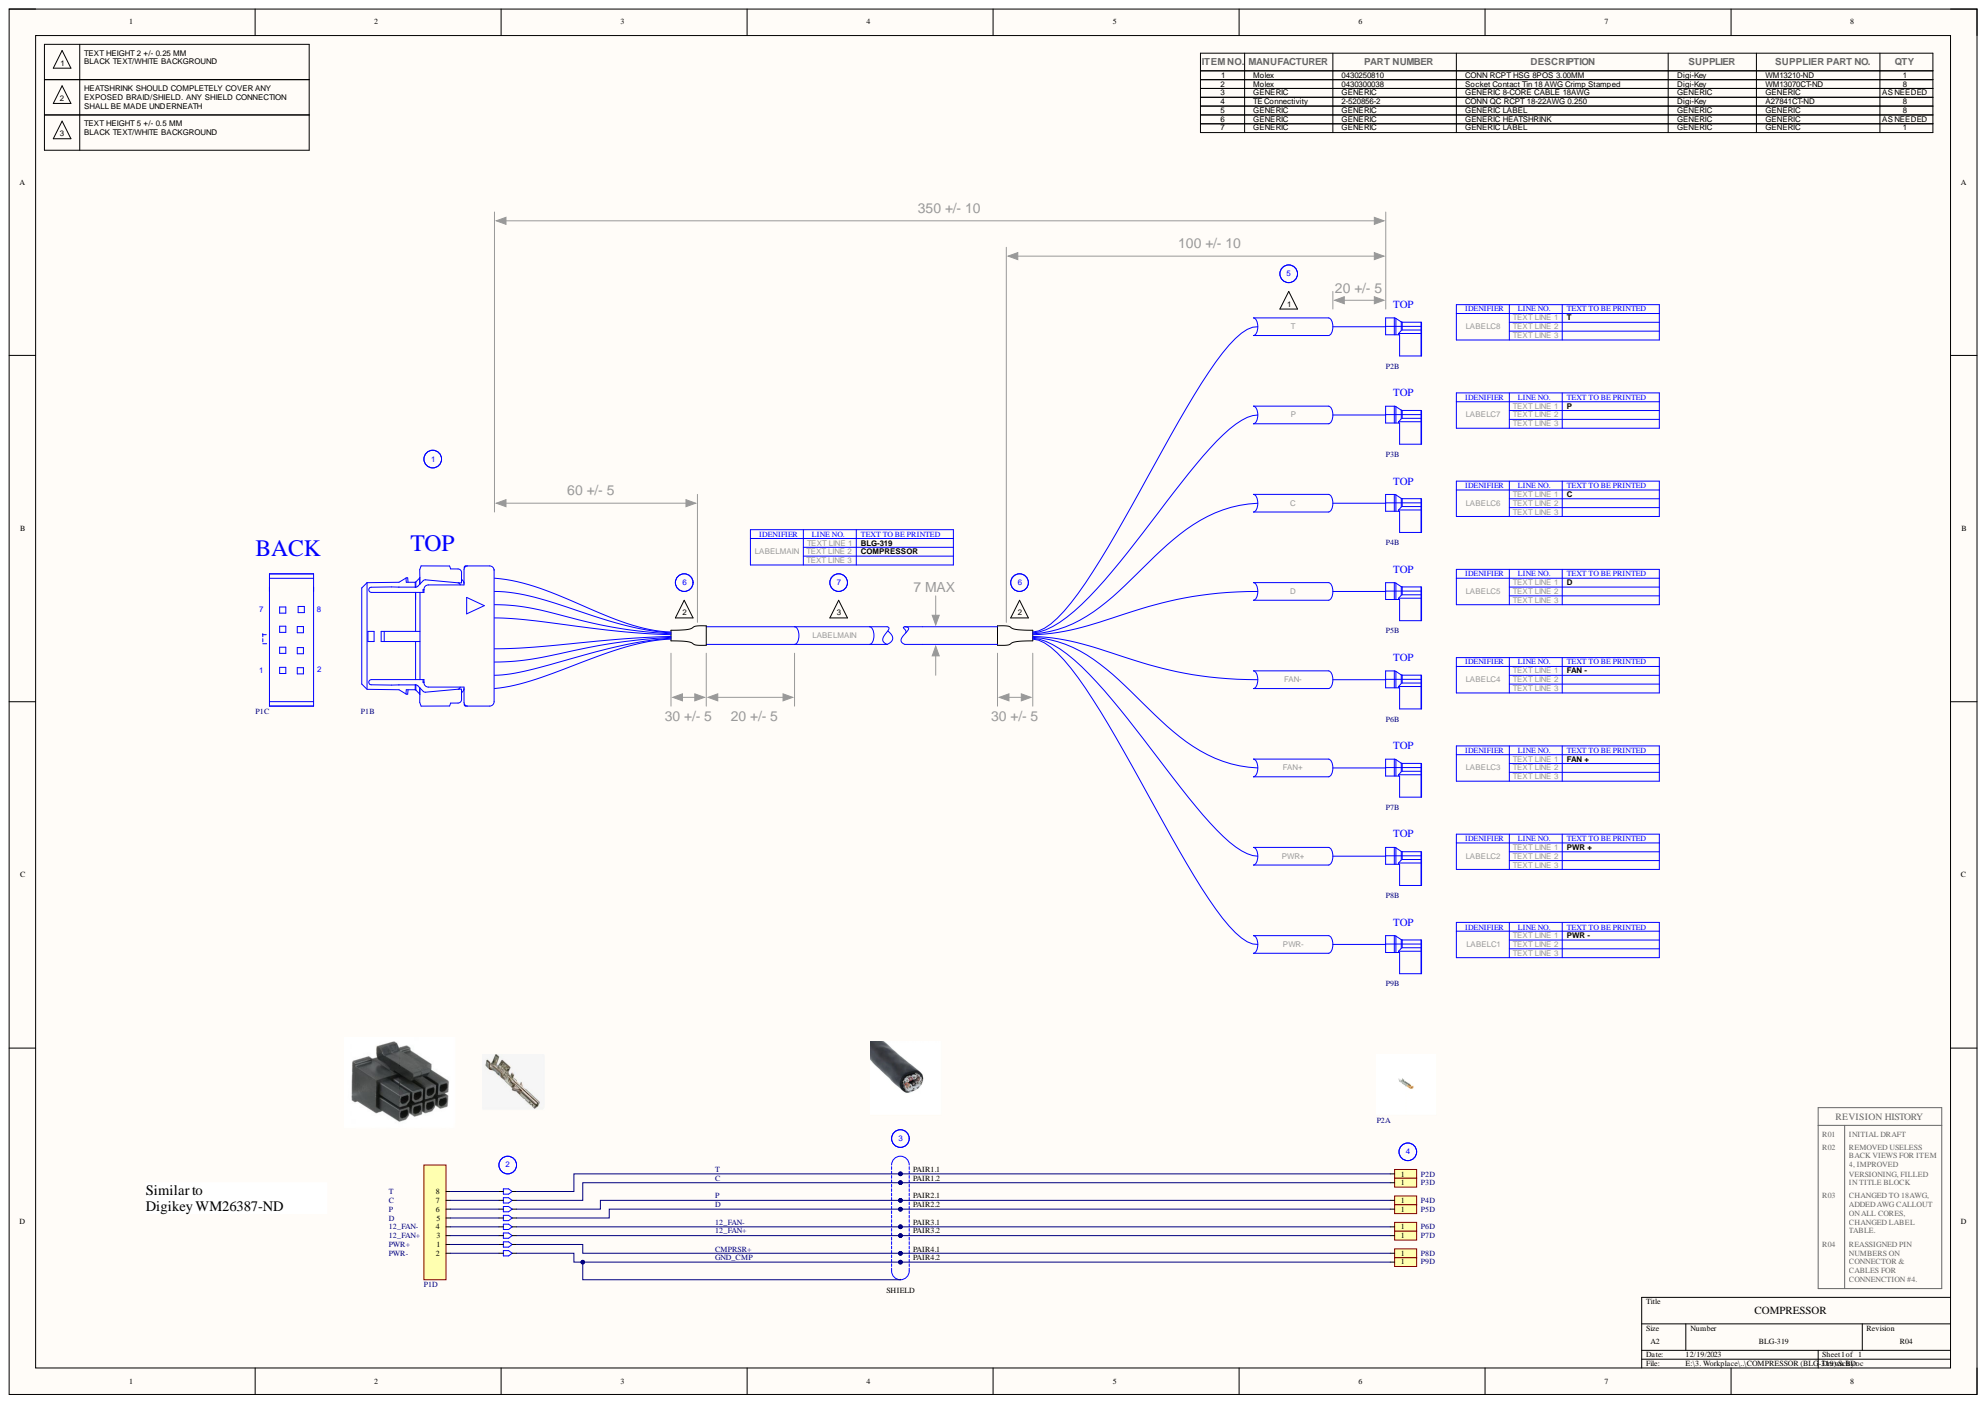
[picture p69: page 1]

1 | T E X T H E IGH T 2 + / -0 . 2 5 M M B L A C K T E X T/ W H I T E B A C KGROU N D

I T E M N O | . M A N U FAC T U R E R | P A R T N U M B E R | D E S C R I P T I O N | S U P P L I E R | S U P P L I E R P A R T N O . | QT Y

2 | H E ATS H R I N K S HOU L D COM P L E T E LY COV E R A N Y E X POS E D B R A I D / S H I E L D . A N Y S H I E L D CON N E C T ION S H A L L B E M A D E U N D E R N E AT H

3 | T E X T H E IGH T 5 + / -0 . 5 M M B L A C K T E X T/ W H I T E B A C KGROU N D

T E X T L I N E 2
T E X T L I N E 3

L A B E L M A I N | T E X T L I N E 1 | BLG-3 1 9

T E X T L I N E 2 | COM P R E S SOR
