Aitoubella/Freezer_FW/Hardware/Harness cable drawing/I-O (BLG-318_R05).pdf

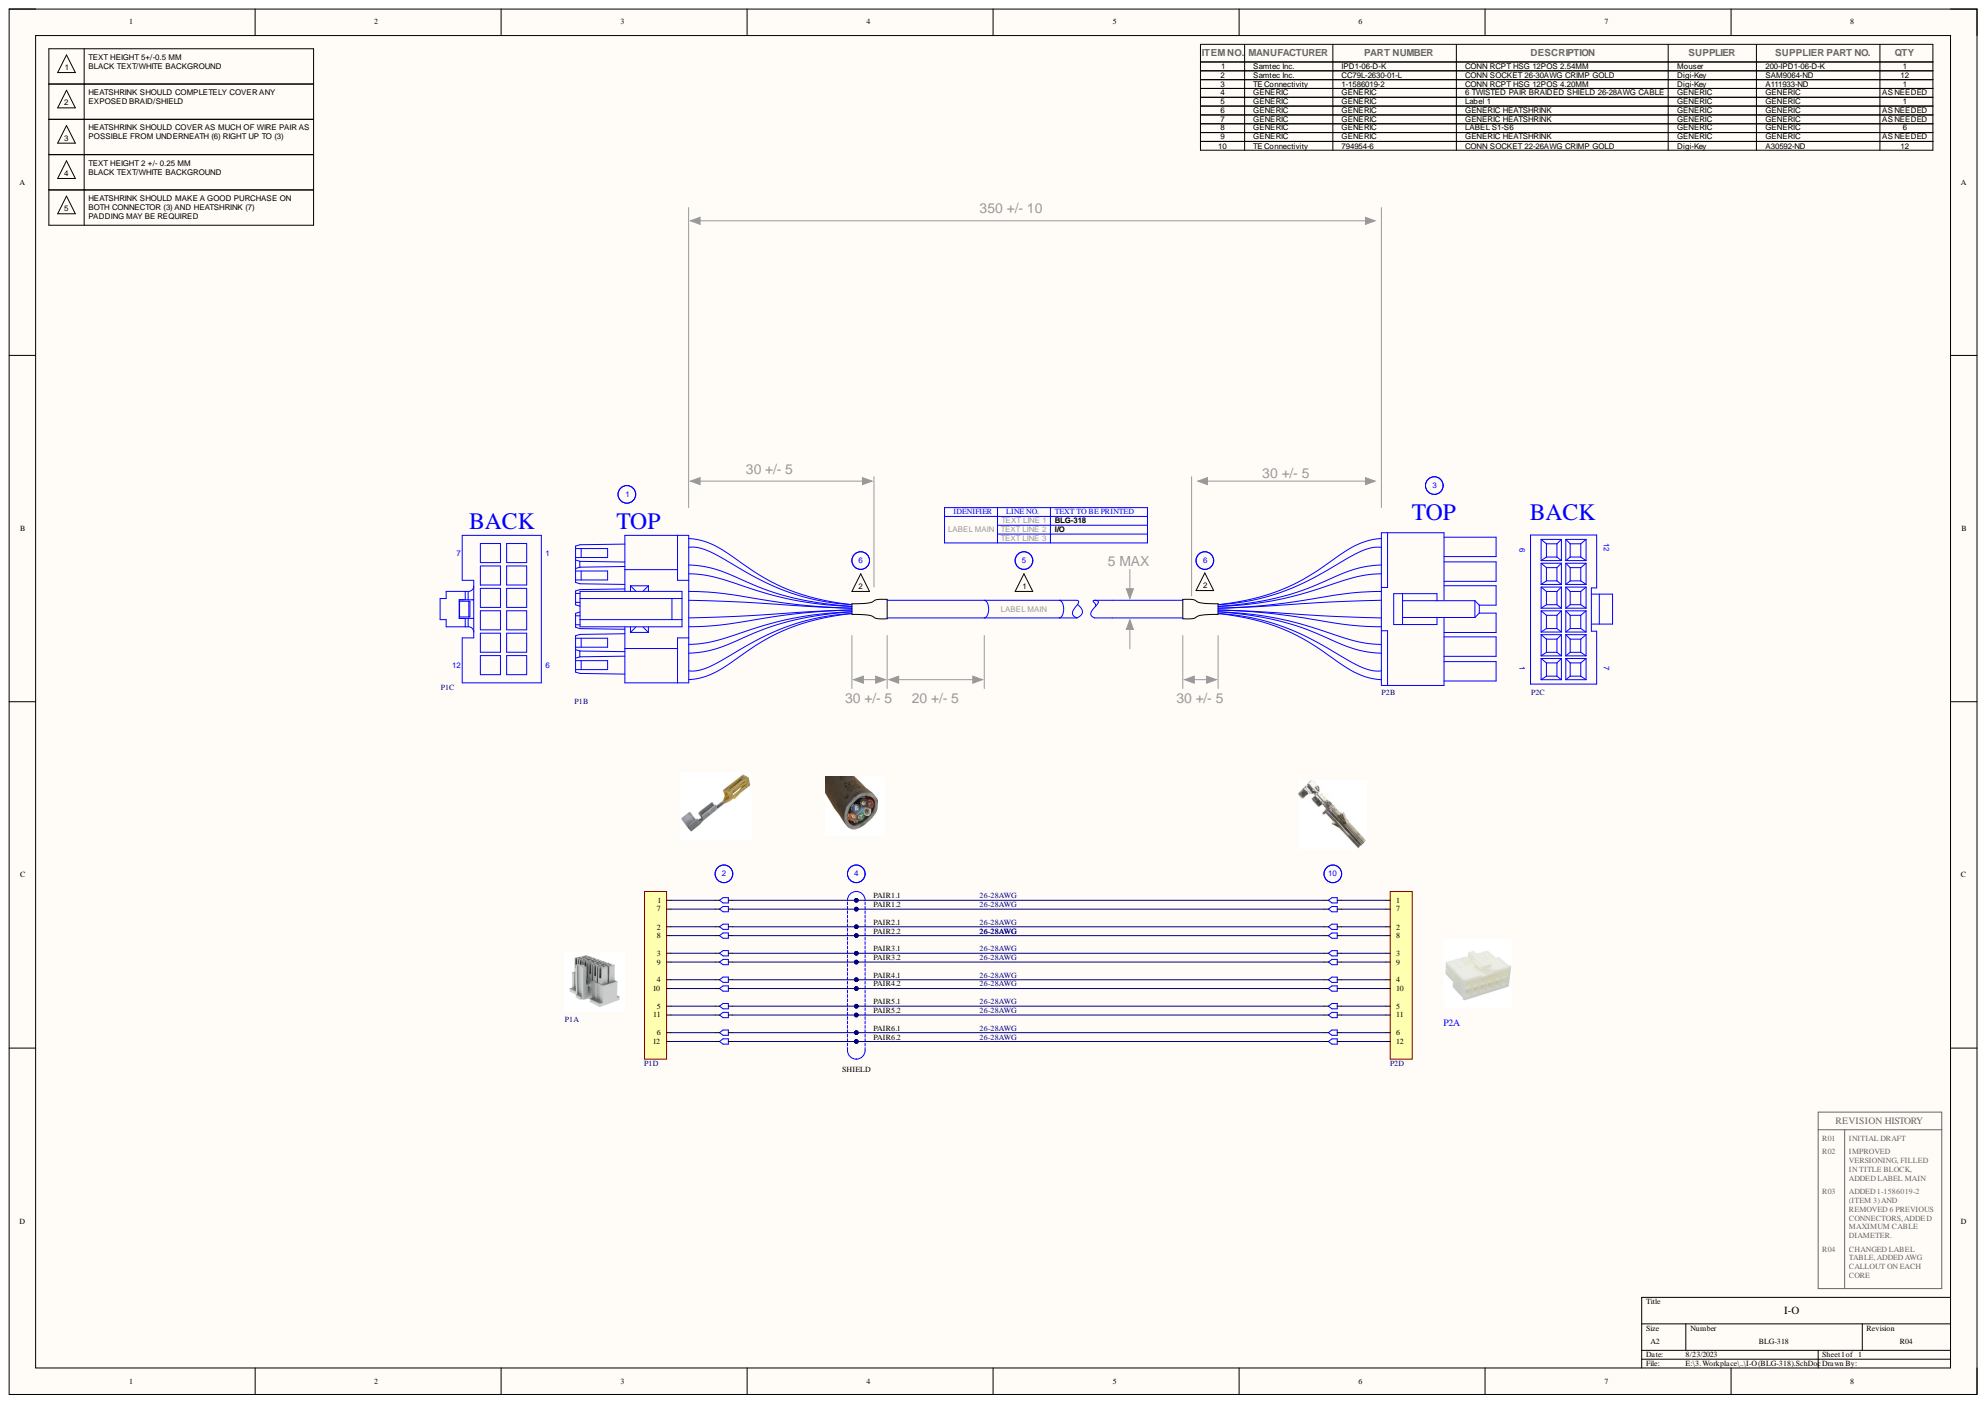
[picture p70: page 1]
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

3 | H E ATS H R I N K S HOU L D COV E R A S M U C H OF W I R E P A I R A S POS S I B L E FROM U N D E R N E AT H ( 6 ) R IGH T U P TO ( 3 )

4 | T E X T H E IGH T 2 + / -0 . 2 5 M M B L A C K T E X T/ W H I T E B A C KGROU N D

5 | H E ATS H R I N K S HOU L D M A K E A GOOD P U R C H A S E ON BOT H CON N E C TOR ( 3 ) A N D H E ATS H R I N K ( 7 ) P A D D I NG M AY B E R EQU I R E D

L A B E L M A I N | T E X T L I N E 1 | BLG-3 1 8
