Aitoubella/Freezer_FW/(list of files, drawings)

Other design files:
Hardware/Freezer_Controller/Audio.SchDoc
Hardware/Freezer_Controller/DisplayIface.SchDoc
Hardware/Freezer_Controller/FLASH.SchDoc
Hardware/Freezer_Controller/Freezer_Controller.PrjPcb
Hardware/Freezer_Controller/Micro.SchDoc
Hardware/Freezer_Controller/PcbLib1.PcbLib
Hardware/Freezer_Controller/Power.SchDoc
Hardware/Freezer_Controller/RTC.SchDoc
Hardware/Freezer_Controller/RTDIface.SchDoc
Hardware/Freezer_Controller/SoftPowerSwitch.SchDoc
Hardware/Freezer_Controller/TopLevel.SchDoc
Hardware/Freezer_Controller/USBIface.SchDoc
Hardware/Freezer_Power/12VOutIface.SchDoc
Hardware/Freezer_Power/BatteryCharger.SchDoc
Hardware/Freezer_Power/CompressorIface.SchDoc
Hardware/Freezer_Power/Freezer_Power.PcbLib
Hardware/Freezer_Power/Freezer_Power.PrjPcb
Hardware/Freezer_Power/Freezer_Power.SCHLIB
Hardware/Freezer_Power/Power.SchDoc
Hardware/Freezer_Power/Schlib1.SchLib
Hardware/Freezer_Power/TopLevel.SchDoc
