Aitoubella/Freezer_FW/Firmware/Cold Storage/ColdStorage.ioc

Mcu.UserName=STM32L476VGTx
PA0.GPIO_Label=Buzzer
PA0.Signal=GPIO_Output
PA1.Signal=ADCx_IN6
PA10.Signal=USB_OTG_FS_ID
PA11.Signal=USB_OTG_FS_DM
PA12.Signal=USB_OTG_FS_DP
PA2.Signal=ADCx_IN7
PA3.GPIO_Label=AUDIO_EN
PA3.Signal=GPIO_Output
PA5.GPIO_Label=AUDIO_SIG
PA5.Signal=COMP_DAC12_group
PA6.GPIO_Label=FLASH_MISO
PA6.Signal=SPI1_MISO
PA7.GPIO_Label=FLASH_MOSI
PA7.Signal=SPI1_MOSI
PA9.Signal=USB_OTG_FS_VBUS
PB10.Signal=I2C2_SCL
PB11.Signal=I2C2_SDA
PB12.GPIO_Label=SD_SS
PB12.Signal=SPI2_NSS
PB13.GPIO_Label=SD_SCK
PB13.Signal=SPI2_SCK
PB14.GPIO_Label=EXT_PWR_ON_Z
PB14.Signal=GPIO_Input
PB15.GPIO_Label=SD_MOSI
PB15.Signal=SPI2_MOSI
PB6.Signal=I2C1_SCL
PB7.Signal=I2C1_SDA
PB9.GPIO_Label=PWR
PB9.Signal=GPIO_Output
PC0.Signal=ADCx_IN1
PC1.Signal=ADCx_IN2
PC10.GPIO_Label=TFT_CLK
PC10.Signal=SPI3_SCK
PC11.GPIO_Label=TFT_MISO
PC11.Signal=SPI3_MISO
PC12.GPIO_Label=TFT_MOSI
PC12.Signal=SPI3_MOSI
PC2.GPIO_Label=SD_MISO
PC2.Signal=SPI2_MISO
PC4.Signal=ADCx_IN13
PC5.Signal=ADCx_IN14
PC7.GPIO_Label=TFT_RST
PC7.Signal=GPIO_Output
PC8.GPIO_Label=TFT_BKLGHT
PC8.Signal=GPIO_Output
PC9.GPIO_Label=TFT_WRX
PC9.Signal=GPIO_Output
PD0.GPIO_Label=VMAIN_VS_3.3
PD0.Signal=GPIO_Input
PD1.GPIO_Label=VBATT_VS_3.3
PD1.Signal=GPIO_Input
PD10.GPIO_Label=CMPRSR_EN
PD10.Signal=GPIO_Output
PD11.GPIO_Label=CMPRSR_FAN_N
PD11.Signal=GPIO_Output
PD12.GPIO_Label=CMPRSR_FAN_
PD12.Signal=GPIO_Output
PD14.GPIO_Label=CHRG_OK
PD14.Signal=GPIO_Input
PD15.GPIO_Label=Blink
PD15.Signal=GPIO_Output
PD2.GPIO_Label=DCDC_VS_3.3
PD2.Signal=GPIO_Input
PD3.GPIO_Label=ACDC_VS_3.3
PD3.Signal=GPIO_Input
PD5.GPIO_Label=HTR_CTL
PD5.Signal=GPIO_Input
PD6.GPIO_Label=FAN_CTL1
PD6.Signal=GPIO_Input
PD7.GPIO_Label=FAN_CTL2
PD7.Signal=GPIO_Input
PD9.GPIO_Label=CMPRSR_SPD
PD9.Signal=GPIO_Output
PE0.GPIO_Label=EXT_PWR_ON
PE0.Signal=GPIO_Output
PE10.GPIO_Label=BTN2_R
PE10.Signal=GPIO_Input
PE11.GPIO_Label=BTN3_R
PE11.Signal=GPIO_Input
PE12.GPIO_Label=FLASH_CS
PE12.Signal=SPI1_NSS
PE13.GPIO_Label=FLASH_CLK
PE13.Signal=SPI1_SCK
PE14.GPIO_Label=FLASH_RST
PE14.Signal=GPIO_Output
PE9.GPIO_Label=BTN1_D
PE9.Signal=GPIO_Input
