Aitoubella/Freezer_FW/Firmware/controller_v2/Core/Src/main.c

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
/* Includes ------------------------------------------------------------------*/
#include "main.h"
#include "cmsis_os.h"
#include "adc.h"
#include "crc.h"
#include "dma.h"
#include "fatfs.h"
#include "i2c.h"
#include "quadspi.h"
#include "sai.h"
#include "spi.h"
#include "usart.h"
//#include "usb_host.h"
#include "gpio.h"

/* USER CODE BEGIN Includes */
#include "printf.h"
#include "lcd_ui.h"
#include "event.h"
#include "DS1307.h"
#include "led.h"
#include "buzzer.h"
#include "RTD.h"
#include "board.h"
#include "lcd_interface.h"
#include "main_app.h"
//#include "logging.h"
#include "bms.h"
#include "power_board.h"
#include "led_signal.h"
/* USER CODE END Includes */


void SystemClock_Config(void);
void PeriphCommonClock_Config(void);
void MX_FREERTOS_Init(void);
/**
  * @brief  The application entry point.
  * @retval int
  */
int main(void)
{
  /* MCU Configuration--------------------------------------------------------*/

  /* Reset of all peripherals, Initializes the Flash interface and the Systick. */
  HAL_Init();

  /* Configure the system clock */
  SystemClock_Config();

/* Configure the peripherals common clocks */
  PeriphCommonClock_Config();

  /* Initialize all configured peripherals */
  MX_GPIO_Init();
  MX_DMA_Init();
  MX_ADC1_Init();
  MX_SPI2_Init();
  MX_FATFS_Init();
  MX_SPI3_Init();
  MX_I2C1_Init();
  MX_CRC_Init();
  MX_QUADSPI_Init();
  MX_SAI1_Init();
  MX_UART4_Init();
  /* USER CODE BEGIN 2 */
  printf("\nApplication started!");
  pwr_ctrl_on(); //On power 5V
  logging_init();
  event_init();
  //RTD temperature sensor
  rtd_init();
  //led library
  led_init();
  //Buzzer
  buzzer_init();

  //Init i2c periph for DS1307
  DS1307_Init(&hi2c1);


  /* USER CODE END 2 */

  /* Call init function for freertos objects (in freertos.c) */
  MX_FREERTOS_Init();

  /* Start scheduler */
  osKernelStart();

  /* We should never get here as control is now taken by the scheduler */
  /* Infinite loop */
  /* USER CODE BEGIN WHILE */
  while (1)
  {
//	 event_run_task();
    /* USER CODE END WHILE */

    /* USER CODE BEGIN 3 */
  }
  /* USER CODE END 3 */
}

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
/* USER CODE BEGIN 4 */

void _putchar(char character)
{
	HAL_UART_Transmit(&huart4,(uint8_t *)&character, 1, 10);
}

void __io_putchar(uint8_t ch)
{
	HAL_UART_Transmit(&huart4, &ch, 1, 10);
}

int _write(int file, char *ptr, int len)
{
	(void)file;
	 int DataIdx;

	  for (DataIdx = 0; DataIdx < len; DataIdx++)
	  {
	    __io_putchar(*ptr++);
	  }
	 setbuf(stdout, NULL);
	 return len;
}
/* USER CODE END 4 */
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
