Aitoubella/Freezer_FW/Firmware/controller_v2/Core/Inc/main.h

#define MAX_USB_BUFFER         4096
#define AUDIO_EN_Pin GPIO_PIN_3
#define AUDIO_EN_GPIO_Port GPIOE
#define RTD5_IN1_Pin GPIO_PIN_0
#define RTD5_IN1_GPIO_Port GPIOC
#define RTD6_IN2_Pin GPIO_PIN_1
#define RTD6_IN2_GPIO_Port GPIOC
#define SD_SPI2_MISO_Pin GPIO_PIN_2
#define SD_SPI2_MISO_GPIO_Port GPIOC
#define SD_SPI2_MOSI_Pin GPIO_PIN_3
#define SD_SPI2_MOSI_GPIO_Port GPIOC
#define RTD1_IN7_Pin GPIO_PIN_2
#define RTD1_IN7_GPIO_Port GPIOA
#define RTD2_IN8_Pin GPIO_PIN_3
#define RTD2_IN8_GPIO_Port GPIOA
#define TFT_CS_Pin GPIO_PIN_4
#define TFT_CS_GPIO_Port GPIOA
#define Buzzer_Pin GPIO_PIN_5
#define Buzzer_GPIO_Port GPIOA
#define RTD3_IN13_Pin GPIO_PIN_4
#define RTD3_IN13_GPIO_Port GPIOC
#define RTD4_IN14_Pin GPIO_PIN_5
#define RTD4_IN14_GPIO_Port GPIOC
#define BTN_UP_Pin GPIO_PIN_8
#define BTN_UP_GPIO_Port GPIOE
#define BTN_ENTER_Pin GPIO_PIN_9
#define BTN_ENTER_GPIO_Port GPIOE
#define BTN_DOWN_Pin GPIO_PIN_10
#define BTN_DOWN_GPIO_Port GPIOE
#define FLASH_CS_Pin GPIO_PIN_11
#define FLASH_CS_GPIO_Port GPIOE
#define FLASH_RST_Pin GPIO_PIN_12
#define FLASH_RST_GPIO_Port GPIOE
#define SD_CS_Pin GPIO_PIN_12
#define SD_CS_GPIO_Port GPIOB
#define SD_SPI2_SCK_Pin GPIO_PIN_13
#define SD_SPI2_SCK_GPIO_Port GPIOB
#define PWR_CTL_Pin GPIO_PIN_8
#define PWR_CTL_GPIO_Port GPIOD
#define CMPRSR_SPD_Pin GPIO_PIN_9
#define CMPRSR_SPD_GPIO_Port GPIOD
#define CMPRSR_EN_Pin GPIO_PIN_10
#define CMPRSR_EN_GPIO_Port GPIOD
#define PWR_EN_IN_Pin GPIO_PIN_11
#define PWR_EN_IN_GPIO_Port GPIOD
#define CMPRSR_FAN_VCC_Pin GPIO_PIN_12
#define CMPRSR_FAN_VCC_GPIO_Port GPIOD
#define CMPRSR_D_Pin GPIO_PIN_13
#define CMPRSR_D_GPIO_Port GPIOD
#define CHRG_OK_Pin GPIO_PIN_14
#define CHRG_OK_GPIO_Port GPIOD
#define LED_Pin GPIO_PIN_15
#define LED_GPIO_Port GPIOD
#define TFT_RST_Pin GPIO_PIN_7
#define TFT_RST_GPIO_Port GPIOC
#define TFT_BKLIGHT_Pin GPIO_PIN_8
#define TFT_BKLIGHT_GPIO_Port GPIOC
#define TFT_DC_Pin GPIO_PIN_9
#define TFT_DC_GPIO_Port GPIOC
#define USBPWREN_Pin GPIO_PIN_8
#define USBPWREN_GPIO_Port GPIOA
#define TFT_SPI3_SCK_Pin GPIO_PIN_10
#define TFT_SPI3_SCK_GPIO_Port GPIOC
#define TFT_SPI3_MISO_Pin GPIO_PIN_11
#define TFT_SPI3_MISO_GPIO_Port GPIOC
#define TFT_SPI3_MOSI_Pin GPIO_PIN_12
#define TFT_SPI3_MOSI_GPIO_Port GPIOC
#define VMAIN_VS_3V3_Pin GPIO_PIN_0
#define VMAIN_VS_3V3_GPIO_Port GPIOD
#define VBAT_VS_3V3_Pin GPIO_PIN_1
#define VBAT_VS_3V3_GPIO_Port GPIOD
#define DCDC_VS_3V3_Pin GPIO_PIN_2
#define DCDC_VS_3V3_GPIO_Port GPIOD
#define ACDC_VS_3V3_Pin GPIO_PIN_3
#define ACDC_VS_3V3_GPIO_Port GPIOD
#define HTR_CTL_Pin GPIO_PIN_5
#define HTR_CTL_GPIO_Port GPIOD
#define FAN_CTL1_Pin GPIO_PIN_6
#define FAN_CTL1_GPIO_Port GPIOD
#define FAN_CTL2_Pin GPIO_PIN_7
#define FAN_CTL2_GPIO_Port GPIOD
#define EXT_I2C1_SCL_Pin GPIO_PIN_6
#define EXT_I2C1_SCL_GPIO_Port GPIOB
#define EXT_I2C1_SDA_Pin GPIO_PIN_7
#define EXT_I2C1_SDA_GPIO_Port GPIOB
#define EXT_PWR_ON_Z_Pin GPIO_PIN_0
#define EXT_PWR_ON_Z_GPIO_Port GPIOE
