Aitoubella/Freezer_FW/Firmware/controller_v2/Core/Inc/LCDController.h

/*
 * LCDController.h
 *
 *  Created on: Sep 28, 2023
 *      Author: controllerstech
 */

#ifndef INC_LCDCONTROLLER_H_
#define INC_LCDCONTROLLER_H_


#ifdef __cplusplus
extern "C" {
#endif

/*********************
 *      INCLUDES
 *********************/

#include "lvgl.h"


/*********************
 *      DEFINES
 *********************/

/**********************
 *      TYPEDEFS
 **********************/

/**********************
 * GLOBAL PROTOTYPES
 **********************/
/* Initialize low level display driver */
void lv_port_disp_init(void);

/* Enable updating the screen (the flushing process) when disp_flush() is called by LVGL
 */
void disp_enable_update(void);

/* Disable updating the screen (the flushing process) when disp_flush() is called by LVGL
 */
void disp_disable_update(void);

/**********************
 *      MACROS
 **********************/

#ifdef __cplusplus
} /*extern "C"*/
#endif


#endif /* INC_LCDCONTROLLER_H_ */
