Aitoubella/Freezer_FW/(commit log)

2023-08-09 Freezer requirements
    Freezer requirements and schematics confirmed so far
2023-08-15 SPI protocol analysis in IPS LCD color TFT 2.8" display
2023-08-15 Configure Multivector Interrupt Mode.
2023-08-17 hardware code commit
    [12VOutIface.SchDoc, Audio.SchDoc, BatteryCharger.SchDoc, CompressorIface.SchDoc, DisplayIface.SchDoc, FLASH.SchDoc, Freezer_Controller.PrjPcb, Freezer_Power.PrjPcb]
2023-08-18 Fix Freezer_Power schematic and PCB changes.
    [12VOutIface.SchDoc, BatteryCharger.SchDoc, CompressorIface.SchDoc, Power.SchDoc, TopLevel.SchDoc]
2023-08-18 Add Test points in BatteryCharger.SchDoc
    [BatteryCharger.SchDoc]
2023-08-21 Hardware rest work(add the silkscreens), creating a graphical library for displaying on LCD and coding the LCD control part, fix ILI9341 library for interfacing.
    [TopLevel.SchDoc]
2023-08-22 The interfaces with microcontroller using SPI, I2C and GPIOs on the Mplab X IDE.
2023-08-23 change MCU to STM32.
    [Micro.SchDoc]
2023-08-23 Change MCU to STM32 in Freezer_Controller, STM32L476 datasheet analysis
    [Micro.SchDoc]
2023-08-23 *Add booting option, crystal and serial debugger port in Micro.schdoc *Updates to cable harness drawings. - AC-DC TO POWER BOARD (BLG-362_R03) - BATTERY TO POWER BOARD (BLG-365_R04) - COMPRESSOR (BLG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
    [Micro.SchDoc, TopLevel.SchDoc]
2023-08-24 Configuration 3xSPI, I2C, 32xGPIOs, Audio Signal (DAC_OUT) and SOSCI device pins in schematic by referring to stm32 CubeMX.
    [Micro.SchDoc, TopLevel.SchDoc]
2023-08-25 Edit micro schematic, footprint and PCB layout design.
    [Micro.SchDoc, TopLevel.SchDoc]
2023-08-29 Redeploy the net label back to STM32L476VGT6
    [Micro.SchDoc, TopLevel.SchDoc]
2023-08-30 Routing the Controller PCB layout, Change to 2068320823 Molex connector.
    [FLASH.SchDoc, Micro.SchDoc, TopLevel.SchDoc]
2023-08-31 - relocating and routing the caps and resistors around the MCU). - change the connector pin order.
    [DisplayIface.SchDoc, PcbLib1.PcbLib]
2023-09-01 Complete Freezer_Controller PCB layout design.
    [Micro.SchDoc, PcbLib1.PcbLib, TopLevel.SchDoc]
2023-09-04 Review power and control board designs for EMC noise. Controller Board (Micro, Power.schDoc), Power board analysis.
2023-09-05 Add sd card for data logging, testpoints and piezo buzzer.
    [Audio.SchDoc, DisplayIface.SchDoc, FLASH.SchDoc, Freezer_Controller.PrjPcb, Micro.SchDoc, PcbLib1.PcbLib, Power.SchDoc, RTC.SchDoc]
2023-09-06 Review Micro, Flash(SD card), Power, RTC and Audio schematic and PCB. Create a Gerber, BOM, CPL file of the Controller board. Fixed the unreasonable points of the Power board. Research additional tem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
    [FLASH.SchDoc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]
2023-09-07 Add 12V_FAN+, 12V_FAN-net according to compressor manual in CompressorIface.schdoc. Add new 2x4 pin 3mm header J19 for 8 nets(HTR_CTL, CHRG_OK, FAN_CTL1, 2, CMPRSR_EN, CMPRSR_FAN and etc) in Toplevel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
    [CompressorIface.SchDoc, Freezer_Power.PrjPcb, Power.SchDoc, TopLevel.SchDoc]
2023-09-08 Power PCB layout routing according to the CompressorIface, Power and Toplevel.schdoc.
2023-09-11 Add test points for power board and review the board. Create Gerber, BOM, 3D, and CPL files for the power board.
    [BOM_Power.xlsx, Freezer_Power.PrjPcb, Pick Place for Freezer_Power.csv]
2023-09-12 Add the function to every pin in STM32CubeMX. The MCU's pinout is almost complete, and the compressor's pinout is not clear, so I analyzed it.
2023-09-13 complete controller board project
    [Freezer_Controller.PrjPcb]
2023-09-13 Initializing the function declaration and definition for the AD part of the temperature sensing RTD.
    [Freezer_Controller.GBL, Freezer_Controller.GBO, Freezer_Controller.GBP, Freezer_Controller.GBS, Freezer_Controller.GKO, Freezer_Controller.GM1, Freezer_Controller.GTL, Freezer_Controller.GTO]
2023-09-15 Change DNP to R97 of U5 part in toplevel
    [Freezer_Power.PrjPcb]
2023-09-15 Declaring and defining decode, encode, get and print functions for RTC timers.
2023-09-18 Fix the DNP designator on the power board to R97.
    [TopLevel.SchDoc]
2023-09-19 Writing API of Event, I2C interface Scan.
2023-09-20 Key board: Write API read button to compatible project
2023-09-21 SPI flash memory datasheet analysis and API library creation.
2023-09-25 CRC, DMA, 100% Completing of SD card API Library
2023-09-26 Designing block data to store. Memory to store count read,write data internal flash. Algrithm to prevent exeed brick internal memory.
    [flash.c, flash.h]
2023-09-28 50% completing of ili9341 LCD Driver.
2023-09-29 Completing of ili9341 LCD Driver.
2023-10-02 PID Algorithm, Buzzer Code
    [PID.c, PID.h, buzzer.c, buzzer.h]
2023-10-03 LCD: main frame in progress
2023-10-04 - Create a harness pinout diagram for the new compressor connector. - Done main frame and setting frame.
2023-10-06 Done frame setting temperature and datetime
    [Freezer_Controller.PrjPcb]
2023-10-11 stm32f103vet6 LVGL porting done.
2023-10-12 stm32f103 RAM optimization.
2023-10-13 LVGL port done, UART_CLI: 80%
    [Freezer_Controller_BOM.xlsx]
2023-10-16 UART CLI Done.
2023-10-17 Confirm LCD driver run -> next fix lvgl to run
    [STM32F411_LVGL.ioc, ili9341.c, ili9341.h, main.c, main.h]
2023-10-18 setting temperature and Alarm monitor done
2023-10-23 LCD Pin allocation and initialization functions by CubeMx
2023-10-23 Firmware : LCD Test firmware done. Hardware : 5V power is required for the background of the LCD, and this is generated through SoftPowerSwitch schematic and Power schematic by BTN1.
2023-10-24 1. Hardware: Error analysis on softpowerswitch. Many nets are semi-coupled with each other, making it difficult to find errors through general analysis. This requires in-depth analysis using a dedica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
    [DS1307.c, DS1307.h, LCDController.c, board.c, board.h, event.h, flash.c]
2023-10-25 SD card and Buzzer test done.
    [DS1307.c, DS1307.h, LCDController.c, MT25QL.c, MT25QL.h, S25FL.c, board.c, board.h]
2023-10-26 1. Firmware : Button and Audio test done 2. Hardware : A phenomenon of excessive current flowing. 12V and 3.3V cannot be measured. Currently assumed to be a problem with the manufacturer.
    [LCDController.h, board.c, board.h, button.c, button.h]
2023-10-27 The USB seems to be operating as a host, but the flash memory is not currently recognized. Considering just in case, i think it is a good idea to design it as USB OTG so that USB supports both Host a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
2023-10-30 Hardware: Power Board Testing: Since the power board delivered to me was short-circuited, I tested the power status of four other power boards. For testing, Q10 was removed to make EN12 active. As a 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
    [DS1307.c, DS1307.h, File_Handling.c, File_Handling.h, MT25QL.c, MT25QL.h, PI4IOE.c, PI4IOE.h]
2023-10-31 Small changes on Controller board. 1. LCD Operating method via IM1,2,3,4 Nets. 2. SoftPowerSwitch via BTN1 3. Change R27 resistor with 1k 4. Audio Schematic : removing R3 and R4 5. USB redesign as OT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
    [Audio.SchDoc, DisplayIface.SchDoc, Freezer_Controller.PrjPcb, Micro.SchDoc, PcbLib1.PcbLib, Power.SchDoc, TopLevel.SchDoc, USBIface.SchDoc]
2023-11-02 LCD inprogress main login interface.
    [freezer_controler.cfg]
2023-11-03 temperature calibration_done, LCD_80%
2023-11-04 Basically, the following parts have been modified, the schematic has been completely completed. 1. POWER: Initial power design, it had limitations in maintaining the state of the Push Button. it will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
    [Audio.SchDoc, FLASH.SchDoc, Freezer_Controller.PrjPcb, Micro.SchDoc, PcbLib1.PcbLib, Power.SchDoc, SoftPowerSwitch.SchDoc, TopLevel.SchDoc]
2023-11-07 Controller Board PCB Layout inprogress.
    [FLASH.SchDoc, Freezer_Controller.PrjPcb, PcbLib1.PcbLib, Power.SchDoc, TopLevel.SchDoc, USBIface.SchDoc]
2023-11-09 - In power board, cleaned around C128 using soldering iron, remove and Q10 Fet, measure voltage test point(3.3V and 12V). - Fixbug PIOE libarary and test ouput, input logic done. - Fix bug main logic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
    [PI4IOE.c, PI4IOE.h, freezer_controler.ioc, main.c, main_app.c, power_board.c, power_board.h]
2023-11-10 The controller PCB layout is complete.
    [DisplayIface.SchDoc, PcbLib1.PcbLib, Power.SchDoc]
2023-11-13 The following parts have been completed: 1. Control of heater, compressor, and chamber fans has been completed. FAN is controlled by GPIO on the controller board. 2. Testing of the compressor has bee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
    [12VOutIface.SchDoc, BatteryCharger.SchDoc, CompressorIface.SchDoc, Freezer_Power.PcbLib, Freezer_Power.PrjPcb, Power.SchDoc, Schlib1.SchLib, TopLevel.SchDoc]
2023-11-15 Complete modification work on the control board and power board. Review circuit and PCB layout over 5 rounds.
    [12VOutIface.SchDoc, BatteryCharger.SchDoc, CompressorIface.SchDoc, DisplayIface.SchDoc, FLASH.SchDoc, Freezer_Controller.PrjPcb, Freezer_Power.PcbLib, Freezer_Power.PrjPcb]
2023-11-15 main logic done: temp, buzz, Fan, Compressor on/off.
    [DS1307.c, DS1307.h, LCDController.c, PI4IOE.c, PI4IOE.h, RTD.c, RTD.h, board.c]
2023-11-17 Firmware : Battery Testing -> Charging and discharging current setting and measurement, register reading and writing measurement completion
2023-11-17 Replace dip switch with 2pin header. Replaced RF4G060ATTCR p-channel mosfet with BSS308PE-HXY.
    Components were replaced with a lead time of 12 to 14 working days.
    BOM_Power
    LibRef RF4G060AT -- manufacturer part number RF4G060ATTCR
    LibRef DS01-254-S-01BE -- manufacturer part number DS01-254-S-01BE
    BOM_Controller
    LibRef CMP-12082-000002-1 -- manufacturer part number EMIF02-USB03F2
    LibRef CMP-RF4G060AT -- manufacturer part number RF4G060ATTCR
    LibRef DS01-254-S-02BE -- manufacturer part number DS01-254-S-02BE
    I am preparing a replacement for EMIF02-USB03F2.
    [BatteryCharger.SchDoc, CompressorIface.SchDoc, FLASH.SchDoc, Freezer_Controller.PrjPcb, Freezer_Power.PcbLib, Freezer_Power.PrjPcb, PcbLib1.PcbLib, Power.SchDoc]
2023-11-18 A 12V Battery was used for the battery test, and the testing of the battery circuit design was roughly completed through VREGN, SRP and SRN measurements of the BQ25731. Meanwhile, the firmware measur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
2023-11-19 Modified the footprint of IC2 (distance between pads - 0.17mm).
    [Freezer_Controller.PrjPcb, PcbLib1.PcbLib]
2023-11-21 New Firmware For EMC Testing in Progress : 75%
    [freezer_controler.cfg]
2023-11-21 - New Firmware For EMC Testing Done - Battery Firmware in Progress(charge completion status(CHRG_Ok) Done) : 90%
2023-11-23 For the battery testing, a 12V Battery was used and the charging voltage and current were accurately measured. Based on that, I was able to calculate the SOC and accurately monitor the battery.
2023-11-24 Modify the manufacturer part number for R27, R46.
    [Micro.SchDoc, Power.SchDoc]
2023-11-24 - Fix bug and logic charge and discharge show on lcd. - Research Lithium battery to improve algorithm percent charge and usage. - Optimize BQ25731 API: charge current and charge voltage with input fl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
    [BQ25731.c, BQ25731.h, RTD.c, bms.c, bms.h, flash_page.h]
2023-11-27 - Confirmation of 14.8V Battery usability based on compressor driver datasheet analysis - Guide report for connection to the connectors of the power board and controller board for EMC testing - LCD e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
    [BQ25731.c, BQ25731.h, bms.c, freezer_controler.ioc, main.c, main_app.c]
2023-11-28 - harnesses cable and compressor connector pin information confirm - Bought a new 4s battery for testing charge. - Coding algorithm for battery usage and charging usage to improve percent battery use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
2023-11-29 Although I completed the SOC algorithm, I found that the accuracy of SOC during discharge was not satisfactory, so I calibrated the algorithm.
2023-11-30 mainlogic -> Fix bug lid sensor reverse logic, and turn PID turn off fan and cmprsr
    [BQ25731.c, LCDController.c, PI4IOE.c, RTD.c, RTD.h, bms.c, bms.h, buzzer.h]
2023-12-05 Configuration on the version 2 board is complete, including peripherals and Gpio.
    [freezer_controler.cfg]
2023-12-06 Controller Board : SDCARD and USB API Code Writing Power Board : Power testing for the power board completed.
2023-12-07 The power of controller board and LCD tests have been completed.
2023-12-08 Completion of power on/off of the power board by STM32 control on the controller board, completion of heater and fan control.
2023-12-09 FatFS fix bug mounting for 2 two driver(SDcard done) Usb config and test connection ok.
    [BQ25731.c, BQ25731.h, DS1307.c, DS1307.h, File_Handling.c, File_Handling.h, LCDController.c, LCDController.h]
2023-12-12 - Firmware; USB Log.csv File Creating and UI text rotate 180 in progress. - Hardware; ▪ Re adjust FPC connector for screen to original location. ▪ Relocate programming pins location as per tonys sugg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
2023-12-13 Firmware update according to Bug2.2. - Firmware; USB Log.csv File Creating and UI text rotate 180 in progress - Hardware; update design for Compressor header J2(power_board) to Part number(3310208)
    [RTC.SchDoc, TopLevel.SchDoc]
2023-12-16 - Updated Harness design(BLG-319, 363, 364, 365). - Update Board design - J2 (on power board) Compressor header to be part number MOLEX WM10684-ND - Update Board Design - J2 on Controller board and J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
    [BOM_Power.xlsx, DisplayIface.SchDoc, Freezer_Controller.PrjPcb, Freezer_Power.PrjPcb, Pick Place for Freezer_Power.csv, TopLevel.SchDoc]
2023-12-19 I moved silkscreen of power board according the Q3 in EQ There were some silkscreen words that overlapped with the pad, so their positions were moved.
2023-12-19 move silkscreen in controller board.
    [Freezer_Controller.PrjPcb, Freezer_Power.PrjPcb, PcbLib1.PcbLib]
2023-12-23 Remove R83 on TopLevel.SchDoc
    [TopLevel.SchDoc]
2023-12-29 fix the footprint of J2 connector on power board.
    [Freezer_Power.PcbLib]
2024-01-04 fix the J19 footpirnt on Power board.
    [Freezer_Power.PcbLib, TopLevel.SchDoc]
