Aitoubella/Freezer_FW/(notices)

Notices in the files:
Firmware/controller_v2/Core/Src/main.c:
Copyright (c) 2023 STMicroelectronics.
All rights reserved.
